hscsja03-afk/-BJT-/board/hardware/bjt/pcb_layout.png

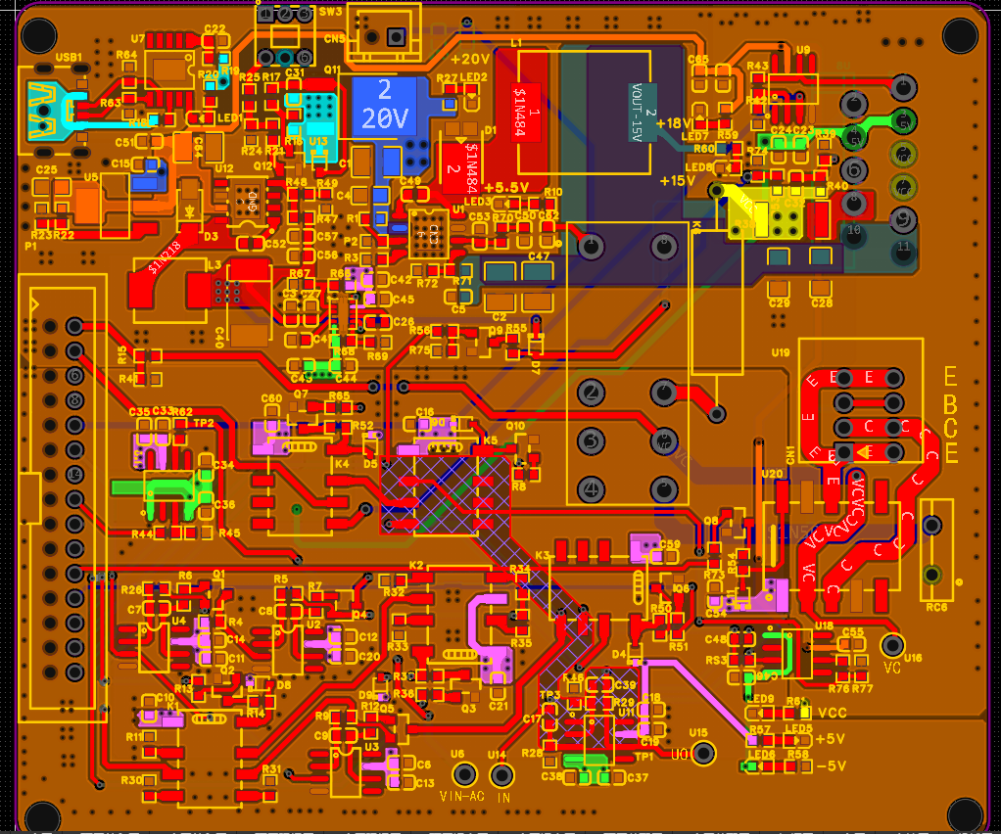
board/hardware/bjt/pcb_layout.png
