hscsja03-afk/-BJT-/board/hardware/bjt/pcb_3d.png

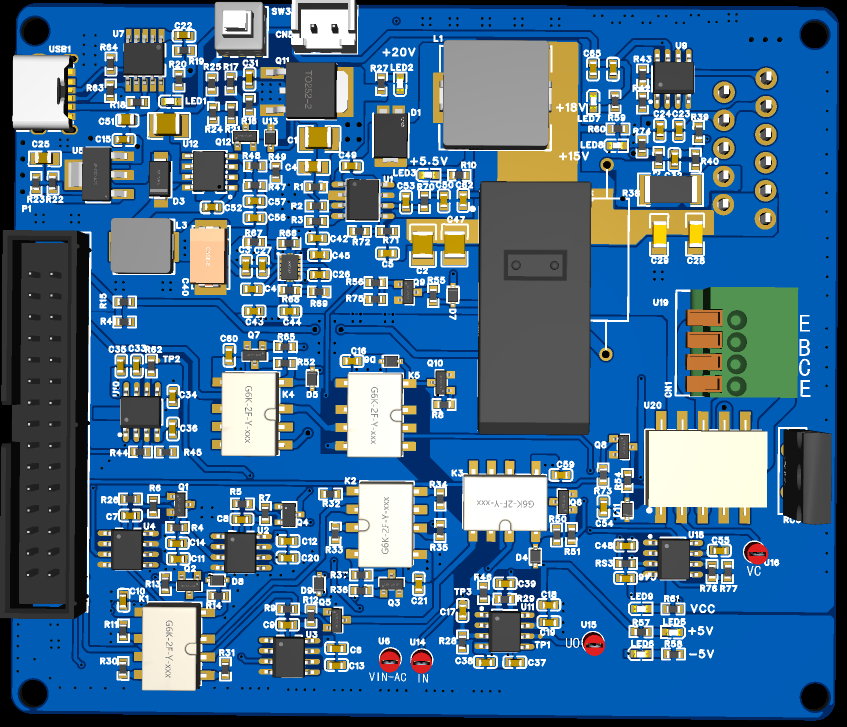
board/hardware/bjt/pcb_3d.png
