hscsja03-afk/-BJT-/readme.md

# 多功能三极管参数测量系统

基于 Zynq-7020、自制双通道高速 ADDA 底板和 BJT 测试板，集成三极管参数测量、信号发生器和双通道示波器。

| 功能 | 内容 |
| --- | --- |
| 三极管参数测量 | NPN/PNP 输入、输出、电流增益和交流特性，大功率器件脉冲测量 |
| 信号发生器 | 直流、正弦、方波、三角波及 CSV 自定义波形，按通道设置输出参数 |
| 双通道示波器 | 波形显示、帧内触发定位、A/B 游标、FFT 频谱及数据导出 |

## 工程目录

| 目录 | 内容与用途 |
| --- | --- |
| src/ | FPGA 逻辑、板端驱动和上位机源码 |
| sim/ | RTL 仿真和软件测试 |
| build/ | 构建脚本、依赖清单、时序与资源报告 |
| board/ | 硬件设计、位流、上板脚本、安装包和实测输出 |
| data/ | 校准表和器件手册 |
| skill/ | 可复用方法、校验脚本和记录模板 |
| report/ | 设计报告、开发记录和验证结果 |

## 运行上位机

下载并解压仓库，在 Windows x64 上双击 `board/launch.cmd`。首次启动会自动还原运行库，测量结果保存到 `measurements/`。

板端使用 PYNQ 2.7，默认地址 `192.168.0.4`、用户名 `xilinx`，密码在连接时输入。安装与位流加载见 [板端运行说明](board/readme.md)。

BJT 和电压测量使用 ADC 50 MHz；原始采样与频谱支持 62.5 MHz；DAC 时钟为 125 MHz。

## 源码运行与构建

电脑端使用 Python 3.13，在仓库根目录执行：

```powershell
.\build\setup.ps1
.\.venv\Scripts\python.exe build/checks/restore_archives.py
.\.venv\Scripts\python.exe -m zynq_bjt.desktop --workspace measurements
```

`restore_archives.py` 还原运行库、手册及实验数据，并检查 SHA256；加 `--group datasheets` 可只还原手册。

FPGA 使用 Vivado 2026.1，器件为 `xc7z020clg400-2`：

```powershell
.\build\rebuild_fpga.ps1 -Vivado "D:\FPGA\Xilix\2026.1\Vivado\bin\vivado.bat"
.\build\build_software.ps1
```

FPGA 工程输出在 `build/work/adc625_dac125/`，bit/HWH 与校验清单输出到 `build/dist/overlay/`；Python 安装包和 Windows 程序分别输出到 `build/dist/python/`、`build/dist/desktop/`。位流版本见 [板端运行说明](board/readme.md)，实现报告见 [工程验证与测试结果](report/verification.md)。

## 检查工程

```powershell
.\.venv\Scripts\python.exe build/checks/verify_package.py
.\.venv\Scripts\python.exe skill/pynq-overlay-audit/scripts/check_bundle.py board/overlay/manifest.json
$env:PYTHONPATH="$PWD/src/python"
.\.venv\Scripts\python.exe -m unittest discover -s sim/python -p "test_*.py" -v
.\.venv\Scripts\python.exe -m unittest discover -s src/python/tests -p "test_*.py" -v
```

`build/test.ps1` 运行软件测试，传入 `-Vivado` 可同时运行 RTL 仿真。`python build/checks/summarize_results.py` 计算实测比对表；加 `--plots` 生成曲线图。

## 材料入口

- [硬件设计](board/hardware/readme.md)：ADDA 底板与 BJT 测试板的可编辑工程、原理图、PCB 和网表。
- [设计报告 PDF](report/design_report.pdf)：设计原理、实现与实验结果。
- [提交材料索引](report/submission_checklist.md)：各项材料的位置。
- [实测索引](report/indexes/measurement_index.json)：24 组器件测量记录。
- [工程验证与测试结果](report/verification.md)：RTL、软件、综合实现与仪器比对。
- [实测指标汇总](report/measurements/summary.json)：24 组器件扫描、ADC 直流和 DAC 波形比对。
- [验证记录](report/validation/package_validation.json)：软件、RTL 和程序一致性检查。
- [技能包](skill/readme.md)：9 项可复用方法。

原始数据按 [归档索引](report/indexes/archive_index.json) 查找。[大模型协作记录](report/ai_collaboration.md) 精选四个案例，说明问题分析、方案取舍、验证结果和工程心得。

本项目编写的代码和文档采用 [MIT 许可](license.txt)。第三方代码、硬件资源、数据手册、字体及运行库保留各自版权与许可，见 [来源说明](report/source_provenance.md)。
