hscsja03-afk/-BJT-/skill/readme.md

# 可复用技能包

提供 PYNQ 位流校验、Zynq 启动诊断、时序分析、模拟校准和测量数据检查等可复用方法。按任务选择技能，替换板卡、接口、文件路径与验收条件即可复用。包含 9 项技能、两组独立校验脚本及实验/参数记录模板。

## 快速使用

1. 从下表选择任务，打开对应 `skill.md`。
2. 按入口准备输入并替换提示词中的方括号字段。
3. 运行操作步骤，填写 [实验记录](templates/experiment_record.md)，保存实际验证结果。
4. 换题目或板卡时重新填写接口与硬件条件。完整复制 `skill/` 可保留所有相对引用。

## 任务索引

| 技能 | 形式与适用场景 | 使用方法 | 已验证效果 | 失败或观察来源 | 失效条件 |
| --- | --- | --- | --- | --- | --- |
| [通用 PYNQ Overlay 校验](pynq-overlay-audit/skill.md) | 校验脚本、排错流程：换题目、换板卡或换 Vivado 构建时核对 bit/HWH、模块实例和地址。 | 填写 bit/HWH、实例、地址与哈希清单，运行 `check_bundle.py` 检查文件和地址 | 文件哈希、模块实例和地址校验；合成异名实例通过，错误地址与文件篡改触发拒绝。 | 早期只迁移 PL 文件，PS/DDR 配置没有随板卡匹配；物理通道名与 ADC A/B 顺序不同。 | 文件检查适用于包含 MODULE/MEMRANGE 的 HWH。更换元数据格式时先检查解析器；板上运行另需匹配 DDR、MIO、电压和时钟。 |
| [Zynq 启动与 DDR 分层定位](zynq-boot-ddr-diagnosis/skill.md) | 排错流程：FSBL 停滞、DDR 初始化失败、JTAG 可运行而自主启动异常。 | 按启动日志定位阶段，用 OCM 探针隔离 DDR，再按字节比较固定模式读写结果 | 项目中旧板最低字节错误与新板有限区域零错误形成对照；QSPI/eMMC 启动有独立冷启动记录。 | 曾将 OCM/禁用 DDR 的配置作为 Linux 启动基础，导致排查阶段混淆；仅依据软件 MMC 宏也容易误判拨码。 | DDR 完整型号、板卡版本和初始化来源必须对应。有限地址窗口的结果适用于该窗口；启动存储写入前保留可恢复副本。 |
| [FPGA 源码重建与时序核对](fpga-source-timing-closure/skill.md) | 工程工作流：迁移旧工程、变更采样时钟、检查外部 IO 时序。 | 收集 RTL/IP、约束和 PS 配置，以脚本重建并比较 WNS、WHS、CDC 和资源占用 | ADC62.5/DAC125 构建记录的建立/保持裕量为 0.394/0.041 ns；两档数字验证分别记录。 | 旧工程缓存和时钟变更容易造成“构建成功”与实际约束不一致；采样率提高也改变模拟校准条件。 | 目标器件、IO 电压、板级延时和 IP 版本改变时重新建立约束。时序裕量对应指定构建，电压精度使用独立校准结果。 |
| [寄存器到模拟输出定位](register-to-analog-debug/skill.md) | 校验脚本、踩坑流程：寄存器回读正常但输出异常；需要在实物照片上定位芯片或测点。 | 固定接线与仪表设置，对照写入顺序、回读和电压；用 `locate_epcb.py` 查 PCB 位号 | TX1 单次提交修正有 14 项示波器检查和独立冷启动复验；EPRO 定位脚本通过 U99 合成用例、缺失位号和多 PCB 选择测试，并查得PCB 中 U7 的坐标。 | 停用期间重复写 DATA 时出现回读正确而输出异常；图片标签曾误指 TX1 SMA，查询原理图和 PCB 后改指 U7。 | 初始化顺序修正须由目标器件的现象支持。定位脚本读取行式 JSON EPRO，可处理一层外部 ZIP；PCB坐标与照片像素需通过方向和锚点转换。 |
| [混合信号校准与单位管理](mixed-signal-calibration/skill.md) | 提示词工作流、实验模板：ADC/DAC 校准、预热漂移、量程或时钟切换。 | 固定量程、负载和温态，分别采集标定点与独立检查点，记录误差和单位换算 | 历史 ADC50 独立检查点最大偏差为 RX1 0.338 mV、RX2 0.394 mV（相对发生器标称值）；TX3 固定码正弦稳定窗口与直流中心分别判定。 | 曾混用峰值、Vpp、RMS和基波幅度；跟随预热漂移反复调码会掩盖稳定性问题。 | 改变板卡、改板、时钟、负载、频率或温态时重新评估校准适用范围。正弦换算关系仅用于相应波形定义。 |
| [测量扫描与性能对照](measurement-sweep-integrity/skill.md) | 提示词工作流、实验模板：输入/输出/电流增益/交流扫描、分段步进、反馈搜索及提速。 | 生成扫描计划，逐点保存设定、测点与耗时，用同点数、同条件比较改动前后 | 历史同条件输出扫描 111 点耗时由 63.397 s 降至 43.360 s；49 个偏置点的增益扫描由 169.181 s 降至 59.514 s。 | 深拷贝和重复传输影响扫描耗时；不同范围或点数的扫描直接比较会夸大优化效果。 | 负载、器件档位、等待窗口或偏置误差改变时重新建立对照。模型拟合只在有效测量范围内解释，外推结果单独标注。 |
| [上位机与板端代理一致发行](desktop-agent-release/skill.md) | 排错流程、发行模板：Windows GUI、板端 Python 代理、位流和校准数据的打包与部署。 | 建立程序、代理与数据哈希清单，在独立目录打包，部署后读回校验并检查启动入口 | 项目已采用包/代理/数据读回校验和明确的启动入口；取消、迟到帧、路径定位和初始化顺序有对应离线回归。 | 曾出现源码修复但代理包仍旧、数据依赖启动目录、停止后的迟到帧刷新界面等问题。 | 版本和路径需从目标工程取得。程序、代理、位流及数据作为一组回滚；界面预览、程序自检、服务重启和冷启动各有自己的验收条件。 |
| [数据手册参数与页码追溯](datasheet-parameters/skill.md) | 审阅工作流、案例模板：晶体管或其他电子器件 PDF 参数表整理。 | 填写 `parameter_record.json`，逐项核对型号、页码、单位、参数角色和测试条件 | 项目参数流程采用页码、原表单元格和条件关联，参数行可回到来源页面；本包提供可直接套用的参数记录模板。 | 合并表头、不同型号列、PNP负号及最大额定值与推荐工作条件容易混淆。 | 扫描PDF需OCR和页面比对；缺少型号或条件的行保持原文记录，取得来源后再换算。手册额定值与实际扫描范围分别管理。 |
| [技术海报与证据图组织](technical-poster-evidence/skill.md) | 提示词工作流、案例模板：将硬件、PYNQ架构、上位机和实测结果组织为单页技术海报。 | 建立素材表，将架构、实物和实测结果组织为可编辑对象，再核对图表与版面 | 项目完成单页英文 A4 海报、可编辑架构和原始数据图表；经过 PowerPoint 打开及 PDF 渲染检查，并加入用户提供的上位机界面。 | 首版信息密度接近报告；改成视觉版后遗漏 PYNQ 架构；芯片指引线曾落在接口。这些反馈形成内容清单和源文件定位步骤。 | 模板、语言、匿名和打印要求以具体任务为准。效果图用于表达，器件定位采用原图与PCB；界面中的模拟标识和空曲线保持原状。 |

## 本队题目之外的应用场景

下表列出各项方法可迁移的任务。具体替换项和输出要求同时写入各项 `skill.md`；已验证效果按本项目的实际记录列在任务索引中。

| 技能 | 其他应用场景 | 迁移时替换的内容 |
| --- | --- | --- |
| [通用 PYNQ Overlay 校验](pynq-overlay-audit/skill.md) | PYNQ 图像处理加速器、数据采集卡、电机控制外设 | bit/HWH、外设实例、地址窗口与哈希 |
| [Zynq 启动与 DDR 分层定位](zynq-boot-ddr-diagnosis/skill.md) | 其他 Zynq-7000 核心板、采集终端和机器人控制板的启动排错 | DDR 型号、PS 配置、启动介质与日志 |
| [FPGA 源码重建与时序核对](fpga-source-timing-closure/skill.md) | 摄像头接口、数字滤波器、高速传感器采集和 FPGA 工程版本迁移 | 器件、时钟、IO 和板级时序约束 |
| [寄存器到模拟输出定位](register-to-analog-debug/skill.md) | DAC 信号源、可编程电源、可编程增益放大器的驱动调试 | 寄存器、总线、启停顺序和测点 |
| [混合信号校准与单位管理](mixed-signal-calibration/skill.md) | 温度/压力传感器采集、信号发生器、可编程电源和 ADC/DAC 测试 | 物理量、仪器、量程、负载与温态 |
| [测量扫描与性能对照](measurement-sweep-integrity/skill.md) | MOSFET 或二极管伏安测试、滤波器扫频、传感器自动标定 | 扫描变量、偏置控制、等待条件与拟合模型 |
| [上位机与板端代理一致发行](desktop-agent-release/skill.md) | 上位机加嵌入式代理的采集终端、自动测试台和机器人调试工具 | 通信协议、启动入口、代理模块和配置清单 |
| [数据手册参数与页码追溯](datasheet-parameters/skill.md) | MOSFET、运算放大器、ADC/DAC、电源芯片的选型与参数整理 | 器件型号、参数符号、单位和测试条件 |
| [技术海报与证据图组织](technical-poster-evidence/skill.md) | 其他嵌入式作品的科研展示、竞赛展板和项目汇报图 | 架构、照片、界面、实验结果与展示尺寸 |

## 通用 PYNQ 校验

`pynq-overlay-audit` 通过清单输入位流、HWH、外设实例和地址，脚本不固定板卡、题目或工程路径。`--example` 输出清单格式；自带测试覆盖合法配置、地址错误和哈希错误。PS/DDR、电压与模拟条件按目标板另行核对。

## 单独复制后的使用

复制整个 `skill/` 目录即可带走说明、提示词、模板、脚本、测试和许可。在复制后的目录内执行：

```sh
python pynq-overlay-audit/scripts/check_bundle.py --example
python -m unittest discover -s pynq-overlay-audit/scripts -p "test_*.py" -v
python -m unittest discover -s register-to-analog-debug/scripts -p "test_*.py" -v
```

两组脚本仅使用 Python 标准库。处理自己的工程时，将位流、HWH、外设实例和地址填入清单，运行 `check_bundle.py path/to/manifest.json`；路径相对于清单所在目录解析。其余流程使用各项 `skill.md` 的输入条件和操作步骤，并填写本目录的实验模板。

通用 PYNQ 校验以文件和清单为输入，可以独立于本项目使用。测试包含 `image_filter_0` 与 `motor_ctrl_1` 两种外设实例、不同地址窗口以及从其他工作目录执行的情况；这些合成用例检查工具的通用性和路径处理。

## 验证记录

参见 [validation.json](validation.json)。脚本测试使用合成配置，硬件案例采用指定日期、版本和条件的记录。协作提示词是从上述过程提炼的复用模板；原始对话按实验模板关联保存。

## 开源协议

本项目编写的技能文档、模板和脚本采用 [MIT 许可](license.txt)，允许使用、修改和再分发，分发时保留版权与许可声明。第三方代码、硬件资源、数据手册、字体及依赖保留各自版权与许可。
