hscsja03-afk/-BJT-/sim/readme.md

# RTL 仿真与软件测试

RTL 仿真与软件测试。

从仓库根目录执行：

```powershell
.\build\test.ps1 -Vivado "C:\AMD\2026.1\Vivado\bin\vivado.bat"
```

| 目录 | 内容 |
| --- | --- |
| [baremetal/](baremetal/) | 裸机 C 驱动与时间基准测试 |
| [fixtures/](fixtures/) | 仿真测试输入 |
| [python/](python/) | 驱动、扫描、分析与界面测试 |
| [results/](results/) | RTL、软件与程序运行结果 |
| [rtl/](rtl/) | AXI、ADC、DAC 与 LCD 仿真 |
