hscsja03-afk/-BJT-/build/reports/readme.md

# FPGA 各版本资源与时序报告

FPGA 各版本资源与时序报告。

| 目录 | 内容 |
| --- | --- |
| [adc625_mmcm_20261102/](adc625_mmcm_20261102/) | ADC 62.5 MHz 与 DAC 125 MHz 实现报告 |
| [baseline50/](baseline50/) | ADC/DAC 50 MHz 基线实现报告 |
| [lcd_ddr_20261104/](lcd_ddr_20261104/) | LCD DDR 2026-11-04 构建与实现报告 |
| [lcd_ddr_final_20261103/](lcd_ddr_final_20261103/) | LCD DDR 2026-11-03 实现报告 |
| [target125_250/](target125_250/) | ADC 125 MHz 与 DAC 250 MHz 时序报告 |
