hscsja03-afk/-BJT-/sim/rtl/readme.md

# AXI、ADC、DAC 与 LCD 仿真

AXI、ADC、DAC 与 LCD 仿真。

## 文件

- [run_adc_depth.tcl](run_adc_depth.tcl)
- [run_axi.tcl](run_axi.tcl)
- [run_lcd.tcl](run_lcd.tcl)
- [run_lcd_ddr.tcl](run_lcd_ddr.tcl)
- [tb_adc_depth.sv](tb_adc_depth.sv)
- [tb_adc_statistics.sv](tb_adc_statistics.sv)
- [tb_adc_stride.sv](tb_adc_stride.sv)
- [tb_adda.sv](tb_adda.sv)
- [tb_dac_5mhz.sv](tb_dac_5mhz.sv)
- [tb_dac_axi.sv](tb_dac_axi.sv)
- [tb_lcd_ddr.sv](tb_lcd_ddr.sv)
- [tb_lcd_graphics.sv](tb_lcd_graphics.sv)
