hscsja03-afk/-BJT-/sim/baremetal/readme.md

# 裸机 C 驱动与时间基准测试

裸机 C 驱动与时间基准测试。

从仓库根目录执行：

```powershell
.\sim\baremetal\run_baremetal_c.ps1 -Gcc "C:\path\to\gcc.exe"
```

## 文件

- [baremetal_faults.c](baremetal_faults.c)
- [baremetal_timebase.c](baremetal_timebase.c)
- [run_baremetal_c.ps1](run_baremetal_c.ps1)
