hscsja03-afk/-BJT-/board/storage/readme.md

# QSPI 与 eMMC 映像工具

QSPI 备份与候选映像、eMMC 映像写入、网络传输及存储状态检查。

## 文件

- [backup_qspi_ram.tcl](backup_qspi_ram.tcl)
- [build_emmc_image_writer.ps1](build_emmc_image_writer.ps1)
- [build_emmc_network_writer.ps1](build_emmc_network_writer.ps1)
- [emmc_image_writer.c](emmc_image_writer.c)
- [flash_tool_help.tcl](flash_tool_help.tcl)
- [inspect_emmc_boot_readonly.tcl](inspect_emmc_boot_readonly.tcl)
- [monitor_emmc_network_writer.tcl](monitor_emmc_network_writer.tcl)
- [poweroff_for_flash.py](poweroff_for_flash.py)
- [prepare_pynq_qspi.bif](prepare_pynq_qspi.bif)
- [run_emmc_image_writer.ps1](run_emmc_image_writer.ps1)
- [run_emmc_image_writer.tcl](run_emmc_image_writer.tcl)
- [run_emmc_network_writer.ps1](run_emmc_network_writer.ps1)
- [run_emmc_network_writer.tcl](run_emmc_network_writer.tcl)
- [send_emmc_image_network.py](send_emmc_image_network.py)
- [stage_qspi_candidate.tcl](stage_qspi_candidate.tcl)
