hscsja03-afk/-BJT-/board/lcd/readme.md

# LCD 显示、帧缓冲与设备控制

管理本地显示、DDR 帧缓冲、显示切换及上位机共享波形。

## 文件

- [lcd_ddr_check.py](lcd_ddr_check.py)
- [lcd_live.py](lcd_live.py)
- [lcd_native_switch.py](lcd_native_switch.py)
- [manage_lcd_ddr.py](manage_lcd_ddr.py)
- [manage_lcd_native.py](manage_lcd_native.py)
- [run_lcd_live.py](run_lcd_live.py)
- [stage_lcd_candidate.py](stage_lcd_candidate.py)
- [verify_shared_lcd.py](verify_shared_lcd.py)
