hscsja03-afk/-BJT-/board/diagnostics/readme.md

# 采样、输出、DDR 与器件诊断

采样、输出、DDR 与器件诊断。

| 目录 | 内容 |
| --- | --- |
| [adc/](adc/) | ADC 采样时钟与频谱检查 |
| [bjt/](bjt/) | 三极管接线、反馈与扫描检查 |
| [ddr/](ddr/) | DDR 初始化、训练与字节通道诊断 |
| [tx1/](tx1/) | TX1 总线、寄存器与输出检查 |
| [tx23/](tx23/) | TX2/TX3 波形、零点与稳定性检查 |
