hscsja03-afk/-BJT-/board/connection/readme.md

# SSH、串口与设备连接

SSH、串口与设备连接。

## 文件

- [capture_uart.ps1](capture_uart.ps1)
- [configure_pynq_test_network.sh](configure_pynq_test_network.sh)
- [deploy_desktop_uart.py](deploy_desktop_uart.py)
- [pynq_ssh.py](pynq_ssh.py)
- [pynq_uart.py](pynq_uart.py)
- [uart_root_task.py](uart_root_task.py)
- [verify_desktop_connection.py](verify_desktop_connection.py)
- [verify_desktop_initialize.py](verify_desktop_initialize.py)
