hscsja03-afk/-BJT-/build/reports/target125_250/readme.md

# ADC 125 MHz 与 DAC 250 MHz 时序报告

ADC 125 MHz 与 DAC 250 MHz 时序报告。

## 文件

- [bus_skew.rpt](bus_skew.rpt)
- [cdc.rpt](cdc.rpt)
- [drc.rpt](drc.rpt)
- [io.rpt](io.rpt)
- [ps_config.txt](ps_config.txt)
- [timing.xdc](timing.xdc)
- [timing_summary.rpt](timing_summary.rpt)
- [utilization.rpt](utilization.rpt)
