hscsja03-afk/-BJT-/build/reports/baseline50/readme.md

# ADC/DAC 50 MHz 基线实现报告

ADC/DAC 50 MHz 基线实现报告。

## 文件

- [build_status.txt](build_status.txt)
- [bus_skew.rpt](bus_skew.rpt)
- [cdc.rpt](cdc.rpt)
- [drc.rpt](drc.rpt)
- [io.rpt](io.rpt)
- [ps_config.txt](ps_config.txt)
- [timing.xdc](timing.xdc)
- [timing_summary.rpt](timing_summary.rpt)
- [utilization.rpt](utilization.rpt)
