hscsja03-afk/-BJT-/build/reports/adc625_mmcm_20261102/readme.md

# ADC 62.5 MHz 与 DAC 125 MHz 实现报告

ADC 62.5 MHz 与 DAC 125 MHz 实现报告。

## 文件

- [build_status.txt](build_status.txt)
- [bus_skew.rpt](bus_skew.rpt)
- [cdc.rpt](cdc.rpt)
- [drc.rpt](drc.rpt)
- [drc_50mhz.rpt](drc_50mhz.rpt)
- [io.rpt](io.rpt)
- [ps_config.txt](ps_config.txt)
- [timing.xdc](timing.xdc)
- [timing_50mhz.rpt](timing_50mhz.rpt)
- [timing_summary.rpt](timing_summary.rpt)
- [utilization.rpt](utilization.rpt)
