hscsja03-afk/-BJT-/board/hardware/bjt/readme.md

# 三极管测试板硬件设计

包含可编辑工程、网表、PCB 布局与三维图，以及电流源、功率放大、电源、极性切换和测量切换等电路图。

- [hardware_project.epro2](hardware_project.epro2)
- [netlist.tel](netlist.tel)
- [pcb_3d.png](pcb_3d.png)
- [pcb_layout.png](pcb_layout.png)
- [schematic_ac.png](schematic_ac.png)
- [schematic_base_current_source.png](schematic_base_current_source.png)
- [schematic_dual_supply.png](schematic_dual_supply.png)
- [schematic_interface.png](schematic_interface.png)
- [schematic_measurement_switch.png](schematic_measurement_switch.png)
- [schematic_polarity_switch.png](schematic_polarity_switch.png)
- [schematic_power_amplifier.png](schematic_power_amplifier.png)
