hscsja03-afk/-BJT-/board/hardware/adda/readme.md

# 双通道高速 ADDA 硬件设计

包含可编辑工程、原理图、网表、PCB 三维图，以及 AD9747 固件说明和 AD9516 配置资料。

- [ad9516_config_01.png](ad9516_config_01.png)
- [ad9516_config_02.png](ad9516_config_02.png)
- [ad9747_firmware_guide.md](ad9747_firmware_guide.md)
- [design_notes.xlsx](design_notes.xlsx)
- [hardware_project.epro](hardware_project.epro)
- [netlist.tel](netlist.tel)
- [pcb_3d.png](pcb_3d.png)
- [schematic.pdf](schematic.pdf)
