hscsja03-afk/-BJT-/src/rtl/touch/readme.md

# 触摸屏控制逻辑

触摸屏控制逻辑。

## 文件

- [i2c_dri.v](i2c_dri.v)
- [touch_cdc.sv](touch_cdc.sv)
- [touch_dri.v](touch_dri.v)
- [touch_top.v](touch_top.v)
