hscsja03-afk/-BJT-/board/diagnostics/adc/readme.md

# ADC 采样时钟与频谱检查

ADC 采样时钟与频谱检查。

## 文件

- [check_adc_dual_rate.py](check_adc_dual_rate.py)
- [check_adc_rate_candidate.py](check_adc_rate_candidate.py)
- [check_rx1_square_fft.py](check_rx1_square_fft.py)
- [stage_adc4096.py](stage_adc4096.py)
- [stage_adc_rate_candidate.py](stage_adc_rate_candidate.py)
- [verify_adc_rate_release.py](verify_adc_rate_release.py)
