hscsja03-afk/-BJT-/report/design_report.md

# 多功能三极管参数测量系统工程说明

## 任务与结构

本系统集成三极管参数测量、信号发生器和双通道示波器。FPGA 完成确定时序的采集、激励和接口控制，PS 软件管理设备，上位机组织扫描、波形显示、分析与结果保存。三极管测量覆盖 NPN/PNP 的小功率与大功率档；信号发生器支持直流、正弦、方波、三角波和 CSV 自定义波形；示波器提供波形显示、帧内触发定位、游标和 FFT 频谱。

两套硬件的可编辑工程、原理图、PCB 预览和网表见 [硬件设计资料](../board/hardware/readme.md)。

```text
Windows 上位机 -- SSH / JSON -- Zynq PS（PYNQ / Python）
                                    |
                                 AXI GP0
                                    |
                 PL：ADDA / 波形发生 / GPIO / LCD
                      |                     |
                 双路 ADC              TX1 / TX2 / TX3
                      |                     |
                      +---- BJT 测试板 -----+
```

PL 地址窗口为 0x43C00000、64 KiB。ADC 支持每路 256～4096 点和 1～256 倍抽取；数据经分帧读取送到主机。抽取用于扩展记录时间窗口，输入频率按抽取后采样率的奈奎斯特条件选择。ADC 50/62.5 MHz、DAC 125 MHz 为物理转换时钟，主机采用分帧传输。

RTL 主体位于 src/rtl/adda_core.v；ADC 捕获、统计与时钟分别在 adc_capture.v、adc_statistics.sv、adc_clocking.v；DAC 波形和时钟分别在 dac_awg.v、dac_generator.v、dac_clocking.v。上位机入口为 src/python/zynq_bjt/desktop.py；寄存器、会话、扫描与分析由 mmio.py、runtime.py、desktop_session.py、characteristics.py 等模块组织。

## 测量与数据

输入测量使用反馈搜索控制工作点；输出特性按基极条件分组扫描，并可拟合 Early 参数。电流增益由工作点电流计算，交流测量拟合频率响应，并保存输入阻抗及特征频率分析。大功率脉冲方式在稳定高电平窗口取样，频率、占空比和尝试次数随记录保存。

物理通道为测试板 ADC2 对应 ADDA RX1，测试板 ADC1 对应 ADDA RX2。输入模式的 VB 衰减比例、输出模式的 VCC 比例及不同档位的电阻独立配置。当前配置以 data/bjt_parameter_basis.json、frontend.json 和每次 run.json 为准，各档位独立读取换算参数。PNP 输入的 VE 使用实测换算表，相关数据见 data/ve_feedback_calibration.json。

每次运行保存配置、校准身份、测点 CSV、原始帧、结束状态及清理结果。PNP 交流增益、输入电阻曲线及导出图片均使用实际采集的测点。包内代表性数据按 [实测索引](indexes/measurement_index.json) 定位；选取规则为每个档位、项目及方法中最近一次 complete 且 simulated=false 的记录。记录同时保存器件身份、标定条件和拟合结果。

## 时序与资源

下表直接摘取包内 Vivado 报告。各版本的功能配置与资源占用一并对照。

| 实现（ADC/DAC） | LUT | 寄存器 | BRAM Tile | DSP | WNS/ns | WHS/ns |
| --- | --- | --- | --- | --- | --- | --- |
| 50/50 MHz 历史基线 | 3158 | 2399 | 40 | 0 | 1.813 | 0.025 |
| 62.5/125 MHz 正式实现 | 3784 | 3181 | 67 | 2 | 0.394 | 0.041 |
| 125/250 MHz 目标尝试 | 3157 | 2399 | 40 | 0 | -8.235 | -2.072 |
| 62.5/125 MHz LCD DDR 构建（2026-11-04） | 3889 | 3184 | 123 | 2 | 0.394 | 0.035 |

正式实现通过既有建立/保持时间检查，保留 DRC、CDC 和总线偏斜报告。125/250 MHz 配置的负裕量见表，正式输出采用 62.5/125 MHz 配置。ADC 的 IOB 寄存器和 MMCM 时钟补偿解决了提高物理采样时钟时的保持时间问题；62.5 MHz 相对 50 MHz 的采样率增加 25%；扫描耗时另由测量记录统计。

2026-11-04 LCD DDR 构建的位流位于 `board/overlay/build_20261104/`，源码摘要、资源和时序报告位于 `build/reports/lcd_ddr_20261104/`。仪器与三极管实测记录对应采集时的位流，具体哈希及比对指标见 [工程验证与测试结果](verification.md)。

## 验证方法与工作条件

本包收录软件行为回归、RTL 仿真脚本及历史板级证据。时钟升频的双 ADC 数字模式、原始采集及频谱验证见 adc_rate_raise_20261102。RX1/RX2 直流校准以发生器标称值为基准；TX2/TX3 的参考为示波器，频率、幅度、负载及带宽条件逐点保留。精度数据按对应通道、参考仪器及测量条件报告。

本包的软件回归、RTL 仿真、运行程序及文件一致性检查见 [工程验证记录](validation/package_validation.json)。板级记录按时间、位流哈希和校准身份索引。源码重建后按新时序报告、数字自检、模拟测量和校准身份完成版本验收。

## 大模型协作与方案取舍

协作集中在启动定位、驱动行为、时序收敛和模拟校准四类问题。模型参与整理候选原因、代码路径和实验数据，方案通过对照实验筛选：

- DDR 定位采用固定探针和按字节统计，版本回退与训练起点调整均由读写结果判断；最低字节持续出错，使排查重点转向相应板级链路。
- TX1 将停用期间的目标码缓存在软件中，启用前单次写入 DATA，替换停用期间重复写入的顺序；示波器检查与冷启动复验共同确认输出行为。
- ADC/DAC 采用具有正建立、保持裕量的 62.5/125 MHz 实现，放弃该次存在负裕量的 125/250 MHz 候选；采样时序和电压校准分别验收。
- TX2/TX3 采用分通道校准和固定条件的开关对照，将单路标定误差与同时工作引入的偏移分开记录。

这些过程形成的经验是：将解释转为可检验的假设，保留相同条件下的对照结果，再决定采用、修改或放弃方案。交互要点、纠错过程、数值和依据见 [大模型协作记录](ai_collaboration.md)。

## 复现与经验

完整运行顺序见根目录 readme.md 和 board/readme.md。先核对位流/HWH、PS 配置和物理通道，再验证数字链路，最后执行模拟校准与器件扫描。更新上位机时同时核对板端代理和数据表，避免只有界面升级而设备行为仍停留在旧版。

skill/ 将位流配对、启动诊断、时序迁移、寄存器到模拟链路定位、校准、扫描完整性、发行一致性和数据手册提取整理为九项方法。各方法提供操作条件、问题定位步骤和验证数据。
