hscsja03-afk/-BJT-/board/desktop/desktop_workbench.md

# 上位机使用

仓库版入口为 board/launch.cmd，首次启动自动还原运行库。电脑程序、板端代理和校准数据按同一源码构建。连接后执行初始化及数字自检，再按界面确认测试板接线与档位。BJT 和电压换算使用 ADC 50 MHz，62.5 MHz 用于原始码采集和频谱分析。

测量数据保存在 measurements/，包含配置、校准身份、原始帧和测点表。取消或结束测量时保存已取得的数据并关闭输出。源码环境、构建和完整复现命令见根目录 readme.md。
