hscsja03-afk/-BJT-/report/readme.md

# 设计报告、实测结果与协作记录

设计报告、实测结果与协作记录。

| 目录 | 内容 |
| --- | --- |
| [hardware/](hardware/) | 启动、接口与板级实测记录 |
| [indexes/](indexes/) | 工程、报告与数据索引 |
| [measurements/](measurements/) | 实测指标统计 |
| [validation/](validation/) | 软件、程序包与工程校验记录 |

## 文件

- [ai_collaboration.md](ai_collaboration.md)
- [design_report.md](design_report.md)
- [design_report.pdf](design_report.pdf)
- [source_provenance.md](source_provenance.md)
- [submission_checklist.md](submission_checklist.md)
- [verification.md](verification.md)
