hscsja03-afk/-BJT-/src/readme.md

# FPGA、板端与上位机源码

FPGA、板端与上位机源码。

| 目录 | 内容 |
| --- | --- |
| [assets/](assets/) | LCD 字体与显示资源 |
| [baremetal/](baremetal/) | 裸机驱动、启动与时间基准 |
| [constraints/](constraints/) | FPGA 引脚、电平与时序约束 |
| [python/](python/) | 测量驱动、板端代理与上位机程序 |
| [rtl/](rtl/) | ADDA、AXI、时钟与显示逻辑 |
