hscsja03-afk/-BJT-/data/readme.md

# 校准参数、器件手册与实测数据

校准参数、器件手册与实测数据。

| 目录 | 内容 |
| --- | --- |
| [datasheets/](datasheets/) | 器件手册与参数资料 |
| [evidence/](evidence/) | 采集、校准与板级实验数据归档 |
| [measurements/](measurements/) | ADC、DAC 与三极管实测比对 |
| [ui/](ui/) | 上位机界面资源 |

## 文件

- [adc_input_limits.json](adc_input_limits.json)
- [bjt_parameter_basis.json](bjt_parameter_basis.json)
- [dac_calibration.json](dac_calibration.json)
- [frontend.json](frontend.json)
- [hardware_revision.json](hardware_revision.json)
- [runtime_manifest.json](runtime_manifest.json)
- [rx1_dc_calibration.json](rx1_dc_calibration.json)
- [rx2_calibration.json](rx2_calibration.json)
- [tx2_waveform_calibration.json](tx2_waveform_calibration.json)
- [tx3_waveform_calibration.json](tx3_waveform_calibration.json)
- [ve_feedback_calibration.json](ve_feedback_calibration.json)
