hscsja03-afk/-BJT-/report/indexes/readme.md

# 工程、报告与数据索引

工程、报告与数据索引。

## 文件

- [archive_index.json](archive_index.json)
- [document_sources.json](document_sources.json)
- [measurement_index.json](measurement_index.json)
- [repository_layout.json](repository_layout.json)
