hscsja03-afk/-BJT-/report/hardware/readme.md

# 启动、接口与板级实测记录

启动、接口与板级实测记录。

## 文件

- [baremetal_hardware_evidence.json](baremetal_hardware_evidence.json)
- [ddr_new_board_20261029.json](ddr_new_board_20261029.json)
- [desktop_initialize_fixed_v2_20261030.json](desktop_initialize_fixed_v2_20261030.json)
- [desktop_tx1_agent_deploy_20261030.json](desktop_tx1_agent_deploy_20261030.json)
- [desktop_tx1_fix_packaged_20261030.json](desktop_tx1_fix_packaged_20261030.json)
- [desktop_tx1_fix_promoted_20261030.json](desktop_tx1_fix_promoted_20261030.json)
- [factory_sd_evidence.json](factory_sd_evidence.json)
- [hardware_evidence.json](hardware_evidence.json)
- [nanya_profile_audit.json](nanya_profile_audit.json)
- [pynq_custom50_hardware_evidence_20261030.json](pynq_custom50_hardware_evidence_20261030.json)
- [pynq_custom50_jtag_20261030_003445.json](pynq_custom50_jtag_20261030_003445.json)
- [pynq_linux_overlay_20261030.json](pynq_linux_overlay_20261030.json)
- [qspi_coldboot_verify_20261030.json](qspi_coldboot_verify_20261030.json)
- [tx1_fix_coldboot_verification_20261030.json](tx1_fix_coldboot_verification_20261030.json)
- [tx1_fix_startup_verification_20261030.json](tx1_fix_startup_verification_20261030.json)
- [tx1_pynq_scope_acceptance_20261030.json](tx1_pynq_scope_acceptance_20261030.json)
- [tx1_pynq_scope_coldboot_20261030.json](tx1_pynq_scope_coldboot_20261030.json)
- [tx1_root_cause_20261030.json](tx1_root_cause_20261030.json)
- [tx1_startup_agent_update_20261030.json](tx1_startup_agent_update_20261030.json)
