hscsja03-afk/-BJT-/src/rtl/readme.md

# ADDA、AXI、时钟与显示逻辑

ADDA、AXI、时钟与显示逻辑。

| 目录 | 内容 |
| --- | --- |
| [touch/](touch/) | 触摸屏控制逻辑 |

## 文件

- [adc_capture.v](adc_capture.v)
- [adc_clocking.v](adc_clocking.v)
- [adc_statistics.sv](adc_statistics.sv)
- [adda_core.v](adda_core.v)
- [adda_dac_gui_top.v](adda_dac_gui_top.v)
- [cdc_sync.v](cdc_sync.v)
- [dac_awg.v](dac_awg.v)
- [dac_clocking.v](dac_clocking.v)
- [dac_generator.v](dac_generator.v)
- [dac_text.sv](dac_text.sv)
- [gpio_control.sv](gpio_control.sv)
- [gpio_ui.sv](gpio_ui.sv)
- [lcd_ddr_reader.sv](lcd_ddr_reader.sv)
- [lcd_gpio_top.sv](lcd_gpio_top.sv)
- [lcd_graphics.sv](lcd_graphics.sv)
- [lcd_output_stage.sv](lcd_output_stage.sv)
- [lcd_timing.sv](lcd_timing.sv)
- [sine256.mem](sine256.mem)
