hscsja03-afk/-BJT-/src/constraints/readme.md

# FPGA 引脚、电平与时序约束

FPGA 引脚、电平与时序约束。

## 文件

- [gpio_pins.xdc](gpio_pins.xdc)
- [lcd_pins.xdc](lcd_pins.xdc)
- [lcd_timing.xdc](lcd_timing.xdc)
- [pins.xdc](pins.xdc)
- [timing.xdc](timing.xdc)
- [tx1.xdc](tx1.xdc)
