hscsja03-afk/-BJT-/src/baremetal/readme.md

# 裸机驱动、启动与时间基准

裸机驱动、启动与时间基准。

## 文件

- [adda.c](adda.c)
- [adda.h](adda.h)
- [main.c](main.c)
- [timebase.h](timebase.h)
