hscsja03-afk/-BJT-/src/assets/readme.md

# LCD 字体与显示资源

LCD 字体与显示资源。

## 文件

- [font.mem](font.mem)
- [gpio_background.mem](gpio_background.mem)
