hscsja03-afk/-BJT-/skill/templates/readme.md

# 实验记录与参数表模板

实验记录与参数表模板。

## 文件

- [experiment_record.md](experiment_record.md)
- [parameter_record.json](parameter_record.json)
