hscsja03-afk/-BJT-/sim/fixtures/readme.md

# 仿真测试输入

仿真测试输入。

## 文件

- [npn_pulse_noisy_plateau.json](npn_pulse_noisy_plateau.json)
- [pnp_pulse_noisy_plateau.json](pnp_pulse_noisy_plateau.json)
- [pulse_zero_noise.json](pulse_zero_noise.json)
