hscsja03-afk/-BJT-/data/ui/readme.md

# 上位机界面资源

上位机界面资源。

## 文件

- [fpga_competition_10th_hd.png](fpga_competition_10th_hd.png)
- [fpga_competition_10th_hd.source.json](fpga_competition_10th_hd.source.json)
