hscsja03-afk/-BJT-/data/evidence/readme.md

# 采集、校准与板级实验数据归档

各 ZIP 对应一个实验主题；归档成员和校验值见 build/archive_manifest.json。

## 文件

- [evidence_adc_rate_raise_20261102.zip](evidence_adc_rate_raise_20261102.zip)
- [evidence_bjt_all_profiles_20261030.zip](evidence_bjt_all_profiles_20261030.zip)
- [evidence_desktop_fast_fixed_axes_20261031.zip](evidence_desktop_fast_fixed_axes_20261031.zip)
- [evidence_desktop_progressive_20261102.zip](evidence_desktop_progressive_20261102.zip)
- [evidence_desktop_responsiveness_20261031.zip](evidence_desktop_responsiveness_20261031.zip)
- [evidence_evidence.zip](evidence_evidence.zip)
- [evidence_input_settling_20261101.zip](evidence_input_settling_20261101.zip)
- [evidence_lcd_ddr_20261103.zip](evidence_lcd_ddr_20261103.zip)
- [evidence_linked_sweep_parameters_20261031.zip](evidence_linked_sweep_parameters_20261031.zip)
- [evidence_npn_pulse_fix_20261103.zip](evidence_npn_pulse_fix_20261103.zip)
- [evidence_pnp_pulse_fix_20261103.zip](evidence_pnp_pulse_fix_20261103.zip)
- [evidence_pnp_pulse_window_20261103.zip.001](evidence_pnp_pulse_window_20261103.zip.001)
- [evidence_pnp_pulse_window_20261103.zip.002](evidence_pnp_pulse_window_20261103.zip.002)
- [evidence_pnp_pulse_window_20261103.zip.003](evidence_pnp_pulse_window_20261103.zip.003)
- [evidence_pnp_pulse_window_20261103.zip.004](evidence_pnp_pulse_window_20261103.zip.004)
- [evidence_pulse_fix_20261102.zip](evidence_pulse_fix_20261102.zip)
- [evidence_rx1_generator_nominal_20261030.zip](evidence_rx1_generator_nominal_20261030.zip)
- [evidence_rx2_ac_generator_20261031.zip](evidence_rx2_ac_generator_20261031.zip)
- [evidence_rx2_generator_nominal_20261031.zip](evidence_rx2_generator_nominal_20261031.zip)
- [evidence_tx23_calibration_20261030.zip](evidence_tx23_calibration_20261030.zip)
- [evidence_tx23_recalibration_20261103.zip.001](evidence_tx23_recalibration_20261103.zip.001)
- [evidence_tx23_recalibration_20261103.zip.002](evidence_tx23_recalibration_20261103.zip.002)
- [evidence_tx3_lcd_compat_20261103.zip](evidence_tx3_lcd_compat_20261103.zip)
- [evidence_tx3_multi_final_20261101.zip](evidence_tx3_multi_final_20261101.zip)
- [evidence_tx3_multi_localzero_20261101.zip](evidence_tx3_multi_localzero_20261101.zip)
- [evidence_tx3_multi_refined_20261101.zip](evidence_tx3_multi_refined_20261101.zip)
- [evidence_tx3_multi_release_20261102.zip](evidence_tx3_multi_release_20261102.zip)
- [evidence_tx3_multi_resume_20261101.zip](evidence_tx3_multi_resume_20261101.zip)
- [evidence_tx3_sine5m_20261102.zip](evidence_tx3_sine5m_20261102.zip)
- [evidence_tx3_warm125_20261101.zip](evidence_tx3_warm125_20261101.zip)
- [evidence_tx3_warm125_trim_20261101.zip](evidence_tx3_warm125_trim_20261101.zip)
- [evidence_tx3_warm_label_20261101.zip](evidence_tx3_warm_label_20261101.zip)
- [evidence_tx_wave_calibration_20261103.zip](evidence_tx_wave_calibration_20261103.zip)
- [evidence_ui_layout_20261101.zip](evidence_ui_layout_20261101.zip)
- [evidence_ve_scope_meter_20261101.zip](evidence_ve_scope_meter_20261101.zip)
- [evidence_workbench_20261101.zip](evidence_workbench_20261101.zip)
- [source_records.zip](source_records.zip)
