hscsja03-afk/-BJT-/data/datasheets/readme.md

# 器件手册与参数资料

器件手册与参数资料。

| 目录 | 内容 |
| --- | --- |
| [parameter_reviews/](parameter_reviews/) | 器件参数与测量条件 |

## 文件

- [datasheets.zip](datasheets.zip)
- [sources.json](sources.json)
