hscsja03-afk/-BJT-/board/tx1_isolation/readme.md

# TX1 总线隔离实验文件

TX1 总线隔离实验文件。

## 文件

- [build.ps1](build.ps1)
- [load.tcl](load.tcl)
- [main.c](main.c)
- [measure.py](measure.py)
- [swap_pl.tcl](swap_pl.tcl)
- [xtime_l.h](xtime_l.h)
