hscsja03-afk/-BJT-/board/startup/readme.md

# 板端代理与开机启动

板端代理与开机启动。

## 文件

- [audit_desktop_startup.py](audit_desktop_startup.py)
- [install_persistent_startup.py](install_persistent_startup.py)
- [persistence_probe.py](persistence_probe.py)
- [update_persistent_agent.py](update_persistent_agent.py)
- [verify_persistent_startup.py](verify_persistent_startup.py)
