hscsja03-afk/-BJT-/board/software/readme.md

# 板端 Python 安装包

板端 Python 安装包。

## 文件

- [zynq_bjt-0.2.0-py3-none-any.whl](zynq_bjt-0.2.0-py3-none-any.whl)
