hscsja03-afk/-BJT-/board/overlay/readme.md

# FPGA 位流、硬件描述与地址配置

每套 bit/HWH 使用同目录的 manifest.json 记录哈希和 AXI 地址。测量记录保存采集时的位流身份。

| 目录 | 内容 |
| --- | --- |
| [build_20261104/](build_20261104/) | LCD DDR 位流与硬件描述 |

## 文件

- [bjt.bit](bjt.bit)
- [bjt.hwh](bjt.hwh)
- [manifest.json](manifest.json)
