hscsja03-afk/-BJT-/board/notebooks/readme.md

# PYNQ 交互测量示例

PYNQ 交互测量示例。

## 文件

- [npn_input.ipynb](npn_input.ipynb)
