hscsja03-afk/-BJT-/board/instruments/readme.md

# 示波器通信与波形测量

示波器通信与波形测量。

## 文件

- [read_scope.py](read_scope.py)
- [tx2_scope_zero.py](tx2_scope_zero.py)
- [waveform_metrics.py](waveform_metrics.py)
