hscsja03-afk/-BJT-/board/desktop/readme.md

# 上位机运行库与操作说明

上位机运行库与操作说明。

## 文件

- [desktop_workbench.md](desktop_workbench.md)
- [early_rin_datasheet.md](early_rin_datasheet.md)
- [windows_runtime.zip.001](windows_runtime.zip.001)
- [windows_runtime.zip.002](windows_runtime.zip.002)
- [windows_runtime.zip.003](windows_runtime.zip.003)
- [windows_runtime.zip.004](windows_runtime.zip.004)
- [windows_runtime.zip.005](windows_runtime.zip.005)
- [windows_runtime.zip.006](windows_runtime.zip.006)
- [windows_runtime.zip.007](windows_runtime.zip.007)
- [windows_runtime.zip.008](windows_runtime.zip.008)
- [windows_runtime.zip.009](windows_runtime.zip.009)
