hscsja03-afk/-BJT-/board/config/readme.md

# PS 配置与 OCM 链接脚本

PS 配置与 OCM 链接脚本。

## 文件

- [ocm.ld](ocm.ld)
- [ps_core_2v5.tcl](ps_core_2v5.tcl)
- [ps_ddr_nanya533.tcl](ps_ddr_nanya533.tcl)
- [ps_pynq_custom.tcl](ps_pynq_custom.tcl)
