hscsja03-afk/-BJT-/board/boot/readme.md

# Zynq 启动、JTAG 与系统检查

启动探针、FSBL 与 Linux 平台、JTAG 加载和启动状态检查。

## 文件

- [boot_probe.c](boot_probe.c)
- [build_boot_probe.ps1](build_boot_probe.ps1)
- [capture_coldboot_uart.py](capture_coldboot_uart.py)
- [collect_boot_evidence.py](collect_boot_evidence.py)
- [create_boot_platform.py](create_boot_platform.py)
- [create_boot_platform_2020.tcl](create_boot_platform_2020.tcl)
- [create_linux_platform.tcl](create_linux_platform.tcl)
- [create_linux_platform_2020.tcl](create_linux_platform_2020.tcl)
- [extract_zynq_uboot.py](extract_zynq_uboot.py)
- [inspect_factory_boot.tcl](inspect_factory_boot.tcl)
- [inspect_jtag.tcl](inspect_jtag.tcl)
- [inspect_ps.tcl](inspect_ps.tcl)
- [locate_factory_boot_stop.tcl](locate_factory_boot_stop.tcl)
- [run_boot_probe.ps1](run_boot_probe.ps1)
- [run_boot_probe.tcl](run_boot_probe.tcl)
- [run_pynq_linux.ps1](run_pynq_linux.ps1)
- [run_pynq_uboot_jtag.tcl](run_pynq_uboot_jtag.tcl)
- [test_jtag_data_load.tcl](test_jtag_data_load.tcl)
- [verify_mio_linux.py](verify_mio_linux.py)
- [verify_pynq_custom50.ps1](verify_pynq_custom50.ps1)
- [verify_pynq_custom50.tcl](verify_pynq_custom50.tcl)
- [verify_pynq_linux.py](verify_pynq_linux.py)
