hscsja03-afk/-BJT-/board/baremetal/readme.md

# 裸机程序与启动映像

裸机程序与启动映像。

## 文件

- [audit.py](audit.py)
- [build.ps1](build.ps1)
- [create_platform.py](create_platform.py)
- [discover_instrument.py](discover_instrument.py)
- [export_platform.tcl](export_platform.tcl)
- [inspect_clocks.tcl](inspect_clocks.tcl)
- [read_generator_lan.py](read_generator_lan.py)
- [run.ps1](run.ps1)
- [run.tcl](run.tcl)
- [validate_hardware.py](validate_hardware.py)
- [verify_run.py](verify_run.py)
- [verify_uart.py](verify_uart.py)
