hscsja03-afk/-BJT-/board/analysis/readme.md

# 测量记录分析与图表导出

测量记录分析与图表导出。

## 文件

- [backfill_curve_images.py](backfill_curve_images.py)
- [backfill_derived_analysis.py](backfill_derived_analysis.py)
- [check_fft_recorded.py](check_fft_recorded.py)
- [migrate_desktop_data.py](migrate_desktop_data.py)
- [organize_saved_results.py](organize_saved_results.py)
- [preview_fft_persistence.py](preview_fft_persistence.py)
- [preview_parameter_grid.py](preview_parameter_grid.py)
- [render_analysis_preview.py](render_analysis_preview.py)
- [review_2n5401_parameters.py](review_2n5401_parameters.py)
