hscsja03-afk/-BJT-/build/reports/lcd_ddr_20261104/readme.md

# LCD DDR 2026-11-04 构建与实现报告

器件 xc7z020clg400-2，Vivado 2026.1；ADC 62.5 MHz、DAC 125 MHz。build_identity.json 中的 source_revision 指向本次构建输入的 Git 版本。

## 文件

- [build_identity.json](build_identity.json)
- [bus_skew.rpt](bus_skew.rpt)
- [cdc.rpt](cdc.rpt)
- [drc.rpt](drc.rpt)
- [io.rpt](io.rpt)
- [ps_config.txt](ps_config.txt)
- [synthesis_utilization.rpt](synthesis_utilization.rpt)
- [timing.xdc](timing.xdc)
- [timing_summary.rpt](timing_summary.rpt)
- [utilization.rpt](utilization.rpt)
