hscsja03-afk/-BJT-/src/python/zynq_bjt/readme.md

# 设备驱动、测量分析与图形界面

设备驱动、测量分析与图形界面。

## 文件

- [__init__.py](__init__.py)
- [ac.py](ac.py)
- [ai_client.py](ai_client.py)
- [analysis.py](analysis.py)
- [baremetal.py](baremetal.py)
- [characteristics.py](characteristics.py)
- [converters.py](converters.py)
- [curve_export.py](curve_export.py)
- [datasheet_extract.py](datasheet_extract.py)
- [datasheet_grid.py](datasheet_grid.py)
- [datasheets.py](datasheets.py)
- [demo.py](demo.py)
- [desktop.py](desktop.py)
- [desktop_agent.py](desktop_agent.py)
- [desktop_lcd.py](desktop_lcd.py)
- [desktop_output.py](desktop_output.py)
- [desktop_results.py](desktop_results.py)
- [desktop_session.py](desktop_session.py)
- [desktop_storage.py](desktop_storage.py)
- [desktop_transport.py](desktop_transport.py)
- [desktop_verify.py](desktop_verify.py)
- [frontend.py](frontend.py)
- [lcd.py](lcd.py)
- [lcd_framebuffer.py](lcd_framebuffer.py)
- [lcd_records.py](lcd_records.py)
- [lcd_stream.py](lcd_stream.py)
- [measurement_views.py](measurement_views.py)
- [meter.py](meter.py)
- [meter_view.py](meter_view.py)
- [metric_strip.py](metric_strip.py)
- [mio.py](mio.py)
- [mmio.py](mmio.py)
- [notebook.py](notebook.py)
- [page_defaults.py](page_defaults.py)
- [parameter_view.py](parameter_view.py)
- [pdf_view.py](pdf_view.py)
- [polarity.py](polarity.py)
- [profiles.py](profiles.py)
- [pulse.py](pulse.py)
- [result_paths.py](result_paths.py)
- [runtime.py](runtime.py)
- [scan.py](scan.py)
- [scope_display.py](scope_display.py)
- [scope_view.py](scope_view.py)
- [sidebar_art.py](sidebar_art.py)
- [simulation.py](simulation.py)
- [sweep.py](sweep.py)
- [tx1.py](tx1.py)
- [waveform_reference.py](waveform_reference.py)
- [workbench_tools.py](workbench_tools.py)
