hscsja03-afk/-BJT-/skill/pynq-overlay-audit/scripts/readme.md

# PYNQ 位流与地址校验脚本

PYNQ 位流与地址校验脚本。

## 文件

- [check_bundle.py](check_bundle.py)
- [test_check_bundle.py](test_check_bundle.py)
