hscsja03-afk/-BJT-/data/datasheets/parameter_reviews/readme.md

# 器件参数与测量条件

器件参数与测量条件。

## 文件

- [39ea698c1449d4c9fcf719a0b7aec4d733e4973f81f900fea50f04c47de60b60.json](39ea698c1449d4c9fcf719a0b7aec4d733e4973f81f900fea50f04c47de60b60.json)
