hscsja03-afk/-BJT-/board/diagnostics/tx23/readme.md

# TX2/TX3 波形、零点与稳定性检查

TX2/TX3 波形、零点与稳定性检查。

## 文件

- [audit_tx3_sine_noise.py](audit_tx3_sine_noise.py)
- [check_tx23_dc_crosstalk.py](check_tx23_dc_crosstalk.py)
- [check_tx23_lan_wiring.py](check_tx23_lan_wiring.py)
- [check_tx23_paired_dc.py](check_tx23_paired_dc.py)
- [check_tx3_scope_consistency.py](check_tx3_scope_consistency.py)
- [diagnose_tx3_multi.py](diagnose_tx3_multi.py)
- [diagnose_tx3_sine5m.py](diagnose_tx3_sine5m.py)
- [prepare_tx3_release_startup.py](prepare_tx3_release_startup.py)
- [probe_tx3_transfer.py](probe_tx3_transfer.py)
- [recheck_tx_wave_stability.py](recheck_tx_wave_stability.py)
- [tx3_warm_stability.py](tx3_warm_stability.py)
- [verify_tx23_packaged.py](verify_tx23_packaged.py)
- [verify_tx2_zero_fine.py](verify_tx2_zero_fine.py)
- [verify_tx3_multi_release.py](verify_tx3_multi_release.py)
- [verify_tx3_sine5m_release.py](verify_tx3_sine5m_release.py)
- [verify_tx_waves_lan.py](verify_tx_waves_lan.py)
