hscsja03-afk/-BJT-/board/diagnostics/tx1/readme.md

# TX1 总线、寄存器与输出检查

检查 TX1 寄存器、外部总线写入和实际模拟输出。

## 文件

- [capture_tx1_bus.py](capture_tx1_bus.py)
- [hold_tx1_reference.py](hold_tx1_reference.py)
- [recover_tx1_before_acceptance.py](recover_tx1_before_acceptance.py)
- [run_tx1_reference.tcl](run_tx1_reference.tcl)
- [tx1_diagnostic_agent_main.py](tx1_diagnostic_agent_main.py)
- [tx1_register_probe.py](tx1_register_probe.py)
- [tx1_soft_reset_probe.py](tx1_soft_reset_probe.py)
- [tx1_write_probe.py](tx1_write_probe.py)
- [verify_tx1_pynq_scope.py](verify_tx1_pynq_scope.py)
- [verify_tx1_reference.py](verify_tx1_reference.py)
- [verify_tx1_scope.py](verify_tx1_scope.py)
- [verify_tx1_trigger_scope.py](verify_tx1_trigger_scope.py)
