hscsja03-afk/-BJT-/board/diagnostics/ddr/readme.md

# DDR 初始化、训练与字节通道诊断

检查 DDR 初始化、训练参数、字节通道和固定区域读写。

## 文件

- [audit_nanya_profile.py](audit_nanya_profile.py)
- [build_ddr_lane_probe.ps1](build_ddr_lane_probe.ps1)
- [build_ddr_lane_probe_2020.ps1](build_ddr_lane_probe_2020.ps1)
- [check_ddr_scratch.tcl](check_ddr_scratch.tcl)
- [ddr_lane_probe.c](ddr_lane_probe.c)
- [inspect_ddr.tcl](inspect_ddr.tcl)
- [run_ddr_debug_port_probe.tcl](run_ddr_debug_port_probe.tcl)
- [run_ddr_lane_probe.ps1](run_ddr_lane_probe.ps1)
- [run_ddr_lane_probe.tcl](run_ddr_lane_probe.tcl)
- [run_ddr_training_probe.ps1](run_ddr_training_probe.ps1)
- [run_ddr_training_probe.tcl](run_ddr_training_probe.tcl)
