hscsja03-afk/-BJT-/board/diagnostics/bjt/readme.md

# 三极管接线、反馈与扫描检查

三极管接线、反馈与扫描检查。

## 文件

- [check_pynq27_hwh.py](check_pynq27_hwh.py)
- [diagnose_npn_input_bias.py](diagnose_npn_input_bias.py)
- [verify_all_bjt_profiles.py](verify_all_bjt_profiles.py)
- [verify_fast_input_view.py](verify_fast_input_view.py)
- [verify_input_pacing.py](verify_input_pacing.py)
- [verify_npn_feedback_mapping.py](verify_npn_feedback_mapping.py)
