hscsja03-afk/-BJT-/report/ai_collaboration.md

# 大模型协作记录

本记录选取四项影响实现方案和验证结论的协作过程，按交互要点、方案取舍、纠错结果和工程心得整理。交互内容采用开发记录中的要点摘录，数值对应各案例注明的实验条件。

| 案例 | 讨论的关键问题 | 最终采用的处理 |
| --- | --- | --- |
| DDR 启动定位 | 工具版本、初始化参数和物理链路，哪个因素能解释错误？ | 固定测试程序，比较版本与参数，按字节统计错误 |
| TX1 输出异常 | 寄存器回读正确，为何输出仍接近零？ | 改变停用期间的写入顺序，启用前单次提交 DATA |
| 采样时钟调整 | 更高的标称频率是否值得采用？ | 依据建立、保持裕量及双通道实测选择工作档位 |
| TX2/TX3 校准 | 单路校准结果如何用于双路同时工作？ | 区分通道、频率和负载条件，增加固定条件的开关对照 |

## 1. DDR：用对照实验收敛故障范围

**交互要点。** 开发初期，JTAG 能访问处理器，DDR 读写却出现错误。提出的问题是：“还有会不会是因为软件版本的问题呢，我电脑上还有2020的版本”。模型协助比对两版工具生成的 PS 初始化函数、整理器件时序参数，并将测试拆成版本对照、参数修正和字节通道统计。

**分析与纠错。** 比较发现，2020.2 与 2026.1 生成的 DDR、PLL、时钟和 MIO 初始化函数主体一致。随后使用同一读写探针进行板上对照，避免把测试程序变化混入版本比较。核对 NT5CC256M16ER-EK 参数时，又发现原配置的 tFAW 为 40 ns，修正为 50 ns 后单独复测。

| 对照条件 | 读比较次数 | 错误次数 | 错误分布 |
| --- | ---: | ---: | --- |
| 2020.2 初始化、原厂底板 | 65,536 | 1,186 | 全部位于最低字节 |
| 2026.1、修正后的 Nanya 533 MHz 参数 | 65,536 | 1,536 | 全部位于最低字节 |
| 调整最低字节训练起点，9 组实验 | 每组 65,536 | 每组 1,280～1,654 | 错误掩码均为 `0x000000FF` |

**采纳与舍弃。** 采纳“保持程序和接线一致，每次只改变一个因素”的办法；修正器件时序参数后继续用读写结果判断效果。放弃把回退工具版本当作修复方案，也放弃只凭训练完成标志判断 DDR 正常。训练起点改变了错误数量，却没有改变错误字节分布，因此继续随机调参的收益很低，排查重点转向最低字节对应的板级链路。

**心得。** 模型给出的可能原因，需要转成能区分原因的实验。这个案例中，稳定的错误位置比错误总数更有定位价值；每轮比较保留相同探针和错误掩码，后续判断才有连续的依据。

依据：[DDR 对照记录](hardware/hardware_evidence.json)。提炼方法：[Zynq 启动与 DDR 分层定位](../skill/zynq-boot-ddr-diagnosis/skill.md)。

## 2. TX1：把寄存器状态和模拟输出分开验证

**交互要点。** TX1 的 DATA 和使能寄存器能够正确回读，示波器上却出现接近零的输出。协作重点从检查写入值，转向梳理“初始化、停用、写 DATA、启用”的实际执行顺序。模型协助整理驱动调用路径和对照序列，再由示波器结果筛选修改方案。

**分析与纠错。** 对照中固定 TX1 到示波器 CH3 的连接。DATA 同样回读为 26208 时，不同操作顺序分别得到约 1.007 V 和约 2 mV 的输出。继续拆分序列后，问题收敛到同一次停用期间的重复 DATA 写入：初始化先写零，启用前又写目标值，回读虽然更新，输出行为却没有按预期改变。

**采纳与舍弃。** 驱动将停用期间的目标码暂存在 `pending_code`，在启用前提交一次 DATA；输出启用后再按正常路径更新电压。原先“初始化立即写零，再写目标值”的顺序被替换。也舍弃了仅凭寄存器回读成功结束验收的做法，将寄存器状态、示波器电压和重新上电后的行为共同作为检查项。这一处理依据本板的对照现象确定。

**验证与心得。** 修正后完成 14 项示波器检查，独立冷启动后再完成 14 项检查，两组均通过。这个问题说明，驱动既要描述寄存器的目标值，也要描述设备到达目标值的过程。把调用顺序写成可重复的状态转换，比在上层增加重复写入或等待更容易定位问题。

依据：[问题定位](hardware/tx1_root_cause_20261030.json)、[示波器检查](hardware/tx1_pynq_scope_acceptance_20261030.json)、[冷启动复验](hardware/tx1_pynq_scope_coldboot_20261030.json)、[驱动实现](../src/python/zynq_bjt/tx1.py)。提炼方法：[寄存器到模拟输出定位](../skill/register-to-analog-debug/skill.md)。

## 3. 采样时钟：按时序和测量用途选择工作档位

**交互要点。** 提高采样率时，讨论的核心是哪些限制来自采样时钟，哪些来自数据捕获和板级接口。模型协助整理不同构建的约束、最差路径和资源报告，并将外部 ADC 数据捕获与主机显示、传输过程分开检查。

**分析与修正。** ADC 输入增加 IOB 寄存器，外部 DCO 经 MMCM 与 BUFG 反馈补偿后用于采样。比较构建结果时，同时检查建立裕量 WNS 和保持裕量 WHS，避免只关注最高频率或单项报告。

| 构建配置（ADC / DAC） | WNS | WHS | 方案判断 |
| --- | ---: | ---: | --- |
| 125 / 250 MHz | −8.235 ns | −2.072 ns | 该次实现存在负裕量，退出发布选择 |
| 62.5 / 125 MHz | 0.394 ns | 0.041 ns | 采用，并继续进行板上数字与信号检查 |

**采纳与舍弃。** 采用具有正建立、保持裕量的实现，并保留 ADC 50 MHz 与 62.5 MHz 两个工作档。BJT 和电压换算使用 50 MHz；原始采样与频谱可以选择 62.5 MHz。舍弃将更高标称频率直接写成性能成果的做法，也没有把 50 MHz 下的电压校准条件直接扩展到新采样档位。

**验证与心得。** 双通道信号检查记录的最大 FFT 频率误差约为 0.01646%；发布程序读出的高采样档分别为 62.5056 MHz、62.5057 MHz。采样率从 50 MHz 提高到 62.5 MHz，增幅为 25%。整次扫描还包含偏置稳定、传输和计算时间，应另用同点数、同条件的扫描耗时评价。时序报告解决“能否可靠采样”，实验条件决定“采样结果如何用于测量”，两部分都需要随版本保存。

依据：[125/250 MHz 时序](../build/reports/target125_250/timing_summary.rpt)、[62.5/125 MHz 时序](../build/reports/adc625_mmcm_20261102/timing_summary.rpt)、[时钟实现](../src/rtl/adc_clocking.v)、[升频实验归档](../data/evidence/evidence_adc_rate_raise_20261102.zip)中的 `release_summary.json` 与 `hardware_dual/result.json`。提炼方法：[FPGA 源码重建与时序核对](../skill/fpga-source-timing-closure/skill.md)。

## 4. TX2/TX3：从单路标定走到同时工作验证

**交互要点。** 提出的任务是：“你顺便检查TX3，专门正弦波的。然后TX3，TX2两个一起校准，有TX3接四通道。”模型协助整理扫点、正弦拟合和误差统计流程，并检查修改频率后补偿表是否真正写入设备。

**分析与修正。** 2026-10-30 的实验采用 custom50 配置、50 MSPS DAC，TX2 接示波器 CH3、TX3 接 CH4，使用高阻同轴连接。TX2 在 0～1.8 V 建立直流校准点并做独立检查；TX3 在 10 kHz～6 MHz、目标 50 mVpp 下按频率建立补偿。软件同时修正了“仅修改正弦频率时没有重新提交对应补偿表”的路径。

| 检查项目 | 实验设置 | 结果 |
| --- | --- | --- |
| TX2 直流校准 | 37 个校准点、73 个独立检查点 | 最大电压偏差约 0.580 mV |
| TX3 正弦幅度 | 78 个频率点、12 个中间点，50 mVpp | 最大基波 Vpp 偏差约 0.504 mV |
| 两路同时工作 | TX2 固定 0.5 V，配对切换 TX3 开关 | TX2 电压变化约 +0.902～+0.961 mV |

**采纳与舍弃。** 采纳分通道建表、用中间点检查插值、固定示波器设置后做开关对照的办法。双通道显示时，自动直流读数与波形均值曾出现数毫伏差异，因此放弃直接拼接不同仪器设置下的读数判断串扰。也舍弃把单路误差直接作为双路同时工作误差的推断：配对实验单独记录 TX3 开关带来的变化，校准表保存采样时钟和测量条件。

**心得。** 校准算法可以由模型辅助编写，但校准结论要由控制变量和独立检查点支撑。把标定点、插值检查点和同时工作测试分开，既能看到拟合效果，也能看出系统状态改变后新增的误差。上述数值对应这次 50 MSPS 实验，用于说明方案取舍；各运行版本的换算参数由配套校准表确定。

依据：[TX2/TX3 校准归档](../data/evidence/evidence_tx23_calibration_20261030.zip)中的 `summary.json`、`tx2/result.json` 和 `tx3_final/result.json`。提炼方法：[混合信号校准与单位管理](../skill/mixed-signal-calibration/skill.md)。

## 协作方法的总结

最有用的交互发生在实验结果与预期不一致的时候：给出固定条件、异常数据和现有代码，让模型帮助缩小候选原因，再通过一次只改变一个因素的实验作出选择。DDR 的错误字节分布、TX1 的操作顺序、ADC 的建立与保持裕量、双路输出的开关差值，分别提供了可以复查的判断依据。

对模型建议的取舍落实为三件事：把解释写成可检验的假设；用原始记录决定是否采纳；把有效步骤整理进技能包。最终保留下来的是能够帮助下一次定位问题的方法，以及说明这些方法为何成立的实验结果。
