hscsja03-afk/-BJT-/skill/technical-poster-evidence/skill.md

---
name: technical-poster-evidence
description: 组织系统架构、硬件照片、软件界面和实测图表，建立素材、数值与原始数据之间的对应关系。
---

# 技术海报与证据图组织

形式：提示词工作流、案例模板

## 适用场景

将硬件、PYNQ架构、上位机和实测结果组织为单页技术海报。

## 本队题目之外的应用场景

可用于其他嵌入式作品的科研展示、竞赛展板和项目汇报图。

迁移方法：替换项目架构、实物照片、界面和实验结果；沿用素材清单、图表原始点关联及可编辑对象组织方法，按目标尺寸和展示要求调整布局。

可复用的输出：架构、实物和实验结果相互对应的技术展示材料。

## 使用方法

先建立素材表，区分原照片、界面截图、实测曲线和效果图。以标题和设备为主视觉，展示实际软件栈与 PS–PL 接口，再加入软件截图和核心结果。保留图表原始点，核对轴范围。将文字、图表和架构保留为可编辑对象，逐页检查 PowerPoint 与打印 PDF。

输出按[实验记录模板](../templates/experiment_record.md)填写输入、步骤、结果与复用条件。

## 协作提示词

> 请依据[提交要求、硬件原图、架构、界面截图、原始测量数据]制作单页海报。突出设备与核心指标，保留真实的PYNQ接口、可编辑曲线和来源注释，检查打印字号与数据范围。

方括号由使用者替换为目标项目资料。

## 已验证效果

项目完成单页英文 A4 海报、可编辑架构和原始数据图表；经过 PowerPoint 打开及 PDF 渲染检查，并加入用户提供的上位机界面。

## 经验来源

首版信息密度接近报告；改成视觉版后遗漏 PYNQ 架构；芯片指引线曾落在接口。这些反馈形成内容清单和源文件定位步骤。

## 失效条件与处理

模板、语言、匿名和打印要求以具体任务为准。效果图用于表达，器件定位采用原图与PCB；界面中的模拟标识和空曲线保持原状。
