hscsja03-afk/-BJT-/skill/fpga-source-timing-closure/skill.md

---
name: fpga-source-timing-closure
description: 从 RTL、约束和 PS 配置重建 FPGA 工程，定位建立时间、保持时间及 IO 时序问题。
---

# FPGA 源码重建与时序核对

形式：工程工作流

## 适用场景

迁移旧工程、变更采样时钟、检查外部 IO 时序。

## 本队题目之外的应用场景

可用于摄像头接口、数字滤波器、高速传感器采集和 FPGA 工程版本迁移。

迁移方法：替换器件型号、时钟、IO 电压、板级延时及接口约束；按目标设计重新执行复位、握手、跨时钟域和建立/保持时间检查。

可复用的输出：可复现构建脚本及同条件下的资源、时序对照。

## 使用方法

收集 RTL/IP、约束和 PS 预设，以脚本重建工程。先验证复位和握手，再执行综合、实现与时序检查；同时记录内部路径、输入输出约束、跨时钟域及资源占用。优化前后使用相同负载和统计方法。

输出按[实验记录模板](../templates/experiment_record.md)填写输入、步骤、结果与复用条件。

## 协作提示词

> 请根据[源码、约束、综合和实现报告]定位限制频率的路径，保留失败约束，比较优化前后时序、资源与相同任务的耗时。

方括号由使用者替换为目标项目资料。

## 已验证效果

ADC62.5/DAC125 构建记录的建立/保持裕量为 0.394/0.041 ns；两档数字验证分别记录。

## 经验来源

旧工程缓存和时钟变更容易造成“构建成功”与实际约束不一致；采样率提高也改变模拟校准条件。

## 失效条件与处理

目标器件、IO 电压、板级延时和 IP 版本改变时重新建立约束。时序裕量对应指定构建，电压精度使用独立校准结果。
