hscsja03-afk/-BJT-/skill/datasheet-parameters/skill.md

---
name: datasheet-parameters
description: 从电子器件手册提取带页码、单位和测试条件的参数表，输出 JSON 与 CSV。
---

# 数据手册参数与页码追溯

形式：审阅工作流、案例模板

## 适用场景

晶体管或其他电子器件 PDF 参数表整理。

## 本队题目之外的应用场景

可用于MOSFET、运算放大器、ADC/DAC、电源芯片的选型与参数整理。

迁移方法：替换厂家、器件型号、参数符号和测试条件；保留页码、原表单元格、min/typ/max、单位和脚注的关联，按器件类型区分额定值与工作条件。

可复用的输出：可回到原始页面核查的参数 JSON/CSV。

## 使用方法

建立参数记录：来源哈希、页码、型号列、符号、数值、min/typ/max角色、单位、温度和测试条件。先保留原始符号和单位，再核对合并表头、脚注与跨页表；CSV用于查看，JSON保留来源关系。

输出按[实验记录模板](../templates/experiment_record.md)填写输入、步骤、结果与复用条件。

## 协作提示词

> 请从[PDF指定页]提取[型号与参数]，保留正负号、角色、条件和页码。逐行说明来源单元格，跨页或合并单元格先对照原页面。

方括号由使用者替换为目标项目资料。

## 已验证效果

项目参数流程采用页码、原表单元格和条件关联，参数行可回到来源页面；本包提供可直接套用的参数记录模板。

## 经验来源

合并表头、不同型号列、PNP负号及最大额定值与推荐工作条件容易混淆。

## 失效条件与处理

扫描PDF需OCR和页面比对；缺少型号或条件的行保持原文记录，取得来源后再换算。手册额定值与实际扫描范围分别管理。
