hscsja03-afk/-BJT-/board/hardware/adda/ad9516_config_01.png

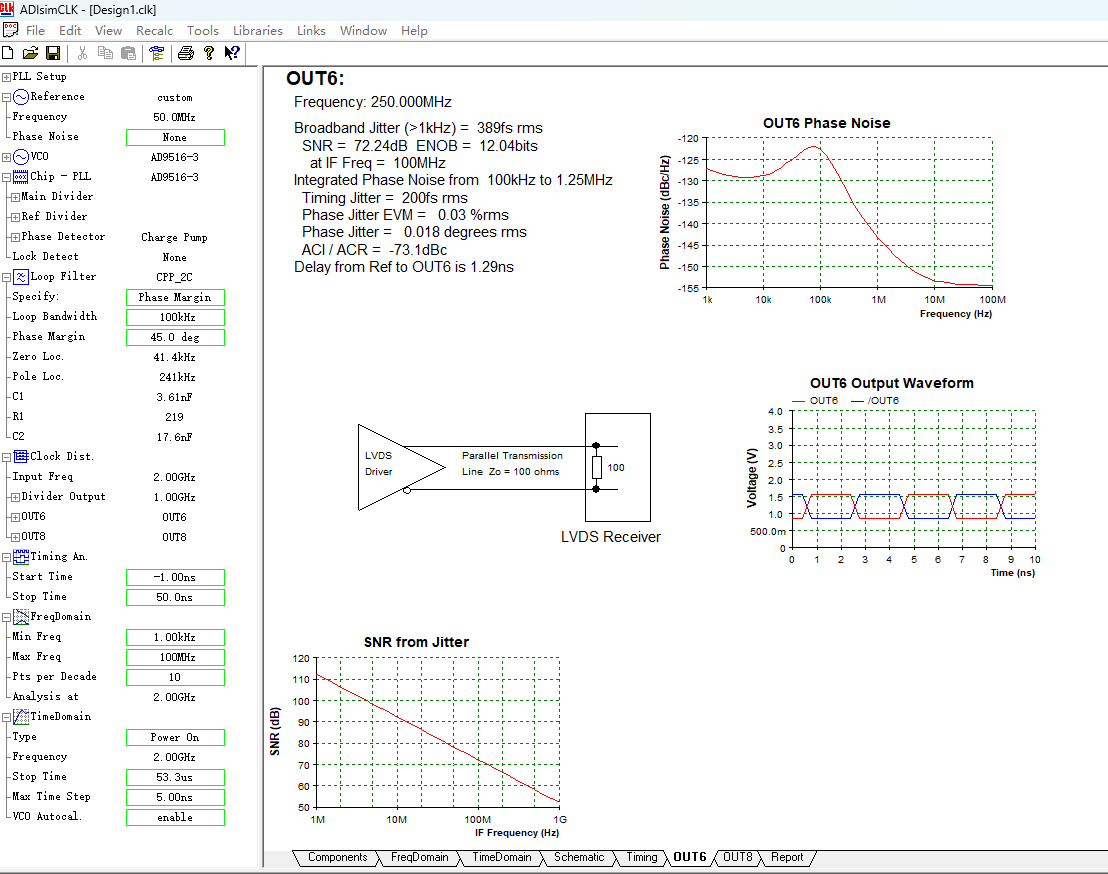
board/hardware/adda/ad9516_config_01.png
