hscsja03-afk/-BJT-/board/hardware/adda/pcb_3d.png

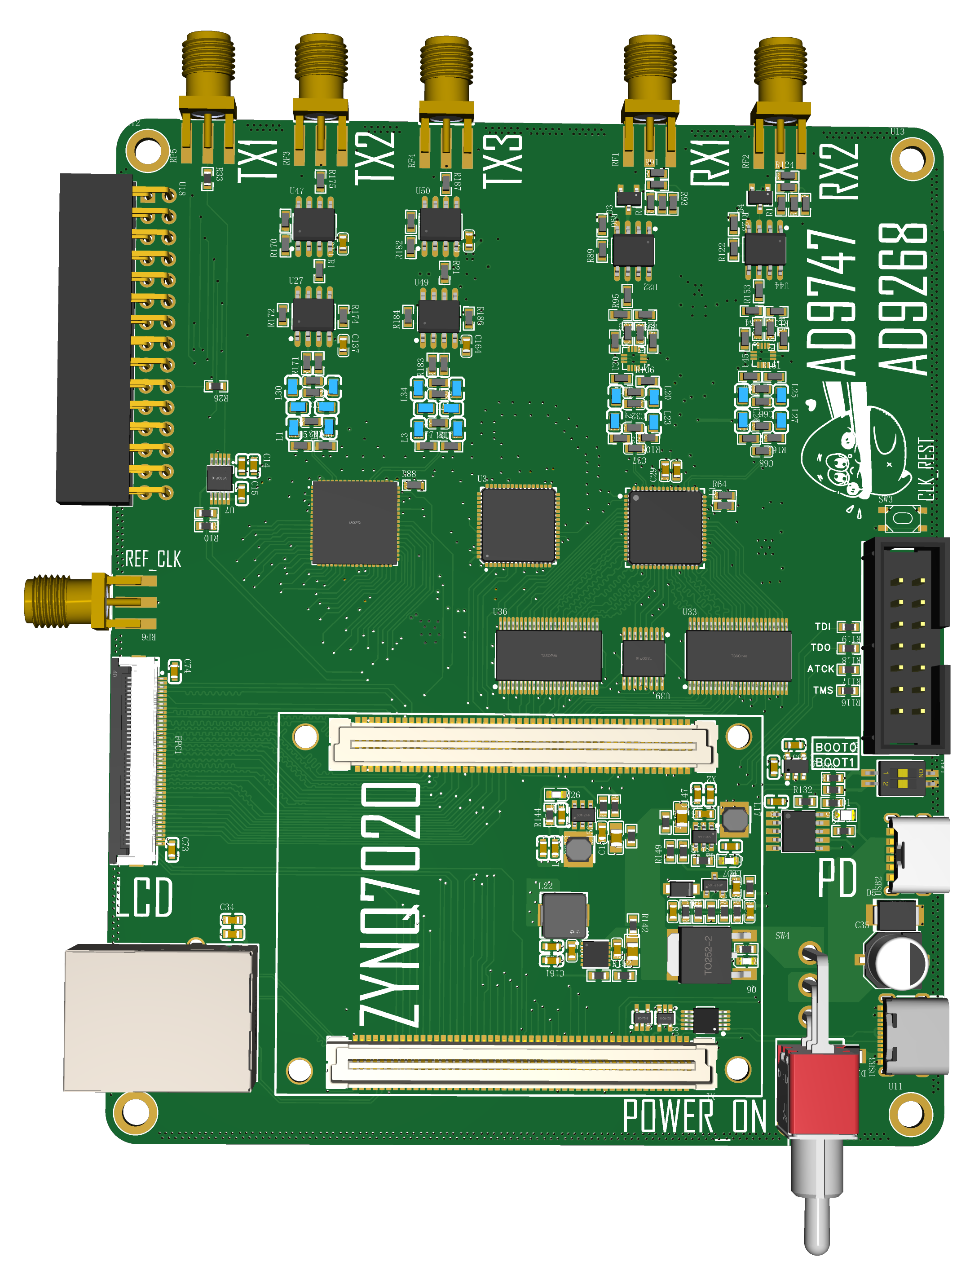
board/hardware/adda/pcb_3d.png
