hscsja03-afk/-BJT-/board/hardware/bjt/schematic_ac.png

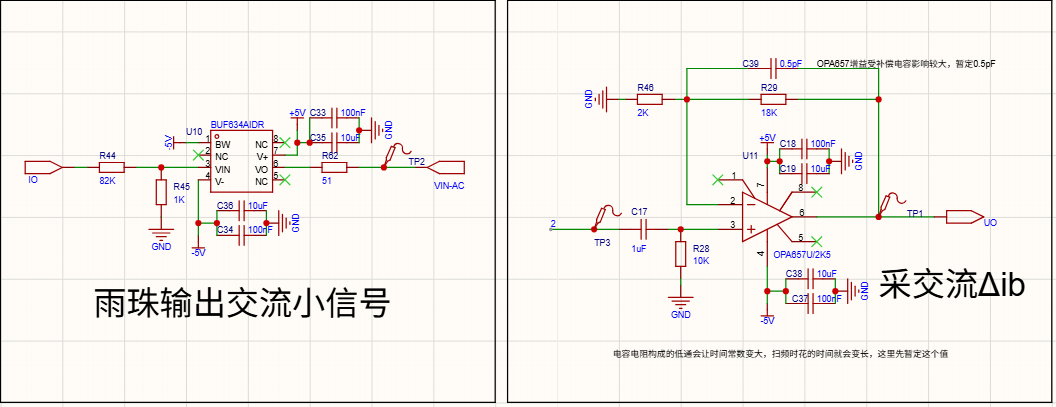
board/hardware/bjt/schematic_ac.png
