hscsja03-afk/-BJT-/board/hardware/bjt/schematic_base_current_source.png

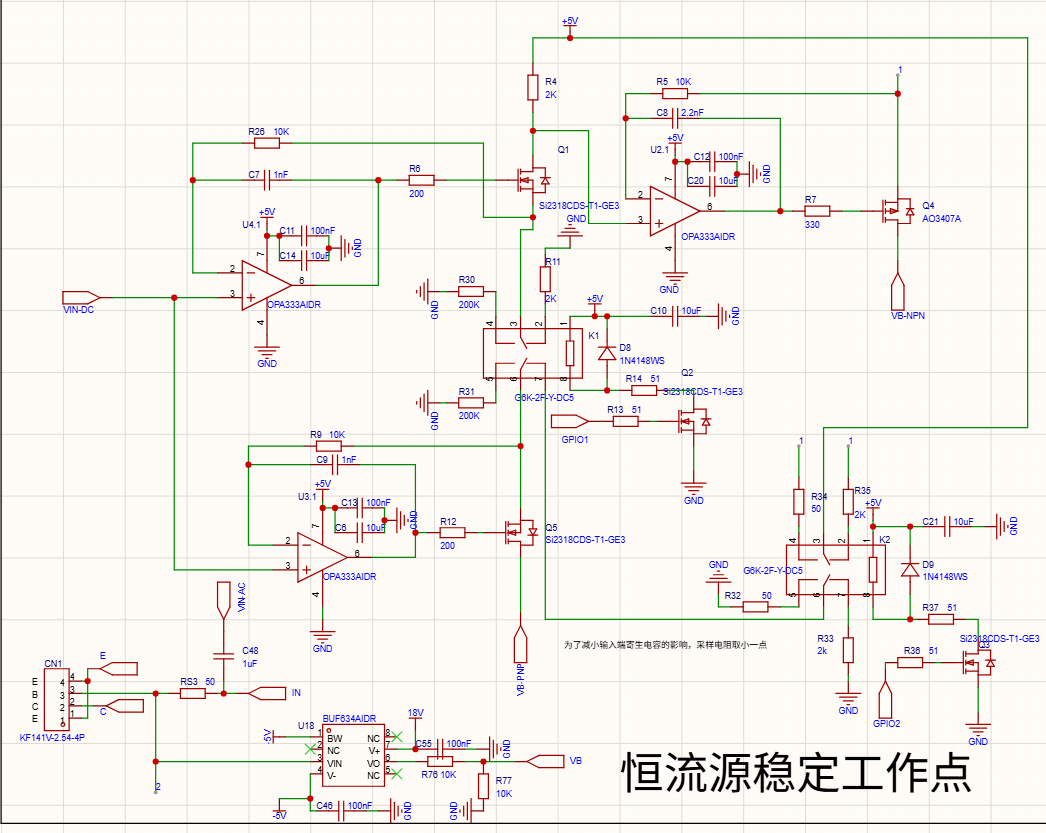
board/hardware/bjt/schematic_base_current_source.png
