hscsja03-afk/-BJT-/board/hardware/bjt/schematic_dual_supply.png

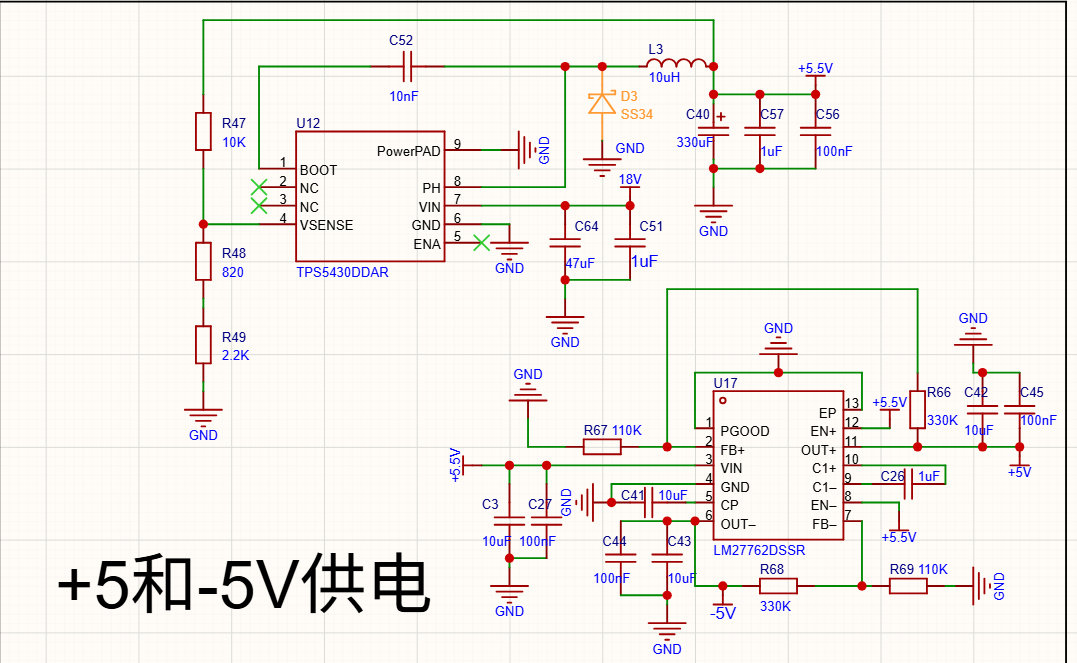
board/hardware/bjt/schematic_dual_supply.png
