hscsja03-afk/-BJT-/board/hardware/bjt/schematic_interface.png

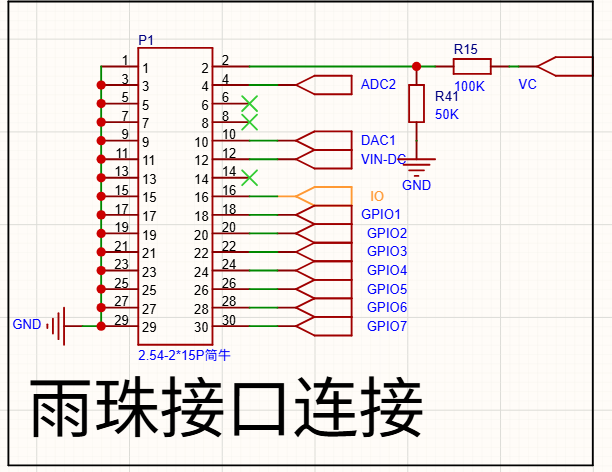
board/hardware/bjt/schematic_interface.png
