hscsja03-afk/-BJT-/board/hardware/bjt/schematic_polarity_switch.png

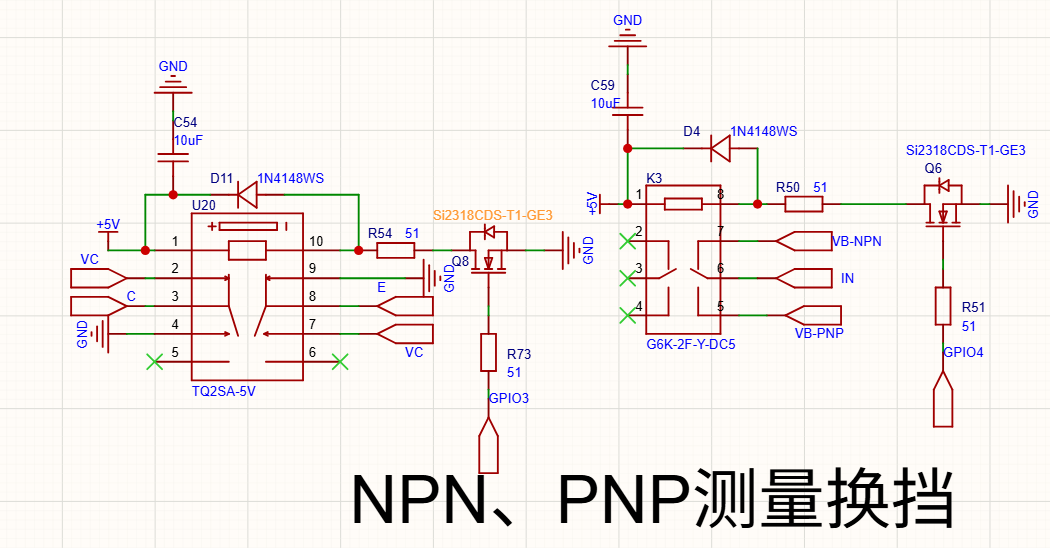
board/hardware/bjt/schematic_polarity_switch.png
