hscsja03-afk/-BJT-/board/hardware/bjt/schematic_power_amplifier.png

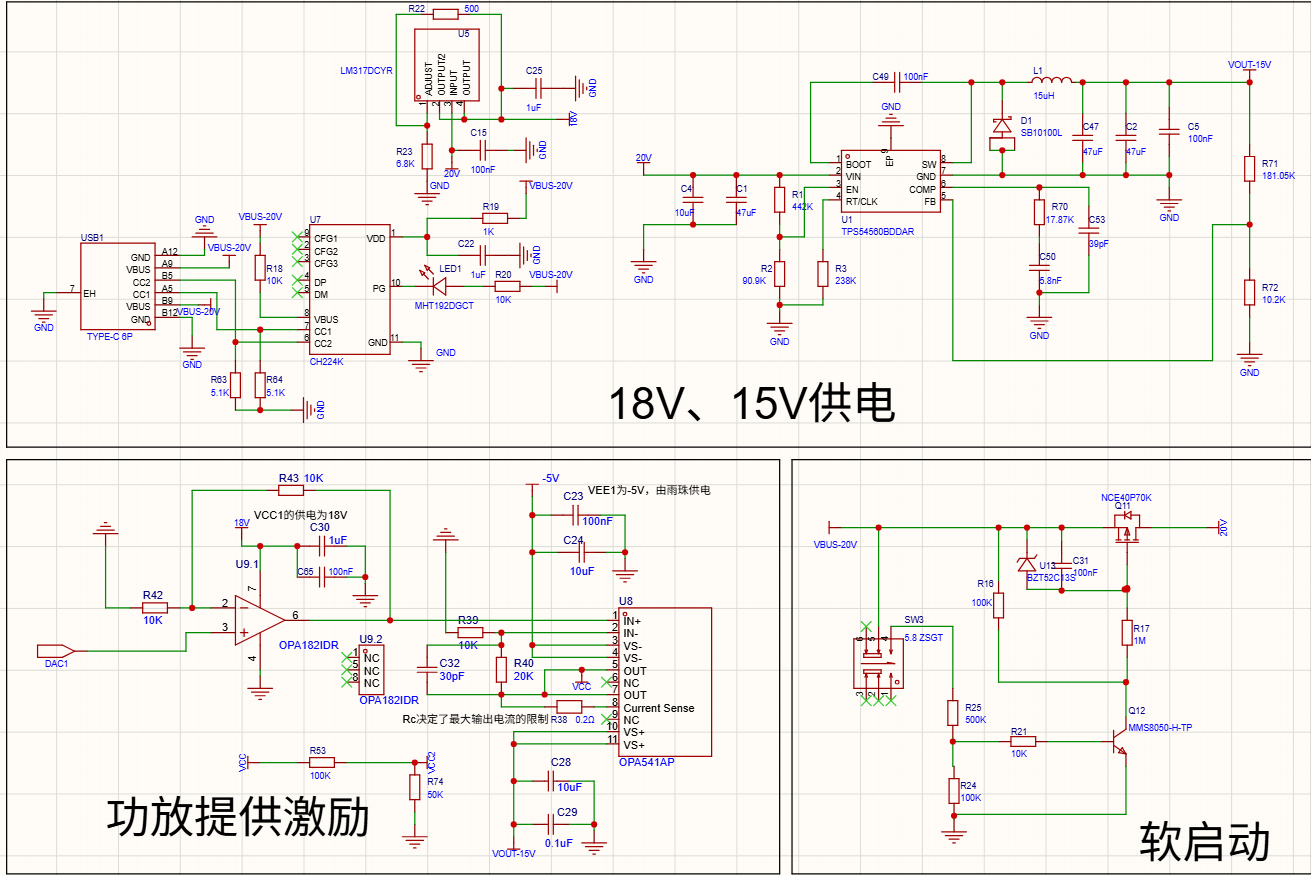
board/hardware/bjt/schematic_power_amplifier.png
