hscsja03-afk/-BJT-/board/hardware/adda/design_notes.xlsx

Sheet: 使用说明
项目 | 内容
工程 | 高速DAC.eprj2；Schematic4
网表 | Netlist_Schematic4_2026-10-14.tel
编号 | 底板X1对应核心板X3；底板X2对应核心板X4；核心板触点=101−底板触点。
内容 | 按功能分组列出当前网络、器件引脚和连接路径，不列ZYNQ球脚。
JTAG | 经串联电阻连接CN3端子。
以太网 | 核心板PHY的四组MDI差分对连接RJ1。
显示 | RGB并行LCD及触摸接口。
PS控制 | 当前SPI控制线使用GPIO软件模拟；CH340X串口使用UART0。
手册依据 | AMD UG585：MIO-at-a-Glance、SPI MIO Pin Limitation、MIO_PIN_14。
手册链接 | https://docs.amd.com/r/en-US/ug585-zynq-7000-SoC-TRM/MIO-at-a-Glance-Table
SPI复用表 | https://docs.amd.com/r/en-US/ug585-zynq-7000-SoC-TRM/MIO-Pin-Limitation

Sheet: 全部BTB触点
功能组 | 底板连接器 | 底板触点 | 核心板连接器 | 核心板触点 | 核心板网络 | 当前原理图网络 | 对应器件 | 器件信号 | 器件引脚 | 中间器件／路径 | 说明 | PS控制方式
JTAG | X1 | 1 | X3 | 100 | FPGA_TMS | FPGATMS | CN3 JTAG端子 | FPGATMS |  | X1.1 -> R116.2 -> CN3.4 | 串联电阻连接
JTAG | X1 | 2 | X3 | 99 | FPGA_TCK | FPGATCK | CN3 JTAG端子 | FPGATCK |  | X1.2 -> R117.2 -> CN3.6 | 串联电阻连接
JTAG | X1 | 3 | X3 | 98 | FPGA_TDI | FPGATDI | CN3 JTAG端子 | FPGATDI |  | X1.3 -> R119.2 -> CN3.10 | 串联电阻连接
JTAG | X1 | 4 | X3 | 97 | FPGA_TDO | FPGATDO | CN3 JTAG端子 | FPGATDO |  | X1.4 -> R118.2 -> CN3.8 | 串联电阻连接
CH340X | X1 | 12 | X3 | 89 | UART_RXD | UART1RXD PS_MIO14 | U8 CH340X | TXD | 8 | U6缓冲 |  | 硬件UART0_RX
CH340X | X1 | 14 | X3 | 87 | UART_TXD | UART1TXD PS_MIO15 | U8 CH340X | RXD | 9 | U29缓冲 |  | 硬件UART0_TX
AD9268 | X1 | 32 | X3 | 69 | OTG_DIR | A_SDIO/DCS | U1 AD9268 | SDIO/DCS | 44 | 直接同网 |  | GPIO软件模拟
AD9268 | X1 | 34 | X3 | 67 | OTG_STP | A_SCLK/DFS | U1 AD9268 | SCLK/DFS | 45 | 直接同网 |  | GPIO软件模拟
AD9268 | X1 | 36 | X3 | 65 | OTG_NXT | A_CSBA | U1 AD9268 | CSB | 46 | 直接同网 |  | GPIO软件模拟
AD9268 | X2 | 13 | X4 | 88 | B13_L19_N | ADC_A_D14 | U1 AD9268 | D14A | 41 | U33:2A7→2B7 | 1.8 V→3.3 V电平转换
AD9268 | X2 | 14 | X4 | 87 | B13_L22_P | ADC_A_D15 | U1 AD9268 | D15A(MSB) | 42 | U33:2A8→2B8 | 1.8 V→3.3 V电平转换
AD9268 | X2 | 16 | X4 | 85 | B13_L22_N | ADC_A_D13 | U1 AD9268 | D13A | 40 | U33:2A6→2B6 | 1.8 V→3.3 V电平转换
AD9268 | X2 | 17 | X4 | 84 | B13_L11_N | ADC_A_D12 | U1 AD9268 | D12A | 39 | U33:2A5→2B5 | 1.8 V→3.3 V电平转换
AD9268 | X2 | 18 | X4 | 83 | B13_L13_N | ADC_A_D11 | U1 AD9268 | D11A | 38 | U33:2A4→2B4 | 1.8 V→3.3 V电平转换
AD9268 | X2 | 20 | X4 | 81 | B13_L13_P | ADC_A_D10 | U1 AD9268 | D10A | 36 | U33:2A3→2B3 | 1.8 V→3.3 V电平转换
AD9268 | X2 | 21 | X4 | 80 | B13_L15_N | ADC_B_D0(LSB) | U1 AD9268 | D0B(LSB) | 4 | U36:1A1→1B1 | 1.8 V→3.3 V电平转换
AD9268 | X2 | 22 | X4 | 79 | B13_L14_N | ADC_A_D9 | U1 AD9268 | D9A | 35 | U33:2A2→2B2 | 1.8 V→3.3 V电平转换
AD9268 | X2 | 24 | X4 | 77 | B13_L14_P | ADC_A_D8 | U1 AD9268 | D8A | 34 | U33:2A1→2B1 | 1.8 V→3.3 V电平转换
AD9268 | X2 | 25 | X4 | 76 | B13_L17_P | ADC_ORB | U1 AD9268 | ORB | 22 | U39:A4→B4 | 1.8 V→3.3 V电平转换
AD9268 | X2 | 26 | X4 | 75 | B13_L16_N | ADC_A_D7 | U1 AD9268 | D7A | 33 | U33:1A8→1B8 | 1.8 V→3.3 V电平转换
AD9268 | X2 | 27 | X4 | 74 | B13_L12_P | ADC_ORA | U1 AD9268 | ORA | 43 | U39:A1→B1 | 1.8 V→3.3 V电平转换
AD9268 | X2 | 28 | X4 | 73 | B13_L16_P | ADC_A_D6 | U1 AD9268 | D6A | 32 | U33:1A7→1B7 | 1.8 V→3.3 V电平转换
AD9268 | X2 | 29 | X4 | 72 | B13_L12_N | ADC_OCOA | U1 AD9268 | DCOA | 24 | U39:A2→B2 | 1.8 V→3.3 V电平转换
AD9268 | X2 | 30 | X4 | 71 | B13_L21_N | ADC_A_D5 | U1 AD9268 | D5A | 31 | U33:1A6→1B6 | 1.8 V→3.3 V电平转换
AD9268 | X2 | 32 | X4 | 69 | B13_L21_P | ADC_A_D4 | U1 AD9268 | D4A | 30 | U33:1A5→1B5 | 1.8 V→3.3 V电平转换
AD9268 | X2 | 33 | X4 | 68 | B34_L1_N | ADC_B_D15 | U1 AD9268 | D15B(MSB) | 21 | U36:2A8→2B8 | 1.8 V→3.3 V电平转换
AD9268 | X2 | 34 | X4 | 67 | B13_L20_P | ADC_A_D3 | U1 AD9268 | D3A | 29 | U33:1A4→1B4 | 1.8 V→3.3 V电平转换
AD9268 | X2 | 35 | X4 | 66 | B34_L1_P | ADC_B_D14 | U1 AD9268 | D14B | 20 | U36:2A7→2B7 | 1.8 V→3.3 V电平转换
AD9268 | X2 | 36 | X4 | 65 | B13_L20_N | ADC_A_D2 | U1 AD9268 | D2A | 27 | U33:1A3→1B3 | 1.8 V→3.3 V电平转换
AD9268 | X2 | 37 | X4 | 64 | B34_L2_P | ADC_B_D13 | U1 AD9268 | D13B | 18 | U36:2A6→2B6 | 1.8 V→3.3 V电平转换
AD9268 | X2 | 38 | X4 | 63 | B13_L18_P | ADC_A_D1 | U1 AD9268 | D1A | 26 | U33:1A2→1B2 | 1.8 V→3.3 V电平转换
AD9268 | X2 | 39 | X4 | 62 | B34_L2_N | ADC_B_D12 | U1 AD9268 | D12B | 17 | U36:2A5→2B5 | 1.8 V→3.3 V电平转换
AD9268 | X2 | 40 | X4 | 61 | B13_L18_N | ADC_A_D0(LSB) | U1 AD9268 | D0A(LSB) | 25 | U33:1A1→1B1 | 1.8 V→3.3 V电平转换
AD9268 | X2 | 41 | X4 | 60 | B34_L6_P | ADC_B_D11 | U1 AD9268 | D11B | 16 | U36:2A4→2B4 | 1.8 V→3.3 V电平转换
AD9268 | X2 | 43 | X4 | 58 | B34_L6_N | ADC_B_D10 | U1 AD9268 | D10B | 15 | U36:2A3→2B3 | 1.8 V→3.3 V电平转换
AD9268 | X2 | 44 | X4 | 57 | B34_L4_P | ADC_B_D9 | U1 AD9268 | D9B | 14 | U36:2A2→2B2 | 1.8 V→3.3 V电平转换
AD9268 | X2 | 45 | X4 | 56 | B34_L3_P | ADC_B_D8 | U1 AD9268 | D8B | 13 | U36:2A1→2B1 | 1.8 V→3.3 V电平转换
AD9268 | X2 | 46 | X4 | 55 | B34_L4_N | ADC_B_D7 | U1 AD9268 | D7B | 12 | U36:1A8→1B8 | 1.8 V→3.3 V电平转换
AD9268 | X2 | 47 | X4 | 54 | B34_L3_N | ADC_B_D6 | U1 AD9268 | D6B | 11 | U36:1A7→1B7 | 1.8 V→3.3 V电平转换
AD9268 | X2 | 48 | X4 | 53 | B34_L8_P | ADC_B_D5 | U1 AD9268 | D5B | 9 | U36:1A6→1B6 | 1.8 V→3.3 V电平转换
AD9268 | X2 | 50 | X4 | 51 | B34_L8_N | ADC_B_D4 | U1 AD9268 | D4B | 8 | U36:1A5→1B5 | 1.8 V→3.3 V电平转换
AD9268 | X2 | 51 | X4 | 50 | B34_L11_P | ADC_OCOB | U1 AD9268 | DCOB | 23 | U39:A3→B3 | 1.8 V→3.3 V电平转换
AD9268 | X2 | 52 | X4 | 49 | B34_L10_P | ADC_B_D3 | U1 AD9268 | D3B | 7 | U36:1A4→1B4 | 1.8 V→3.3 V电平转换
AD9268 | X2 | 53 | X4 | 48 | B34_L11_N | ADC_B_D2 | U1 AD9268 | D2B | 6 | U36:1A3→1B3 | 1.8 V→3.3 V电平转换
AD9268 | X2 | 54 | X4 | 47 | B34_L10_N | ADC_B_D1 | U1 AD9268 | D1B | 5 | U36:1A2→1B2 | 1.8 V→3.3 V电平转换
AD9747 | X1 | 5 | X3 | 96 | PS_MIO9 | PS_MIO9 | U2 AD9747 | SDO | 49 | 直接同网 | SPI控制 | GPIO软件模拟输入
AD9747 | X1 | 6 | X3 | 95 | PS_MIO8 | PS_MIO8 | U2 AD9747 | SDIO | 50 | 直接同网 | SPI控制 | GPIO软件模拟输出
AD9747 | X1 | 7 | X3 | 94 | PS_MIO11 | D_RESET | U2 AD9747 | RESET | 53 | 直接同网 | AD9747 RESET；官方触点对应PS_MIO11，当前网络命名为D_RESET | GPIO软件模拟输出
AD9747 | X1 | 9 | X3 | 92 | PS_MIO7 | PS_MIO7 | U2 AD9747 | SCLK | 51 | 直接同网 | SPI控制 | GPIO软件模拟输出
AD9747 | X1 | 10 | X3 | 91 | PS_MIO10 | CSBD | U2 AD9747 | CSB | 52 | 直接同网 |  | GPIO软件模拟输出
AD9747 | X1 | 11 | X3 | 90 | PS_MIO12 | IQSEL | U2 AD9747 | IQSEL | 29 | 直接同网 |  | GPIO软件模拟输出
AD9747 | X1 | 40 | X3 | 61 | B35_L21_P | B35_L21_P | U2 AD9747 | P2D0 | 46 | 直接同网
AD9747 | X1 | 41 | X3 | 60 | B35_L23_P | B35_L23_P | U2 AD9747 | P1D0 | 24 | 直接同网
AD9747 | X1 | 42 | X3 | 59 | B35_L21_N | B35_L21_N | U2 AD9747 | P2D1 | 45 | 直接同网
AD9747 | X1 | 43 | X3 | 58 | B35_L23_N | B35_L23_N | U2 AD9747 | P1D1 | 23 | 直接同网
AD9747 | X1 | 44 | X3 | 57 | B35_L22_P | B35_L22_P | U2 AD9747 | P2D2 | 44 | 直接同网
AD9747 | X1 | 45 | X3 | 56 | B35_L20_P | B35_L20_P | U2 AD9747 | P1D2 | 22 | 直接同网
AD9747 | X1 | 46 | X3 | 55 | B35_L22_N | B35_L22_N | U2 AD9747 | P2D3 | 43 | 直接同网
AD9747 | X1 | 47 | X3 | 54 | B35_L20_N | B35_L20_N | U2 AD9747 | P1D3 | 21 | 直接同网
AD9747 | X1 | 49 | X3 | 52 | B35_L11_P | B35_L11_P | U2 AD9747 | DCO | 25 | 直接同网
AD9747 | X1 | 50 | X3 | 51 | B35_L6_P | B35_L6_P | U2 AD9747 | P2D4 | 42 | 直接同网
AD9747 | X1 | 52 | X3 | 49 | B35_L6_N | B35_L6_N | U2 AD9747 | P2D5 | 41 | 直接同网
AD9747 | X1 | 53 | X3 | 48 | B35_IO25 | B35_IO25 | U2 AD9747 | P1D4 | 20 | 直接同网
AD9747 | X1 | 54 | X3 | 47 | B35_L5_P | B35_L5_P | U2 AD9747 | P2D6 | 40 | 直接同网
AD9747 | X1 | 55 | X3 | 46 | B35_IO0 | B35_IO0 | U2 AD9747 | P1D5 | 19 | 直接同网
AD9747 | X1 | 56 | X3 | 45 | B35_L5_N | B35_L5_N | U2 AD9747 | P2D7 | 39 | 直接同网
AD9747 | X1 | 57 | X3 | 44 | B35_L19_P | B35_L19_P | U2 AD9747 | P1D6 | 18 | 直接同网
AD9747 | X1 | 58 | X3 | 43 | B35_L16_P | B35_L16_P | U2 AD9747 | P2D8 | 38 | 直接同网
AD9747 | X1 | 59 | X3 | 42 | B35_L19_N | B35_L19_N | U2 AD9747 | P1D7 | 17 | 直接同网
AD9747 | X1 | 60 | X3 | 41 | B35_L16_N | B35_L16_N | U2 AD9747 | P2D9 | 37 | 直接同网
AD9747 | X1 | 61 | X3 | 40 | B35_L13_P | B35_L13_P | U2 AD9747 | P1D8 | 16 | 直接同网
AD9747 | X1 | 63 | X3 | 38 | B35_L13_N | B35_L13_N | U2 AD9747 | P1D9 | 15 | 直接同网
AD9747 | X1 | 65 | X3 | 36 | B35_L2_N | B35_L2_N | U2 AD9747 | P1D10 | 14 | 直接同网
AD9747 | X1 | 67 | X3 | 34 | B35_L2_P | B35_L2_P | U2 AD9747 | P1D11 | 13 | 直接同网
AD9747 | X1 | 69 | X3 | 32 | B35_L3_P | B35_L3_P | U2 AD9747 | P1D12 | 12 | 直接同网
AD9747 | X1 | 71 | X3 | 30 | B35_L3_N | B35_L3_N | U2 AD9747 | P1D13 | 11 | 直接同网
AD9747 | X1 | 73 | X3 | 28 | B35_L12_P | B35_L12_P | U2 AD9747 | P1D14 | 10 | 直接同网
AD9747 | X1 | 75 | X3 | 26 | B35_L12_N | B35_L12_N | U2 AD9747 | P1D15 | 9 | 直接同网
AD9747 | X1 | 78 | X3 | 23 | B35_L18_N | B35_L18_N | U2 AD9747 | P2D10 | 36 | 直接同网
AD9747 | X1 | 80 | X3 | 21 | B35_L18_P | B35_L18_P | U2 AD9747 | P2D11 | 35 | 直接同网
AD9747 | X1 | 82 | X3 | 19 | B35_L10_N | B35_L10_N | U2 AD9747 | P2D12 | 34 | 直接同网
AD9747 | X1 | 84 | X3 | 17 | B35_L10_P | B35_L10_P | U2 AD9747 | P2D13 | 33 | 直接同网
AD9747 | X1 | 86 | X3 | 15 | B35_L17_N | B35_L17_N | U2 AD9747 | P2D14 | 32 | 直接同网
AD9747 | X1 | 88 | X3 | 13 | B35_L17_P | B35_L17_P | U2 AD9747 | P2D15 | 31 | 直接同网
AD9516-3 | X1 | 5 | X3 | 96 | PS_MIO9 | PS_MIO9 | U3 AD9516-3 | SDO | 21 | 直接同网 | SPI控制 | GPIO软件模拟输入
AD9516-3 | X1 | 6 | X3 | 95 | PS_MIO8 | PS_MIO8 | U3 AD9516-3 | SDIO# | 22 | 直接同网 | SPI控制 | GPIO软件模拟输出
AD9516-3 | X1 | 8 | X3 | 93 | PS_MIO13 | CS | U3 AD9516-3 | CS# | 17 | 直接同网 |  | GPIO软件模拟输出
AD9516-3 | X1 | 9 | X3 | 92 | PS_MIO7 | PS_MIO7 | U3 AD9516-3 | SCLK | 16 | 直接同网 | SPI控制 | GPIO软件模拟输出
AD9516-3 | X1 | 62 | X3 | 39 | B35_L8_P | B35_L8_P | U3 AD9516-3 | RESET# | 23 | 直接同网
AD9516-3 | X1 | 64 | X3 | 37 | B35_L8_N | B35_L8_N | U3 AD9516-3 | SYNC | 8 | 直接同网
AD9516-3 | X1 | 66 | X3 | 35 | B35_L9_N | B35_L9_N | U3 AD9516-3 | REFMON | 2 | 直接同网
AD9516-3 | X1 | 68 | X3 | 33 | B35_L9_P | B35_L9_P | U3 AD9516-3 | STATUS | 6 | 直接同网
AD9516-3 | X2 | 23 | X4 | 78 | B13_L17_N | B13_L17_P | U3 AD9516-3 | LD | 3 | 直接同网
ADC输出使能 | X1 | 31 | X3 | 70 | OTG_DATA0 | ADC_DATA_OE_N | U33；U33；U36；U36 | 2OE#；1OE#；2OE#；1OE# | 25；48；25；48 | 直接同网 | 1.8 V控制，低有效
ADC输出使能 | X1 | 33 | X3 | 68 | OTG_DATA1 | ADC_CTRL_OE_N | U39 | OE# | 9 | 直接同网 | 1.8 V控制，低有效
LCD与触摸 | X1 | 51 | X3 | 50 | B35_L11_N | B35_L11_N LCD_RST | FPC1 LCD与触摸 | 40 | 40 | 直接同网
LCD与触摸 | X1 | 70 | X3 | 31 | B35_L7_P | B35_L7_P T_CS | FPC1 LCD与触摸 | 35 | 35 | 直接同网
LCD与触摸 | X1 | 72 | X3 | 29 | B35_L7_N | B35_L7_N LCD_BL | FPC1 LCD与触摸 | 34 | 34 | 直接同网
LCD与触摸 | X2 | 55 | X4 | 46 | B34_L5_P | B34_L5_P LCD_R2 | FPC1 LCD与触摸 | 5 | 5 | 直接同网
LCD与触摸 | X2 | 56 | X4 | 45 | B34_L18_P | B34_L18_P LCD_R0 | FPC1 LCD与触摸 | 4 | 4 | 直接同网
LCD与触摸 | X2 | 57 | X4 | 44 | B34_L5_N | B34_L5_N LCD_R3 | FPC1 LCD与触摸 | 6 | 6 | 直接同网
LCD与触摸 | X2 | 58 | X4 | 43 | B34_L18_N | B34_L18_N LCD_R1 | FPC1 LCD与触摸 | 3 | 3 | 直接同网
LCD与触摸 | X2 | 59 | X4 | 42 | B34_L9_P | B34_L9_P LCD_R6 | FPC1 LCD与触摸 | 9 | 9 | 直接同网
LCD与触摸 | X2 | 61 | X4 | 40 | B34_L9_N | B34_L9_N LCD_R7 | FPC1 LCD与触摸 | 10 | 10 | 直接同网
LCD与触摸 | X2 | 62 | X4 | 39 | B34_L7_N | B34_L7_N LCD_R4 | FPC1 LCD与触摸 | 8 | 8 | 直接同网
LCD与触摸 | X2 | 63 | X4 | 38 | B34_L20_P | B34_L20_P LCD_G2 | FPC1 LCD与触摸 | 14 | 14 | 直接同网
LCD与触摸 | X2 | 64 | X4 | 37 | B34_L7_P | B34_L7_P LCD_R5 | FPC1 LCD与触摸 | 7 | 7 | 直接同网
LCD与触摸 | X2 | 65 | X4 | 36 | B34_L20_N | B34_L20_N LCD_G3 | FPC1 LCD与触摸 | 15 | 15 | 直接同网
LCD与触摸 | X2 | 66 | X4 | 35 | B34_L21_P | B34_L21_P LCD_G0 | FPC1 LCD与触摸 | 13 | 13 | 直接同网
LCD与触摸 | X2 | 68 | X4 | 33 | B34_L21_N | B34_L21_N LCD_G1 | FPC1 LCD与触摸 | 12 | 12 | 直接同网
LCD与触摸 | X2 | 69 | X4 | 32 | B34_L24_P | B34_L24_P LCD_G6 | FPC1 LCD与触摸 | 18 | 18 | 直接同网
LCD与触摸 | X2 | 70 | X4 | 31 | B34_L17_P | B34_L17_P LCD_G4 | FPC1 LCD与触摸 | 17 | 17 | 直接同网
LCD与触摸 | X2 | 71 | X4 | 30 | B34_L24_N | B34_L24_N LCD_G7 | FPC1 LCD与触摸 | 19 | 19 | 直接同网
LCD与触摸 | X2 | 72 | X4 | 29 | B34_L17_N | B34_L17_N LCD_G5 | FPC1 LCD与触摸 | 16 | 16 | 直接同网
LCD与触摸 | X2 | 73 | X4 | 28 | B34_L19_P | B34_L19_P LCD_B2 | FPC1 LCD与触摸 | 23 | 23 | 直接同网
LCD与触摸 | X2 | 74 | X4 | 27 | B34_L22_P | B34_L22_P LCD_B0 | FPC1 LCD与触摸 | 22 | 22 | 直接同网
LCD与触摸 | X2 | 75 | X4 | 26 | B34_L19_N | B34_L19_N LCD_B3 | FPC1 LCD与触摸 | 24 | 24 | 直接同网
LCD与触摸 | X2 | 76 | X4 | 25 | B34_L22_N | B34_L22_N LCD_B1 | FPC1 LCD与触摸 | 21 | 21 | 直接同网
LCD与触摸 | X2 | 77 | X4 | 24 | B34_IO0 | B34_IO0 II2C_SCL | FPC1 LCD与触摸 | 38 | 38 | 直接同网
LCD与触摸 | X2 | 78 | X4 | 23 | B34_L16_N | B34_L16_N LCD_B4 | FPC1 LCD与触摸 | 26 | 26 | 直接同网
LCD与触摸 | X2 | 79 | X4 | 22 | B34_L23_N | B34_L23_N LCD_B6 | FPC1 LCD与触摸 | 27 | 27 | 直接同网
LCD与触摸 | X2 | 80 | X4 | 21 | B34_L16_P | B34_L16_P LCD_B5 | FPC1 LCD与触摸 | 25 | 25 | 直接同网
LCD与触摸 | X2 | 81 | X4 | 20 | B34_L23_P | B34_L23_P LCD_B7 | FPC1 LCD与触摸 | 28 | 28 | 直接同网
LCD与触摸 | X2 | 83 | X4 | 18 | B34_L13_N | B34_L13_N LCD_CLK | FPC1 LCD与触摸 | 30 | 30 | 直接同网
LCD与触摸 | X2 | 84 | X4 | 17 | B34_L12_N | B34_L12_N T_PEN | FPC1 LCD与触摸 | 39 | 39 | 直接同网
LCD与触摸 | X2 | 85 | X4 | 16 | B34_L13_P | B34_L13_P LCD_HSYNC | FPC1 LCD与触摸 | 31 | 31 | 直接同网
LCD与触摸 | X2 | 87 | X4 | 14 | B34_L14_N | B34_L14_N II2C_SDA | FPC1 LCD与触摸 | 36 | 36 | 直接同网
LCD与触摸 | X2 | 88 | X4 | 13 | B34_L15_P | B34_L15_P LCD_VSYNC | FPC1 LCD与触摸 | 32 | 32 | 直接同网
LCD与触摸 | X2 | 89 | X4 | 12 | B34_L14_P | B34_L14_P T_MISO | FPC1 LCD与触摸 | 37 | 37 | 直接同网
LCD与触摸 | X2 | 90 | X4 | 11 | B34_L15_N | B34_L15_N LCD_DE | FPC1 LCD与触摸 | 33 | 33 | 直接同网
千兆以太网 | X1 | 91 | X3 | 10 | PHY_MDI3_N | PHY1MDI3N | RJ1 千兆网口 | PHY1MDI3N |  | RJ1.P9 <-> PHY_MDI3_N | 核心板PHY至RJ1
千兆以太网 | X1 | 92 | X3 | 9 | PHY_MDI1_N | PHY1MDI1N | RJ1 千兆网口 | PHY1MDI1N |  | RJ1.P7 <-> PHY_MDI1_N | 核心板PHY至RJ1
千兆以太网 | X1 | 93 | X3 | 8 | PHY_MDI3_P | PHY1MDI3P | RJ1 千兆网口 | PHY1MDI3P |  | RJ1.P8 <-> PHY_MDI3_P | 核心板PHY至RJ1
千兆以太网 | X1 | 94 | X3 | 7 | PHY_MDI1_P | PHY1MDI1P | RJ1 千兆网口 | PHY1MDI1P |  | RJ1.P4 <-> PHY_MDI1_P | 核心板PHY至RJ1
千兆以太网 | X1 | 95 | X3 | 6 | PHY_MDI2_N | PHY1MDI2N | RJ1 千兆网口 | PHY1MDI2N |  | RJ1.P6 <-> PHY_MDI2_N | 核心板PHY至RJ1
千兆以太网 | X1 | 96 | X3 | 5 | PHY_MDI0_N | PHY1MDI0N | RJ1 千兆网口 | PHY1MDI0N |  | RJ1.P3 <-> PHY_MDI0_N | 核心板PHY至RJ1
千兆以太网 | X1 | 97 | X3 | 4 | PHY_MDI2_P | PHY1MDI2P | RJ1 千兆网口 | PHY1MDI2P |  | RJ1.P5 <-> PHY_MDI2_P | 核心板PHY至RJ1
千兆以太网 | X1 | 98 | X3 | 3 | PHY_MDI0_P | PHY1MDI0P | RJ1 千兆网口 | PHY1MDI0P |  | RJ1.P2 <-> PHY_MDI0_P | 核心板PHY至RJ1
电源与地 | X1 | 24 | X3 | 77 | GND | GND |  |  |  | 直接同网
电源与地 | X1 | 25 | X3 | 76 | GND | GND |  |  |  | 直接同网
电源与地 | X1 | 38 | X3 | 63 | GND | GND |  |  |  | 直接同网
电源与地 | X1 | 39 | X3 | 62 | GND | GND |  |  |  | 直接同网
电源与地 | X1 | 89 | X3 | 12 | GND | GND |  |  |  | 直接同网
电源与地 | X1 | 90 | X3 | 11 | GND | GND |  |  |  | 直接同网
电源与地 | X2 | 1 | X4 | 100 | GND | GND |  |  |  | 直接同网
电源与地 | X2 | 2 | X4 | 99 | GND | GND |  |  |  | 直接同网
电源与地 | X2 | 3 | X4 | 98 | GND | GND |  |  |  | 直接同网
电源与地 | X2 | 4 | X4 | 97 | GND | GND |  |  |  | 直接同网
电源与地 | X2 | 5 | X4 | 96 | GND | GND |  |  |  | 直接同网
电源与地 | X2 | 6 | X4 | 95 | GND | GND |  |  |  | 直接同网
电源与地 | X2 | 7 | X4 | 94 | GND | GND |  |  |  | 直接同网
电源与地 | X2 | 8 | X4 | 93 | GND | GND |  |  |  | 直接同网
电源与地 | X2 | 31 | X4 | 70 | GND | GND |  |  |  | 直接同网
电源与地 | X2 | 42 | X4 | 59 | GND | GND |  |  |  | 直接同网
电源与地 | X2 | 49 | X4 | 52 | GND | GND |  |  |  | 直接同网
电源与地 | X2 | 60 | X4 | 41 | GND | GND |  |  |  | 直接同网
电源与地 | X2 | 67 | X4 | 34 | GND | GND |  |  |  | 直接同网
电源与地 | X2 | 82 | X4 | 19 | GND | GND |  |  |  | 直接同网
电源与地 | X2 | 93 | X4 | 8 | +5v | 5.0V |  |  |  | 直接同网
电源与地 | X2 | 94 | X4 | 7 | +5v | 5.0V |  |  |  | 直接同网
电源与地 | X2 | 95 | X4 | 6 | +5v | 5.0V |  |  |  | 直接同网
电源与地 | X2 | 96 | X4 | 5 | +5v | 5.0V |  |  |  | 直接同网
电源与地 | X2 | 97 | X4 | 4 | +5v | 5.0V |  |  |  | 直接同网
电源与地 | X2 | 98 | X4 | 3 | +5v | 5.0V |  |  |  | 直接同网
电源与地 | X2 | 99 | X4 | 2 | +5v | 5.0V |  |  |  | 直接同网
电源与地 | X2 | 100 | X4 | 1 | +5v | 5.0V |  |  |  | 直接同网
扩展接口 | X1 | 48 | X3 | 53 | B35_L24_P | B35_L24_P | U18 扩展接口 | 14 | 14 | R41(100)
扩展接口 | X1 | 77 | X3 | 24 | B35_L1_N | B35_L1_N | U18 扩展接口 | 12 | 12 | R35(100)
扩展接口 | X1 | 79 | X3 | 22 | B35_L1_P | B35_L1_P | U18 扩展接口 | 10 | 10 | R36(100)
扩展接口 | X1 | 81 | X3 | 20 | B35_L4_P | B35_L4_P | U18 扩展接口 | 8 | 8 | R37(100)
扩展接口 | X1 | 83 | X3 | 18 | B35_L4_N | B35_L4_N | U18 扩展接口 | 6 | 6 | R38(100)
扩展接口 | X1 | 85 | X3 | 16 | B35_L15_P | B35_L15_P | U18 扩展接口 | 4 | 4 | R39(100)
扩展接口 | X1 | 87 | X3 | 14 | B35_L15_N | B35_L15_N | U18 扩展接口 | 2 | 2 | R40(100)
空余或其他预留 | X1 | 13 | X3 | 88 | SD_D3 | SD_D3 |  |  |  | 直接同网 | 预留
空余或其他预留 | X1 | 15 | X3 | 86 | SD_D2 | SD_D2 |  |  |  | 直接同网 | 预留
空余或其他预留 | X1 | 16 | X3 | 85 | XADC_VP | XADC_VP |  |  |  | 直接同网 | 预留
空余或其他预留 | X1 | 17 | X3 | 84 | SD_D1 | SD_D1 |  |  |  | 直接同网 | 预留
空余或其他预留 | X1 | 18 | X3 | 83 | XADC_VN | XADC_VN |  |  |  | 直接同网 | 预留
空余或其他预留 | X1 | 19 | X3 | 82 | SD_D0 | SD_D0 |  |  |  | 直接同网 | 预留
空余或其他预留 | X1 | 20 | X3 | 81 | QSPI_D2 | QSPI_D2 BOOT MODE0 |  |  |  | 直接同网 | 预留
空余或其他预留 | X1 | 21 | X3 | 80 | SD_CLK | SD_CLK |  |  |  | 直接同网 | 预留
空余或其他预留 | X1 | 22 | X3 | 79 | QSPI_D3 | QSPI_D3 BOOT MODE1 |  |  |  | 直接同网 | 预留
空余或其他预留 | X1 | 23 | X3 | 78 | SD_CMD | SD_CMD |  |  |  | 直接同网 | 预留
空余或其他预留 | X1 | 26 | X3 | 75 | OTG_DATA3 | OTG_DATA3 |  |  |  | 直接同网 | 预留
空余或其他预留 | X1 | 27 | X3 | 74 | OTG_DATA5 | OTG_DATA5 |  |  |  | 直接同网 | 预留
空余或其他预留 | X1 | 28 | X3 | 73 | OTG_DATA6 | OTG_DATA6 |  |  |  | 直接同网 | 预留
空余或其他预留 | X1 | 29 | X3 | 72 | OTG_DATA2 | OTG_DATA2 |  |  |  | 直接同网 | 预留
空余或其他预留 | X1 | 30 | X3 | 71 | OTG_CLK | OTG_CLK |  |  |  | 直接同网 | 预留
空余或其他预留 | X1 | 35 | X3 | 66 | OTG_DATA4 | OTG_DATA4 |  |  |  | 直接同网 | 预留
空余或其他预留 | X1 | 37 | X3 | 64 | OTG_DATA7 | OTG_DATA7 |  |  |  | 直接同网 | 预留
空余或其他预留 | X1 | 74 | X3 | 27 | B35_L14_N | B35_L14_N |  |  |  | 直接同网 | 预留
空余或其他预留 | X1 | 76 | X3 | 25 | B35_L14_P | B35_L14_P |  |  |  | 直接同网 | 预留
空余或其他预留 | X2 | 9 | X4 | 92 | / | 未命名／未连接 |  |  |  | 直接同网 | 预留
空余或其他预留 | X2 | 10 | X4 | 91 | / | 未命名／未连接 |  |  |  | 直接同网 | 预留
空余或其他预留 | X2 | 11 | X4 | 90 | B13_L19_P | B13_L19_P |  |  |  | 直接同网 | 预留
空余或其他预留 | X2 | 12 | X4 | 89 | B13_L6N | B13_L6N |  |  |  | 直接同网 | 预留
空余或其他预留 | X2 | 15 | X4 | 86 | B13_L11_P | B13_L11_P |  |  |  | 直接同网 | 预留
空余或其他预留 | X2 | 19 | X4 | 82 | B13_L15_P | B13_L15_P |  |  |  | 直接同网 | 预留
空余或其他预留 | X2 | 86 | X4 | 15 | B34_IO25 | B34_IO25 |  |  |  | 直接同网 | 预留
空余或其他预留 | X2 | 91 | X4 | 10 | / | 未命名／未连接 |  |  |  | 直接同网 | 预留
空余或其他预留 | X2 | 92 | X4 | 9 | / | 未命名／未连接 |  |  |  | 直接同网 | 预留
网口LED/PHY配置 | X1 | 99 | X3 | 2 | PHY_AD1/LED1 | PHY1AD1/LED1 | RJ1 | PHY1AD1/LED1 |  | X1.99 -> R111(510Ω) -> RJ1.P12 | 网口LED/PHY配置
网口LED/PHY配置 | X1 | 100 | X3 | 1 | PHY_AD0/LED0 | PHY1AD0/LED0 | RJ1 | PHY1AD0/LED0 |  | X1.100 -> R112(510Ω) -> RJ1.P13 | 网口LED/PHY配置

Sheet: ADDA与时钟
功能组 | 底板连接器 | 底板触点 | 核心板连接器 | 核心板触点 | 核心板网络 | 当前原理图网络 | 对应器件 | 器件信号 | 器件引脚 | 中间器件／路径 | 说明 | PS控制方式
AD9268 | X1 | 32 | X3 | 69 | OTG_DIR | A_SDIO/DCS | U1 AD9268 | SDIO/DCS | 44 | 直接同网 |  | GPIO软件模拟
AD9268 | X1 | 34 | X3 | 67 | OTG_STP | A_SCLK/DFS | U1 AD9268 | SCLK/DFS | 45 | 直接同网 |  | GPIO软件模拟
AD9268 | X1 | 36 | X3 | 65 | OTG_NXT | A_CSBA | U1 AD9268 | CSB | 46 | 直接同网 |  | GPIO软件模拟
AD9268 | X2 | 13 | X4 | 88 | B13_L19_N | ADC_A_D14 | U1 AD9268 | D14A | 41 | U33:2A7→2B7 | 1.8 V→3.3 V电平转换
AD9268 | X2 | 14 | X4 | 87 | B13_L22_P | ADC_A_D15 | U1 AD9268 | D15A(MSB) | 42 | U33:2A8→2B8 | 1.8 V→3.3 V电平转换
AD9268 | X2 | 16 | X4 | 85 | B13_L22_N | ADC_A_D13 | U1 AD9268 | D13A | 40 | U33:2A6→2B6 | 1.8 V→3.3 V电平转换
AD9268 | X2 | 17 | X4 | 84 | B13_L11_N | ADC_A_D12 | U1 AD9268 | D12A | 39 | U33:2A5→2B5 | 1.8 V→3.3 V电平转换
AD9268 | X2 | 18 | X4 | 83 | B13_L13_N | ADC_A_D11 | U1 AD9268 | D11A | 38 | U33:2A4→2B4 | 1.8 V→3.3 V电平转换
AD9268 | X2 | 20 | X4 | 81 | B13_L13_P | ADC_A_D10 | U1 AD9268 | D10A | 36 | U33:2A3→2B3 | 1.8 V→3.3 V电平转换
AD9268 | X2 | 21 | X4 | 80 | B13_L15_N | ADC_B_D0(LSB) | U1 AD9268 | D0B(LSB) | 4 | U36:1A1→1B1 | 1.8 V→3.3 V电平转换
AD9268 | X2 | 22 | X4 | 79 | B13_L14_N | ADC_A_D9 | U1 AD9268 | D9A | 35 | U33:2A2→2B2 | 1.8 V→3.3 V电平转换
AD9268 | X2 | 24 | X4 | 77 | B13_L14_P | ADC_A_D8 | U1 AD9268 | D8A | 34 | U33:2A1→2B1 | 1.8 V→3.3 V电平转换
AD9268 | X2 | 25 | X4 | 76 | B13_L17_P | ADC_ORB | U1 AD9268 | ORB | 22 | U39:A4→B4 | 1.8 V→3.3 V电平转换
AD9268 | X2 | 26 | X4 | 75 | B13_L16_N | ADC_A_D7 | U1 AD9268 | D7A | 33 | U33:1A8→1B8 | 1.8 V→3.3 V电平转换
AD9268 | X2 | 27 | X4 | 74 | B13_L12_P | ADC_ORA | U1 AD9268 | ORA | 43 | U39:A1→B1 | 1.8 V→3.3 V电平转换
AD9268 | X2 | 28 | X4 | 73 | B13_L16_P | ADC_A_D6 | U1 AD9268 | D6A | 32 | U33:1A7→1B7 | 1.8 V→3.3 V电平转换
AD9268 | X2 | 29 | X4 | 72 | B13_L12_N | ADC_OCOA | U1 AD9268 | DCOA | 24 | U39:A2→B2 | 1.8 V→3.3 V电平转换
AD9268 | X2 | 30 | X4 | 71 | B13_L21_N | ADC_A_D5 | U1 AD9268 | D5A | 31 | U33:1A6→1B6 | 1.8 V→3.3 V电平转换
AD9268 | X2 | 32 | X4 | 69 | B13_L21_P | ADC_A_D4 | U1 AD9268 | D4A | 30 | U33:1A5→1B5 | 1.8 V→3.3 V电平转换
AD9268 | X2 | 33 | X4 | 68 | B34_L1_N | ADC_B_D15 | U1 AD9268 | D15B(MSB) | 21 | U36:2A8→2B8 | 1.8 V→3.3 V电平转换
AD9268 | X2 | 34 | X4 | 67 | B13_L20_P | ADC_A_D3 | U1 AD9268 | D3A | 29 | U33:1A4→1B4 | 1.8 V→3.3 V电平转换
AD9268 | X2 | 35 | X4 | 66 | B34_L1_P | ADC_B_D14 | U1 AD9268 | D14B | 20 | U36:2A7→2B7 | 1.8 V→3.3 V电平转换
AD9268 | X2 | 36 | X4 | 65 | B13_L20_N | ADC_A_D2 | U1 AD9268 | D2A | 27 | U33:1A3→1B3 | 1.8 V→3.3 V电平转换
AD9268 | X2 | 37 | X4 | 64 | B34_L2_P | ADC_B_D13 | U1 AD9268 | D13B | 18 | U36:2A6→2B6 | 1.8 V→3.3 V电平转换
AD9268 | X2 | 38 | X4 | 63 | B13_L18_P | ADC_A_D1 | U1 AD9268 | D1A | 26 | U33:1A2→1B2 | 1.8 V→3.3 V电平转换
AD9268 | X2 | 39 | X4 | 62 | B34_L2_N | ADC_B_D12 | U1 AD9268 | D12B | 17 | U36:2A5→2B5 | 1.8 V→3.3 V电平转换
AD9268 | X2 | 40 | X4 | 61 | B13_L18_N | ADC_A_D0(LSB) | U1 AD9268 | D0A(LSB) | 25 | U33:1A1→1B1 | 1.8 V→3.3 V电平转换
AD9268 | X2 | 41 | X4 | 60 | B34_L6_P | ADC_B_D11 | U1 AD9268 | D11B | 16 | U36:2A4→2B4 | 1.8 V→3.3 V电平转换
AD9268 | X2 | 43 | X4 | 58 | B34_L6_N | ADC_B_D10 | U1 AD9268 | D10B | 15 | U36:2A3→2B3 | 1.8 V→3.3 V电平转换
AD9268 | X2 | 44 | X4 | 57 | B34_L4_P | ADC_B_D9 | U1 AD9268 | D9B | 14 | U36:2A2→2B2 | 1.8 V→3.3 V电平转换
AD9268 | X2 | 45 | X4 | 56 | B34_L3_P | ADC_B_D8 | U1 AD9268 | D8B | 13 | U36:2A1→2B1 | 1.8 V→3.3 V电平转换
AD9268 | X2 | 46 | X4 | 55 | B34_L4_N | ADC_B_D7 | U1 AD9268 | D7B | 12 | U36:1A8→1B8 | 1.8 V→3.3 V电平转换
AD9268 | X2 | 47 | X4 | 54 | B34_L3_N | ADC_B_D6 | U1 AD9268 | D6B | 11 | U36:1A7→1B7 | 1.8 V→3.3 V电平转换
AD9268 | X2 | 48 | X4 | 53 | B34_L8_P | ADC_B_D5 | U1 AD9268 | D5B | 9 | U36:1A6→1B6 | 1.8 V→3.3 V电平转换
AD9268 | X2 | 50 | X4 | 51 | B34_L8_N | ADC_B_D4 | U1 AD9268 | D4B | 8 | U36:1A5→1B5 | 1.8 V→3.3 V电平转换
AD9268 | X2 | 51 | X4 | 50 | B34_L11_P | ADC_OCOB | U1 AD9268 | DCOB | 23 | U39:A3→B3 | 1.8 V→3.3 V电平转换
AD9268 | X2 | 52 | X4 | 49 | B34_L10_P | ADC_B_D3 | U1 AD9268 | D3B | 7 | U36:1A4→1B4 | 1.8 V→3.3 V电平转换
AD9268 | X2 | 53 | X4 | 48 | B34_L11_N | ADC_B_D2 | U1 AD9268 | D2B | 6 | U36:1A3→1B3 | 1.8 V→3.3 V电平转换
AD9268 | X2 | 54 | X4 | 47 | B34_L10_N | ADC_B_D1 | U1 AD9268 | D1B | 5 | U36:1A2→1B2 | 1.8 V→3.3 V电平转换
AD9747 | X1 | 5 | X3 | 96 | PS_MIO9 | PS_MIO9 | U2 AD9747 | SDO | 49 | 直接同网 | SPI控制 | GPIO软件模拟输入
AD9747 | X1 | 6 | X3 | 95 | PS_MIO8 | PS_MIO8 | U2 AD9747 | SDIO | 50 | 直接同网 | SPI控制 | GPIO软件模拟输出
AD9747 | X1 | 7 | X3 | 94 | PS_MIO11 | D_RESET | U2 AD9747 | RESET | 53 | 直接同网 | AD9747 RESET；官方触点对应PS_MIO11，当前网络命名为D_RESET | GPIO软件模拟输出
AD9747 | X1 | 9 | X3 | 92 | PS_MIO7 | PS_MIO7 | U2 AD9747 | SCLK | 51 | 直接同网 | SPI控制 | GPIO软件模拟输出
AD9747 | X1 | 10 | X3 | 91 | PS_MIO10 | CSBD | U2 AD9747 | CSB | 52 | 直接同网 |  | GPIO软件模拟输出
AD9747 | X1 | 11 | X3 | 90 | PS_MIO12 | IQSEL | U2 AD9747 | IQSEL | 29 | 直接同网 |  | GPIO软件模拟输出
AD9747 | X1 | 40 | X3 | 61 | B35_L21_P | B35_L21_P | U2 AD9747 | P2D0 | 46 | 直接同网
AD9747 | X1 | 41 | X3 | 60 | B35_L23_P | B35_L23_P | U2 AD9747 | P1D0 | 24 | 直接同网
AD9747 | X1 | 42 | X3 | 59 | B35_L21_N | B35_L21_N | U2 AD9747 | P2D1 | 45 | 直接同网
AD9747 | X1 | 43 | X3 | 58 | B35_L23_N | B35_L23_N | U2 AD9747 | P1D1 | 23 | 直接同网
AD9747 | X1 | 44 | X3 | 57 | B35_L22_P | B35_L22_P | U2 AD9747 | P2D2 | 44 | 直接同网
AD9747 | X1 | 45 | X3 | 56 | B35_L20_P | B35_L20_P | U2 AD9747 | P1D2 | 22 | 直接同网
AD9747 | X1 | 46 | X3 | 55 | B35_L22_N | B35_L22_N | U2 AD9747 | P2D3 | 43 | 直接同网
AD9747 | X1 | 47 | X3 | 54 | B35_L20_N | B35_L20_N | U2 AD9747 | P1D3 | 21 | 直接同网
AD9747 | X1 | 49 | X3 | 52 | B35_L11_P | B35_L11_P | U2 AD9747 | DCO | 25 | 直接同网
AD9747 | X1 | 50 | X3 | 51 | B35_L6_P | B35_L6_P | U2 AD9747 | P2D4 | 42 | 直接同网
AD9747 | X1 | 52 | X3 | 49 | B35_L6_N | B35_L6_N | U2 AD9747 | P2D5 | 41 | 直接同网
AD9747 | X1 | 53 | X3 | 48 | B35_IO25 | B35_IO25 | U2 AD9747 | P1D4 | 20 | 直接同网
AD9747 | X1 | 54 | X3 | 47 | B35_L5_P | B35_L5_P | U2 AD9747 | P2D6 | 40 | 直接同网
AD9747 | X1 | 55 | X3 | 46 | B35_IO0 | B35_IO0 | U2 AD9747 | P1D5 | 19 | 直接同网
AD9747 | X1 | 56 | X3 | 45 | B35_L5_N | B35_L5_N | U2 AD9747 | P2D7 | 39 | 直接同网
AD9747 | X1 | 57 | X3 | 44 | B35_L19_P | B35_L19_P | U2 AD9747 | P1D6 | 18 | 直接同网
AD9747 | X1 | 58 | X3 | 43 | B35_L16_P | B35_L16_P | U2 AD9747 | P2D8 | 38 | 直接同网
AD9747 | X1 | 59 | X3 | 42 | B35_L19_N | B35_L19_N | U2 AD9747 | P1D7 | 17 | 直接同网
AD9747 | X1 | 60 | X3 | 41 | B35_L16_N | B35_L16_N | U2 AD9747 | P2D9 | 37 | 直接同网
AD9747 | X1 | 61 | X3 | 40 | B35_L13_P | B35_L13_P | U2 AD9747 | P1D8 | 16 | 直接同网
AD9747 | X1 | 63 | X3 | 38 | B35_L13_N | B35_L13_N | U2 AD9747 | P1D9 | 15 | 直接同网
AD9747 | X1 | 65 | X3 | 36 | B35_L2_N | B35_L2_N | U2 AD9747 | P1D10 | 14 | 直接同网
AD9747 | X1 | 67 | X3 | 34 | B35_L2_P | B35_L2_P | U2 AD9747 | P1D11 | 13 | 直接同网
AD9747 | X1 | 69 | X3 | 32 | B35_L3_P | B35_L3_P | U2 AD9747 | P1D12 | 12 | 直接同网
AD9747 | X1 | 71 | X3 | 30 | B35_L3_N | B35_L3_N | U2 AD9747 | P1D13 | 11 | 直接同网
AD9747 | X1 | 73 | X3 | 28 | B35_L12_P | B35_L12_P | U2 AD9747 | P1D14 | 10 | 直接同网
AD9747 | X1 | 75 | X3 | 26 | B35_L12_N | B35_L12_N | U2 AD9747 | P1D15 | 9 | 直接同网
AD9747 | X1 | 78 | X3 | 23 | B35_L18_N | B35_L18_N | U2 AD9747 | P2D10 | 36 | 直接同网
AD9747 | X1 | 80 | X3 | 21 | B35_L18_P | B35_L18_P | U2 AD9747 | P2D11 | 35 | 直接同网
AD9747 | X1 | 82 | X3 | 19 | B35_L10_N | B35_L10_N | U2 AD9747 | P2D12 | 34 | 直接同网
AD9747 | X1 | 84 | X3 | 17 | B35_L10_P | B35_L10_P | U2 AD9747 | P2D13 | 33 | 直接同网
AD9747 | X1 | 86 | X3 | 15 | B35_L17_N | B35_L17_N | U2 AD9747 | P2D14 | 32 | 直接同网
AD9747 | X1 | 88 | X3 | 13 | B35_L17_P | B35_L17_P | U2 AD9747 | P2D15 | 31 | 直接同网
AD9516-3 | X1 | 5 | X3 | 96 | PS_MIO9 | PS_MIO9 | U3 AD9516-3 | SDO | 21 | 直接同网 | SPI控制 | GPIO软件模拟输入
AD9516-3 | X1 | 6 | X3 | 95 | PS_MIO8 | PS_MIO8 | U3 AD9516-3 | SDIO# | 22 | 直接同网 | SPI控制 | GPIO软件模拟输出
AD9516-3 | X1 | 8 | X3 | 93 | PS_MIO13 | CS | U3 AD9516-3 | CS# | 17 | 直接同网 |  | GPIO软件模拟输出
AD9516-3 | X1 | 9 | X3 | 92 | PS_MIO7 | PS_MIO7 | U3 AD9516-3 | SCLK | 16 | 直接同网 | SPI控制 | GPIO软件模拟输出
AD9516-3 | X1 | 62 | X3 | 39 | B35_L8_P | B35_L8_P | U3 AD9516-3 | RESET# | 23 | 直接同网
AD9516-3 | X1 | 64 | X3 | 37 | B35_L8_N | B35_L8_N | U3 AD9516-3 | SYNC | 8 | 直接同网
AD9516-3 | X1 | 66 | X3 | 35 | B35_L9_N | B35_L9_N | U3 AD9516-3 | REFMON | 2 | 直接同网
AD9516-3 | X1 | 68 | X3 | 33 | B35_L9_P | B35_L9_P | U3 AD9516-3 | STATUS | 6 | 直接同网
AD9516-3 | X2 | 23 | X4 | 78 | B13_L17_N | B13_L17_P | U3 AD9516-3 | LD | 3 | 直接同网
ADC输出使能 | X1 | 31 | X3 | 70 | OTG_DATA0 | ADC_DATA_OE_N | U33；U33；U36；U36 | 2OE#；1OE#；2OE#；1OE# | 25；48；25；48 | 直接同网 | 1.8 V控制，低有效
ADC输出使能 | X1 | 33 | X3 | 68 | OTG_DATA1 | ADC_CTRL_OE_N | U39 | OE# | 9 | 直接同网 | 1.8 V控制，低有效

Sheet: 显示串口网口JTAG
功能组 | 底板连接器 | 底板触点 | 核心板连接器 | 核心板触点 | 核心板网络 | 当前原理图网络 | 对应器件 | 器件信号 | 器件引脚 | 中间器件／路径 | 说明 | PS控制方式
JTAG | X1 | 1 | X3 | 100 | FPGA_TMS | FPGATMS | CN3 JTAG端子 | FPGATMS |  | X1.1 -> R116.2 -> CN3.4 | 串联电阻连接
JTAG | X1 | 2 | X3 | 99 | FPGA_TCK | FPGATCK | CN3 JTAG端子 | FPGATCK |  | X1.2 -> R117.2 -> CN3.6 | 串联电阻连接
JTAG | X1 | 3 | X3 | 98 | FPGA_TDI | FPGATDI | CN3 JTAG端子 | FPGATDI |  | X1.3 -> R119.2 -> CN3.10 | 串联电阻连接
JTAG | X1 | 4 | X3 | 97 | FPGA_TDO | FPGATDO | CN3 JTAG端子 | FPGATDO |  | X1.4 -> R118.2 -> CN3.8 | 串联电阻连接
CH340X | X1 | 12 | X3 | 89 | UART_RXD | UART1RXD PS_MIO14 | U8 CH340X | TXD | 8 | U6缓冲 |  | 硬件UART0_RX
CH340X | X1 | 14 | X3 | 87 | UART_TXD | UART1TXD PS_MIO15 | U8 CH340X | RXD | 9 | U29缓冲 |  | 硬件UART0_TX
LCD与触摸 | X1 | 51 | X3 | 50 | B35_L11_N | B35_L11_N LCD_RST | FPC1 LCD与触摸 | 40 | 40 | 直接同网
LCD与触摸 | X1 | 70 | X3 | 31 | B35_L7_P | B35_L7_P T_CS | FPC1 LCD与触摸 | 35 | 35 | 直接同网
LCD与触摸 | X1 | 72 | X3 | 29 | B35_L7_N | B35_L7_N LCD_BL | FPC1 LCD与触摸 | 34 | 34 | 直接同网
LCD与触摸 | X2 | 55 | X4 | 46 | B34_L5_P | B34_L5_P LCD_R2 | FPC1 LCD与触摸 | 5 | 5 | 直接同网
LCD与触摸 | X2 | 56 | X4 | 45 | B34_L18_P | B34_L18_P LCD_R0 | FPC1 LCD与触摸 | 4 | 4 | 直接同网
LCD与触摸 | X2 | 57 | X4 | 44 | B34_L5_N | B34_L5_N LCD_R3 | FPC1 LCD与触摸 | 6 | 6 | 直接同网
LCD与触摸 | X2 | 58 | X4 | 43 | B34_L18_N | B34_L18_N LCD_R1 | FPC1 LCD与触摸 | 3 | 3 | 直接同网
LCD与触摸 | X2 | 59 | X4 | 42 | B34_L9_P | B34_L9_P LCD_R6 | FPC1 LCD与触摸 | 9 | 9 | 直接同网
LCD与触摸 | X2 | 61 | X4 | 40 | B34_L9_N | B34_L9_N LCD_R7 | FPC1 LCD与触摸 | 10 | 10 | 直接同网
LCD与触摸 | X2 | 62 | X4 | 39 | B34_L7_N | B34_L7_N LCD_R4 | FPC1 LCD与触摸 | 8 | 8 | 直接同网
LCD与触摸 | X2 | 63 | X4 | 38 | B34_L20_P | B34_L20_P LCD_G2 | FPC1 LCD与触摸 | 14 | 14 | 直接同网
LCD与触摸 | X2 | 64 | X4 | 37 | B34_L7_P | B34_L7_P LCD_R5 | FPC1 LCD与触摸 | 7 | 7 | 直接同网
LCD与触摸 | X2 | 65 | X4 | 36 | B34_L20_N | B34_L20_N LCD_G3 | FPC1 LCD与触摸 | 15 | 15 | 直接同网
LCD与触摸 | X2 | 66 | X4 | 35 | B34_L21_P | B34_L21_P LCD_G0 | FPC1 LCD与触摸 | 13 | 13 | 直接同网
LCD与触摸 | X2 | 68 | X4 | 33 | B34_L21_N | B34_L21_N LCD_G1 | FPC1 LCD与触摸 | 12 | 12 | 直接同网
LCD与触摸 | X2 | 69 | X4 | 32 | B34_L24_P | B34_L24_P LCD_G6 | FPC1 LCD与触摸 | 18 | 18 | 直接同网
LCD与触摸 | X2 | 70 | X4 | 31 | B34_L17_P | B34_L17_P LCD_G4 | FPC1 LCD与触摸 | 17 | 17 | 直接同网
LCD与触摸 | X2 | 71 | X4 | 30 | B34_L24_N | B34_L24_N LCD_G7 | FPC1 LCD与触摸 | 19 | 19 | 直接同网
LCD与触摸 | X2 | 72 | X4 | 29 | B34_L17_N | B34_L17_N LCD_G5 | FPC1 LCD与触摸 | 16 | 16 | 直接同网
LCD与触摸 | X2 | 73 | X4 | 28 | B34_L19_P | B34_L19_P LCD_B2 | FPC1 LCD与触摸 | 23 | 23 | 直接同网
LCD与触摸 | X2 | 74 | X4 | 27 | B34_L22_P | B34_L22_P LCD_B0 | FPC1 LCD与触摸 | 22 | 22 | 直接同网
LCD与触摸 | X2 | 75 | X4 | 26 | B34_L19_N | B34_L19_N LCD_B3 | FPC1 LCD与触摸 | 24 | 24 | 直接同网
LCD与触摸 | X2 | 76 | X4 | 25 | B34_L22_N | B34_L22_N LCD_B1 | FPC1 LCD与触摸 | 21 | 21 | 直接同网
LCD与触摸 | X2 | 77 | X4 | 24 | B34_IO0 | B34_IO0 II2C_SCL | FPC1 LCD与触摸 | 38 | 38 | 直接同网
LCD与触摸 | X2 | 78 | X4 | 23 | B34_L16_N | B34_L16_N LCD_B4 | FPC1 LCD与触摸 | 26 | 26 | 直接同网
LCD与触摸 | X2 | 79 | X4 | 22 | B34_L23_N | B34_L23_N LCD_B6 | FPC1 LCD与触摸 | 27 | 27 | 直接同网
LCD与触摸 | X2 | 80 | X4 | 21 | B34_L16_P | B34_L16_P LCD_B5 | FPC1 LCD与触摸 | 25 | 25 | 直接同网
LCD与触摸 | X2 | 81 | X4 | 20 | B34_L23_P | B34_L23_P LCD_B7 | FPC1 LCD与触摸 | 28 | 28 | 直接同网
LCD与触摸 | X2 | 83 | X4 | 18 | B34_L13_N | B34_L13_N LCD_CLK | FPC1 LCD与触摸 | 30 | 30 | 直接同网
LCD与触摸 | X2 | 84 | X4 | 17 | B34_L12_N | B34_L12_N T_PEN | FPC1 LCD与触摸 | 39 | 39 | 直接同网
LCD与触摸 | X2 | 85 | X4 | 16 | B34_L13_P | B34_L13_P LCD_HSYNC | FPC1 LCD与触摸 | 31 | 31 | 直接同网
LCD与触摸 | X2 | 87 | X4 | 14 | B34_L14_N | B34_L14_N II2C_SDA | FPC1 LCD与触摸 | 36 | 36 | 直接同网
LCD与触摸 | X2 | 88 | X4 | 13 | B34_L15_P | B34_L15_P LCD_VSYNC | FPC1 LCD与触摸 | 32 | 32 | 直接同网
LCD与触摸 | X2 | 89 | X4 | 12 | B34_L14_P | B34_L14_P T_MISO | FPC1 LCD与触摸 | 37 | 37 | 直接同网
LCD与触摸 | X2 | 90 | X4 | 11 | B34_L15_N | B34_L15_N LCD_DE | FPC1 LCD与触摸 | 33 | 33 | 直接同网
千兆以太网 | X1 | 91 | X3 | 10 | PHY_MDI3_N | PHY1MDI3N | RJ1 千兆网口 | PHY1MDI3N |  | RJ1.P9 <-> PHY_MDI3_N | 核心板PHY至RJ1
千兆以太网 | X1 | 92 | X3 | 9 | PHY_MDI1_N | PHY1MDI1N | RJ1 千兆网口 | PHY1MDI1N |  | RJ1.P7 <-> PHY_MDI1_N | 核心板PHY至RJ1
千兆以太网 | X1 | 93 | X3 | 8 | PHY_MDI3_P | PHY1MDI3P | RJ1 千兆网口 | PHY1MDI3P |  | RJ1.P8 <-> PHY_MDI3_P | 核心板PHY至RJ1
千兆以太网 | X1 | 94 | X3 | 7 | PHY_MDI1_P | PHY1MDI1P | RJ1 千兆网口 | PHY1MDI1P |  | RJ1.P4 <-> PHY_MDI1_P | 核心板PHY至RJ1
千兆以太网 | X1 | 95 | X3 | 6 | PHY_MDI2_N | PHY1MDI2N | RJ1 千兆网口 | PHY1MDI2N |  | RJ1.P6 <-> PHY_MDI2_N | 核心板PHY至RJ1
千兆以太网 | X1 | 96 | X3 | 5 | PHY_MDI0_N | PHY1MDI0N | RJ1 千兆网口 | PHY1MDI0N |  | RJ1.P3 <-> PHY_MDI0_N | 核心板PHY至RJ1
千兆以太网 | X1 | 97 | X3 | 4 | PHY_MDI2_P | PHY1MDI2P | RJ1 千兆网口 | PHY1MDI2P |  | RJ1.P5 <-> PHY_MDI2_P | 核心板PHY至RJ1
千兆以太网 | X1 | 98 | X3 | 3 | PHY_MDI0_P | PHY1MDI0P | RJ1 千兆网口 | PHY1MDI0P |  | RJ1.P2 <-> PHY_MDI0_P | 核心板PHY至RJ1
扩展接口 | X1 | 48 | X3 | 53 | B35_L24_P | B35_L24_P | U18 扩展接口 | 14 | 14 | R41(100)
扩展接口 | X1 | 77 | X3 | 24 | B35_L1_N | B35_L1_N | U18 扩展接口 | 12 | 12 | R35(100)
扩展接口 | X1 | 79 | X3 | 22 | B35_L1_P | B35_L1_P | U18 扩展接口 | 10 | 10 | R36(100)
扩展接口 | X1 | 81 | X3 | 20 | B35_L4_P | B35_L4_P | U18 扩展接口 | 8 | 8 | R37(100)
扩展接口 | X1 | 83 | X3 | 18 | B35_L4_N | B35_L4_N | U18 扩展接口 | 6 | 6 | R38(100)
扩展接口 | X1 | 85 | X3 | 16 | B35_L15_P | B35_L15_P | U18 扩展接口 | 4 | 4 | R39(100)
扩展接口 | X1 | 87 | X3 | 14 | B35_L15_N | B35_L15_N | U18 扩展接口 | 2 | 2 | R40(100)
网口LED/PHY配置 | X1 | 99 | X3 | 2 | PHY_AD1/LED1 | PHY1AD1/LED1 | RJ1 | PHY1AD1/LED1 |  | X1.99 -> R111(510Ω) -> RJ1.P12 | 网口LED/PHY配置
网口LED/PHY配置 | X1 | 100 | X3 | 1 | PHY_AD0/LED0 | PHY1AD0/LED0 | RJ1 | PHY1AD0/LED0 |  | X1.100 -> R112(510Ω) -> RJ1.P13 | 网口LED/PHY配置

Sheet: PS复用判断
功能/接口 | MIO | 核心板/底板触点 | 当前网络/器件信号 | UG585硬件复用可能 | 本工程采用方式 | 判断说明
AD9747/AD9516 SPI时钟 | MIO7 | X3-92 / X1-9 | PS_MIO7；U2/U3 SCLK | 不属于SPI硬件复用组；MIO7仅输出 | GPIO软件模拟输出 | MIO7仅输出。
SPI MOSI（PS输出） | MIO8 | X3-95 / X1-6 | PS_MIO8；U2 SDIO、U3 SDIO | 不属于SPI硬件复用组；MIO8仅输出 | GPIO软件模拟输出 | MIO8仅输出；读回使用MIO9。
SPI MISO（PS输入） | MIO9 | X3-96 / X1-5 | PS_MIO9；U2/U3 SDO | 不属于SPI硬件复用组 | GPIO软件模拟输入 | 共用SDO读回。
AD9747 CSB | MIO10 | X3-91 / X1-10 | CSBD；U2 CSB | SPI1 MOSI可用MIO10，但该网当前接CSB | GPIO软件模拟输出 | 按当前连接作为GPIO输出。
AD9747 RESET | MIO11 | X3-94 / X1-7 | D_RESET；U2 RESET | SPI1 MISO可用MIO11，但该网当前接RESET | GPIO软件模拟输出 | 按当前连接作为GPIO输出。
AD9747 IQSEL | MIO12 | X3-90 / X1-11 | IQSEL；U2 IQSEL | SPI1 SCLK可用MIO12，但该网当前接IQSEL | GPIO软件模拟输出 | 按当前连接作为GPIO输出。
AD9516-3 CS# | MIO13 | X3-93 / X1-8 | CS；U3 CS# | SPI1 SS0可用MIO13，但SPI1其余信号不在对应组 | GPIO软件模拟输出 | 按当前连接作为GPIO输出。
CH340X串口 RX | MIO14 | X3-89 / X1-12 | UART1RXD；经U6连CH340X TXD | 可直接复用PS UART0_RX | 硬件外设复用：UART0_RX | 当前网名保留；软件配置为UART0。
CH340X串口 TX | MIO15 | X3-87 / X1-14 | UART1TXD；经U29连CH340X RXD | 可直接复用PS UART0_TX | 硬件外设复用：UART0_TX | 当前网名保留；软件配置为UART0。

Sheet: 器件端完整网络
位号 | 型号 | 器件引脚 | 器件信号 | 实际网络 | 对应底板触点 | 图页
U1 | AD9268BCPZ-125 | 1 | CLK+ | CLKPP |  | ADDA
U1 | AD9268BCPZ-125 | 2 | CLK– | CLKNN |  | ADDA
U1 | AD9268BCPZ-125 | 3 | SYNC | GND | X1.24；X1.25；X1.38；X1.39；X1.89；X1.90；X2.1；X2.2；X2.3；X2.4；X2.5；X2.6；X2.7；X2.8；X2.31；X2.42；X2.49；X2.60；X2.67；X2.82 | ADDA
U1 | AD9268BCPZ-125 | 4 | D0B(LSB) | D0B(LSB) | X2-21 | ADDA
U1 | AD9268BCPZ-125 | 5 | D1B | D1B | X2-54 | ADDA
U1 | AD9268BCPZ-125 | 6 | D2B | D2B | X2-53 | ADDA
U1 | AD9268BCPZ-125 | 7 | D3B | D3B | X2-52 | ADDA
U1 | AD9268BCPZ-125 | 8 | D4B | D4B | X2-50 | ADDA
U1 | AD9268BCPZ-125 | 9 | D5B | D5B | X2-48 | ADDA
U1 | AD9268BCPZ-125 | 10 | DRVDD | A-DVDD1.8V |  | ADDA
U1 | AD9268BCPZ-125 | 11 | D6B | D6B | X2-47 | ADDA
U1 | AD9268BCPZ-125 | 12 | D7B | D7B | X2-46 | ADDA
U1 | AD9268BCPZ-125 | 13 | D8B | D8B | X2-45 | ADDA
U1 | AD9268BCPZ-125 | 14 | D9B | D9B | X2-44 | ADDA
U1 | AD9268BCPZ-125 | 15 | D10B | D10B | X2-43 | ADDA
U1 | AD9268BCPZ-125 | 16 | D11B | D11B | X2-41 | ADDA
U1 | AD9268BCPZ-125 | 17 | D12B | D12B | X2-39 | ADDA
U1 | AD9268BCPZ-125 | 18 | D13B | D13B | X2-37 | ADDA
U1 | AD9268BCPZ-125 | 19 | DRVDD | A-DVDD1.8V |  | ADDA
U1 | AD9268BCPZ-125 | 20 | D14B | D14B | X2-35 | ADDA
U1 | AD9268BCPZ-125 | 21 | D15B(MSB) | D15B | X2-33 | ADDA
U1 | AD9268BCPZ-125 | 22 | ORB | ORB | X2-25 | ADDA
U1 | AD9268BCPZ-125 | 23 | DCOB | DCOB | X2-51 | ADDA
U1 | AD9268BCPZ-125 | 24 | DCOA | DCOA | X2-29 | ADDA
U1 | AD9268BCPZ-125 | 25 | D0A(LSB) | D0A(LSB) | X2-40 | ADDA
U1 | AD9268BCPZ-125 | 26 | D1A | D1A | X2-38 | ADDA
U1 | AD9268BCPZ-125 | 27 | D2A | D2A | X2-36 | ADDA
U1 | AD9268BCPZ-125 | 28 | DRVDD | A-DVDD1.8V |  | ADDA
U1 | AD9268BCPZ-125 | 29 | D3A | D3A | X2-34 | ADDA
U1 | AD9268BCPZ-125 | 30 | D4A | D4A | X2-32 | ADDA
U1 | AD9268BCPZ-125 | 31 | D5A | D5A | X2-30 | ADDA
U1 | AD9268BCPZ-125 | 32 | D6A | D6A | X2-28 | ADDA
U1 | AD9268BCPZ-125 | 33 | D7A | D7A | X2-26 | ADDA
U1 | AD9268BCPZ-125 | 34 | D8A | D8A | X2-24 | ADDA
U1 | AD9268BCPZ-125 | 35 | D9A | D9A | X2-22 | ADDA
U1 | AD9268BCPZ-125 | 36 | D10A | D10A | X2-20 | ADDA
U1 | AD9268BCPZ-125 | 37 | DRVDD | A-DVDD1.8V |  | ADDA
U1 | AD9268BCPZ-125 | 38 | D11A | D11A | X2-18 | ADDA
U1 | AD9268BCPZ-125 | 39 | D12A | D12A | X2-17 | ADDA
U1 | AD9268BCPZ-125 | 40 | D13A | D13A | X2-16 | ADDA
U1 | AD9268BCPZ-125 | 41 | D14A | D14A | X2-13 | ADDA
U1 | AD9268BCPZ-125 | 42 | D15A(MSB) | D15A | X2-14 | ADDA
U1 | AD9268BCPZ-125 | 43 | ORA | ORA | X2-27 | ADDA
U1 | AD9268BCPZ-125 | 44 | SDIO/DCS | A_SDIO/DCS | X1.32 | ADDA
U1 | AD9268BCPZ-125 | 45 | SCLK/DFS | A_SCLK/DFS | X1.34 | ADDA
U1 | AD9268BCPZ-125 | 46 | CSB | A_CSBA | X1.36 | ADDA
U1 | AD9268BCPZ-125 | 47 | OEB | GND | X1.24；X1.25；X1.38；X1.39；X1.89；X1.90；X2.1；X2.2；X2.3；X2.4；X2.5；X2.6；X2.7；X2.8；X2.31；X2.42；X2.49；X2.60；X2.67；X2.82 | ADDA
U1 | AD9268BCPZ-125 | 48 | PDWN | PDWN |  | ADDA
U1 | AD9268BCPZ-125 | 49 | AVDD | A-AVDD1.8V |  | ADDA
U1 | AD9268BCPZ-125 | 50 | AVDD | A-AVDD1.8V |  | ADDA
U1 | AD9268BCPZ-125 | 51 | VIN+A | A2VIN1+ |  | ADDA
U1 | AD9268BCPZ-125 | 52 | VIN–A | A2VIN2+ |  | ADDA
U1 | AD9268BCPZ-125 | 53 | AVDD | A-AVDD1.8V |  | ADDA
U1 | AD9268BCPZ-125 | 54 | AVDD | A-AVDD1.8V |  | ADDA
U1 | AD9268BCPZ-125 | 55 | VREF | VREF |  | ADDA
U1 | AD9268BCPZ-125 | 56 | SENSE | GND | X1.24；X1.25；X1.38；X1.39；X1.89；X1.90；X2.1；X2.2；X2.3；X2.4；X2.5；X2.6；X2.7；X2.8；X2.31；X2.42；X2.49；X2.60；X2.67；X2.82 | ADDA
U1 | AD9268BCPZ-125 | 57 | VCM | VCM |  | ADDA
U1 | AD9268BCPZ-125 | 58 | RBIAS | RBIAS |  | ADDA
U1 | AD9268BCPZ-125 | 59 | AVDD | A-AVDD1.8V |  | ADDA
U1 | AD9268BCPZ-125 | 60 | AVDD | A-AVDD1.8V |  | ADDA
U1 | AD9268BCPZ-125 | 61 | VIN–B | A1VIN2+ |  | ADDA
U1 | AD9268BCPZ-125 | 62 | VIN+B | A1VIN1+ |  | ADDA
U1 | AD9268BCPZ-125 | 63 | AVDD | A-AVDD1.8V |  | ADDA
U1 | AD9268BCPZ-125 | 64 | AVDD | A-AVDD1.8V |  | ADDA
U1 | AD9268BCPZ-125 | 65 | EP | GND | X1.24；X1.25；X1.38；X1.39；X1.89；X1.90；X2.1；X2.2；X2.3；X2.4；X2.5；X2.6；X2.7；X2.8；X2.31；X2.42；X2.49；X2.60；X2.67；X2.82 | ADDA
U2 | AD9747BCPZRL | 1 | CVDD18 | D-CVDD1.8V |  | ADDA
U2 | AD9747BCPZRL | 2 | CVSS | GND | X1.24；X1.25；X1.38；X1.39；X1.89；X1.90；X2.1；X2.2；X2.3；X2.4；X2.5；X2.6；X2.7；X2.8；X2.31；X2.42；X2.49；X2.60；X2.67；X2.82 | ADDA
U2 | AD9747BCPZRL | 3 | CLKP | CLKP |  | ADDA
U2 | AD9747BCPZRL | 4 | CLKN | CLKN |  | ADDA
U2 | AD9747BCPZRL | 5 | CVSS | GND | X1.24；X1.25；X1.38；X1.39；X1.89；X1.90；X2.1；X2.2；X2.3；X2.4；X2.5；X2.6；X2.7；X2.8；X2.31；X2.42；X2.49；X2.60；X2.67；X2.82 | ADDA
U2 | AD9747BCPZRL | 6 | CVDD18 | D-CVDD1.8V |  | ADDA
U2 | AD9747BCPZRL | 7 | DVSS | GND | X1.24；X1.25；X1.38；X1.39；X1.89；X1.90；X2.1；X2.2；X2.3；X2.4；X2.5；X2.6；X2.7；X2.8；X2.31；X2.42；X2.49；X2.60；X2.67；X2.82 | ADDA
U2 | AD9747BCPZRL | 8 | DVDD18 | D-DVDD1.8V |  | ADDA
U2 | AD9747BCPZRL | 9 | P1D15 | B35_L12_N | X1.75 | ADDA
U2 | AD9747BCPZRL | 10 | P1D14 | B35_L12_P | X1.73 | ADDA
U2 | AD9747BCPZRL | 11 | P1D13 | B35_L3_N | X1.71 | ADDA
U2 | AD9747BCPZRL | 12 | P1D12 | B35_L3_P | X1.69 | ADDA
U2 | AD9747BCPZRL | 13 | P1D11 | B35_L2_P | X1.67 | ADDA
U2 | AD9747BCPZRL | 14 | P1D10 | B35_L2_N | X1.65 | ADDA
U2 | AD9747BCPZRL | 15 | P1D9 | B35_L13_N | X1.63 | ADDA
U2 | AD9747BCPZRL | 16 | P1D8 | B35_L13_P | X1.61 | ADDA
U2 | AD9747BCPZRL | 17 | P1D7 | B35_L19_N | X1.59 | ADDA
U2 | AD9747BCPZRL | 18 | P1D6 | B35_L19_P | X1.57 | ADDA
U2 | AD9747BCPZRL | 19 | P1D5 | B35_IO0 | X1.55 | ADDA
U2 | AD9747BCPZRL | 20 | P1D4 | B35_IO25 | X1.53 | ADDA
U2 | AD9747BCPZRL | 21 | P1D3 | B35_L20_N | X1.47 | ADDA
U2 | AD9747BCPZRL | 22 | P1D2 | B35_L20_P | X1.45 | ADDA
U2 | AD9747BCPZRL | 23 | P1D1 | B35_L23_N | X1.43 | ADDA
U2 | AD9747BCPZRL | 24 | P1D0 | B35_L23_P | X1.41 | ADDA
U2 | AD9747BCPZRL | 25 | DCO | B35_L11_P | X1.49 | ADDA
U2 | AD9747BCPZRL | 26 | DNC | 未命名／未连接 |  | ADDA
U2 | AD9747BCPZRL | 27 | DVDD33 | D-DVDD3.3V |  | ADDA
U2 | AD9747BCPZRL | 28 | DVSS | GND | X1.24；X1.25；X1.38；X1.39；X1.89；X1.90；X2.1；X2.2；X2.3；X2.4；X2.5；X2.6；X2.7；X2.8；X2.31；X2.42；X2.49；X2.60；X2.67；X2.82 | ADDA
U2 | AD9747BCPZRL | 29 | IQSEL | IQSEL | X1.11 | ADDA
U2 | AD9747BCPZRL | 30 | DNC | 未命名／未连接 |  | ADDA
U2 | AD9747BCPZRL | 31 | P2D15 | B35_L17_P | X1.88 | ADDA
U2 | AD9747BCPZRL | 32 | P2D14 | B35_L17_N | X1.86 | ADDA
U2 | AD9747BCPZRL | 33 | P2D13 | B35_L10_P | X1.84 | ADDA
U2 | AD9747BCPZRL | 34 | P2D12 | B35_L10_N | X1.82 | ADDA
U2 | AD9747BCPZRL | 35 | P2D11 | B35_L18_P | X1.80 | ADDA
U2 | AD9747BCPZRL | 36 | P2D10 | B35_L18_N | X1.78 | ADDA
U2 | AD9747BCPZRL | 37 | P2D9 | B35_L16_N | X1.60 | ADDA
U2 | AD9747BCPZRL | 38 | P2D8 | B35_L16_P | X1.58 | ADDA
U2 | AD9747BCPZRL | 39 | P2D7 | B35_L5_N | X1.56 | ADDA
U2 | AD9747BCPZRL | 40 | P2D6 | B35_L5_P | X1.54 | ADDA
U2 | AD9747BCPZRL | 41 | P2D5 | B35_L6_N | X1.52 | ADDA
U2 | AD9747BCPZRL | 42 | P2D4 | B35_L6_P | X1.50 | ADDA
U2 | AD9747BCPZRL | 43 | P2D3 | B35_L22_N | X1.46 | ADDA
U2 | AD9747BCPZRL | 44 | P2D2 | B35_L22_P | X1.44 | ADDA
U2 | AD9747BCPZRL | 45 | P2D1 | B35_L21_N | X1.42 | ADDA
U2 | AD9747BCPZRL | 46 | P2D0 | B35_L21_P | X1.40 | ADDA
U2 | AD9747BCPZRL | 47 | DVDD18 | D-DVDD1.8V |  | ADDA
U2 | AD9747BCPZRL | 48 | DVSS | GND | X1.24；X1.25；X1.38；X1.39；X1.89；X1.90；X2.1；X2.2；X2.3；X2.4；X2.5；X2.6；X2.7；X2.8；X2.31；X2.42；X2.49；X2.60；X2.67；X2.82 | ADDA
U2 | AD9747BCPZRL | 49 | SDO | PS_MIO9 | X1.5 | ADDA
U2 | AD9747BCPZRL | 50 | SDIO | PS_MIO8 | X1.6 | ADDA
U2 | AD9747BCPZRL | 51 | SCLK | PS_MIO7 | X1.9 | ADDA
U2 | AD9747BCPZRL | 52 | CSB | CSBD | X1.10 | ADDA
U2 | AD9747BCPZRL | 53 | RESET | D_RESET | X1.7 | ADDA
U2 | AD9747BCPZRL | 54 | FSADJ | FSADJ |  | ADDA
U2 | AD9747BCPZRL | 55 | REFIO | REFIO |  | ADDA
U2 | AD9747BCPZRL | 56 | AVDD33 | D-AVDD3.3V |  | ADDA
U2 | AD9747BCPZRL | 57 | AVDD33 | D-AVDD3.3V |  | ADDA
U2 | AD9747BCPZRL | 58 | AVSS | GND | X1.24；X1.25；X1.38；X1.39；X1.89；X1.90；X2.1；X2.2；X2.3；X2.4；X2.5；X2.6；X2.7；X2.8；X2.31；X2.42；X2.49；X2.60；X2.67；X2.82 | ADDA
U2 | AD9747BCPZRL | 59 | 1OUT2P | IOUT2P |  | ADDA
U2 | AD9747BCPZRL | 60 | 1OUT2N | IOUT2N |  | ADDA
U2 | AD9747BCPZRL | 61 | AVSS | GND | X1.24；X1.25；X1.38；X1.39；X1.89；X1.90；X2.1；X2.2；X2.3；X2.4；X2.5；X2.6；X2.7；X2.8；X2.31；X2.42；X2.49；X2.60；X2.67；X2.82 | ADDA
U2 | AD9747BCPZRL | 62 | AUX2P | 未命名／未连接 |  | ADDA
U2 | AD9747BCPZRL | 63 | AUX2N | 未命名／未连接 |  | ADDA
U2 | AD9747BCPZRL | 64 | AVSS | GND | X1.24；X1.25；X1.38；X1.39；X1.89；X1.90；X2.1；X2.2；X2.3；X2.4；X2.5；X2.6；X2.7；X2.8；X2.31；X2.42；X2.49；X2.60；X2.67；X2.82 | ADDA
U2 | AD9747BCPZRL | 65 | AUX1N | 未命名／未连接 |  | ADDA
U2 | AD9747BCPZRL | 66 | AUX1P | 未命名／未连接 |  | ADDA
U2 | AD9747BCPZRL | 67 | AVSS | GND | X1.24；X1.25；X1.38；X1.39；X1.89；X1.90；X2.1；X2.2；X2.3；X2.4；X2.5；X2.6；X2.7；X2.8；X2.31；X2.42；X2.49；X2.60；X2.67；X2.82 | ADDA
U2 | AD9747BCPZRL | 68 | IOUT1N | IOUT1N |  | ADDA
U2 | AD9747BCPZRL | 69 | 1OUT1P | IOUT1P |  | ADDA
U2 | AD9747BCPZRL | 70 | AVSS | GND | X1.24；X1.25；X1.38；X1.39；X1.89；X1.90；X2.1；X2.2；X2.3；X2.4；X2.5；X2.6；X2.7；X2.8；X2.31；X2.42；X2.49；X2.60；X2.67；X2.82 | ADDA
U2 | AD9747BCPZRL | 71 | AVDD33 | D-AVDD3.3V |  | ADDA
U2 | AD9747BCPZRL | 72 | AVDD33 | D-AVDD3.3V |  | ADDA
U2 | AD9747BCPZRL | 73 | PAD | GND | X1.24；X1.25；X1.38；X1.39；X1.89；X1.90；X2.1；X2.2；X2.3；X2.4；X2.5；X2.6；X2.7；X2.8；X2.31；X2.42；X2.49；X2.60；X2.67；X2.82 | ADDA
U3 | AD9516-3BCPZ-REEL7 | 1 | VS | DCLK3.3V |  | CLIK
U3 | AD9516-3BCPZ-REEL7 | 2 | REFMON | B35_L9_N | X1.66 | CLIK
U3 | AD9516-3BCPZ-REEL7 | 3 | LD | B13_L17_P | X2.23 | CLIK
U3 | AD9516-3BCPZ-REEL7 | 4 | VCP | DCLK3.3V |  | CLIK
U3 | AD9516-3BCPZ-REEL7 | 5 | CP | $C106_2 |  | CLIK
U3 | AD9516-3BCPZ-REEL7 | 6 | STATUS | B35_L9_P | X1.68 | CLIK
U3 | AD9516-3BCPZ-REEL7 | 7 | REF_SEL | 未命名／未连接 |  | CLIK
U3 | AD9516-3BCPZ-REEL7 | 8 | SYNC | B35_L8_N | X1.64 | CLIK
U3 | AD9516-3BCPZ-REEL7 | 9 | LF | $C106_2 |  | CLIK
U3 | AD9516-3BCPZ-REEL7 | 10 | BYPASS | $C109_2 |  | CLIK
U3 | AD9516-3BCPZ-REEL7 | 11 | VS | DCLK3.3V |  | CLIK
U3 | AD9516-3BCPZ-REEL7 | 12 | VS | DCLK3.3V |  | CLIK
U3 | AD9516-3BCPZ-REEL7 | 13 | CLK | $R4_2 |  | CLIK
U3 | AD9516-3BCPZ-REEL7 | 14 | CLK# | $C110_2 |  | CLIK
U3 | AD9516-3BCPZ-REEL7 | 15 | NC | 未命名／未连接 |  | CLIK
U3 | AD9516-3BCPZ-REEL7 | 16 | SCLK | PS_MIO7 | X1.9 | CLIK
U3 | AD9516-3BCPZ-REEL7 | 17 | CS# | CS | X1.8 | CLIK
U3 | AD9516-3BCPZ-REEL7 | 18 | NC | 未命名／未连接 |  | CLIK
U3 | AD9516-3BCPZ-REEL7 | 19 | NC | 未命名／未连接 |  | CLIK
U3 | AD9516-3BCPZ-REEL7 | 20 | NC | 未命名／未连接 |  | CLIK
U3 | AD9516-3BCPZ-REEL7 | 21 | SDO | PS_MIO9 | X1.5 | CLIK
U3 | AD9516-3BCPZ-REEL7 | 22 | SDIO# | PS_MIO8 | X1.6 | CLIK
U3 | AD9516-3BCPZ-REEL7 | 23 | RESET# | B35_L8_P | X1.62 | CLIK
U3 | AD9516-3BCPZ-REEL7 | 24 | PD# | 未命名／未连接 |  | CLIK
U3 | AD9516-3BCPZ-REEL7 | 25 | OUT4 | 未命名／未连接 |  | CLIK
U3 | AD9516-3BCPZ-REEL7 | 26 | OUT4# | 未命名／未连接 |  | CLIK
U3 | AD9516-3BCPZ-REEL7 | 27 | VS_LVPECL | DCLK3.3V |  | CLIK
U3 | AD9516-3BCPZ-REEL7 | 28 | OUT5 | 未命名／未连接 |  | CLIK
U3 | AD9516-3BCPZ-REEL7 | 29 | OUT5# | 未命名／未连接 |  | CLIK
U3 | AD9516-3BCPZ-REEL7 | 30 | VS | DCLK3.3V |  | CLIK
U3 | AD9516-3BCPZ-REEL7 | 31 | VS | DCLK3.3V |  | CLIK
U3 | AD9516-3BCPZ-REEL7 | 32 | VS | DCLK3.3V |  | CLIK
U3 | AD9516-3BCPZ-REEL7 | 33 | OUT8(OUT8A) | $C7_1 |  | CLIK
U3 | AD9516-3BCPZ-REEL7 | 34 | OUT8#(OUT8B) | $C6_1 |  | CLIK
U3 | AD9516-3BCPZ-REEL7 | 35 | OUT9(OUT9A) | 未命名／未连接 |  | CLIK
U3 | AD9516-3BCPZ-REEL7 | 36 | OUT9#(OUT9B) | 未命名／未连接 |  | CLIK
U3 | AD9516-3BCPZ-REEL7 | 37 | GND | GND | X1.24；X1.25；X1.38；X1.39；X1.89；X1.90；X2.1；X2.2；X2.3；X2.4；X2.5；X2.6；X2.7；X2.8；X2.31；X2.42；X2.49；X2.60；X2.67；X2.82 | CLIK
U3 | AD9516-3BCPZ-REEL7 | 38 | VS | DCLK3.3V |  | CLIK
U3 | AD9516-3BCPZ-REEL7 | 39 | OUT3# | 未命名／未连接 |  | CLIK
U3 | AD9516-3BCPZ-REEL7 | 40 | OUT3 | 未命名／未连接 |  | CLIK
U3 | AD9516-3BCPZ-REEL7 | 41 | VS_LVPECL | DCLK3.3V |  | CLIK
U3 | AD9516-3BCPZ-REEL7 | 42 | OUT2# | 未命名／未连接 |  | CLIK
U3 | AD9516-3BCPZ-REEL7 | 43 | OUT2 | 未命名／未连接 |  | CLIK
U3 | AD9516-3BCPZ-REEL7 | 44 | GND | GND | X1.24；X1.25；X1.38；X1.39；X1.89；X1.90；X2.1；X2.2；X2.3；X2.4；X2.5；X2.6；X2.7；X2.8；X2.31；X2.42；X2.49；X2.60；X2.67；X2.82 | CLIK
U3 | AD9516-3BCPZ-REEL7 | 45 | OUT7#(OUT7B) | 未命名／未连接 |  | CLIK
U3 | AD9516-3BCPZ-REEL7 | 46 | OUT7(OUT7A) | 未命名／未连接 |  | CLIK
U3 | AD9516-3BCPZ-REEL7 | 47 | OUT6#(OUT6B) | $C5_1 |  | CLIK
U3 | AD9516-3BCPZ-REEL7 | 48 | OUT6(OUT6A) | $C4_1 |  | CLIK
U3 | AD9516-3BCPZ-REEL7 | 49 | VS | DCLK3.3V |  | CLIK
U3 | AD9516-3BCPZ-REEL7 | 50 | VS | DCLK3.3V |  | CLIK
U3 | AD9516-3BCPZ-REEL7 | 51 | VS | DCLK3.3V |  | CLIK
U3 | AD9516-3BCPZ-REEL7 | 52 | OUT1# | 未命名／未连接 |  | CLIK
U3 | AD9516-3BCPZ-REEL7 | 53 | OUT1 | 未命名／未连接 |  | CLIK
U3 | AD9516-3BCPZ-REEL7 | 54 | VS_LVPECL | DCLK3.3V |  | CLIK
U3 | AD9516-3BCPZ-REEL7 | 55 | OUT0# | 未命名／未连接 |  | CLIK
U3 | AD9516-3BCPZ-REEL7 | 56 | OUT0 | 未命名／未连接 |  | CLIK
U3 | AD9516-3BCPZ-REEL7 | 57 | VS | DCLK3.3V |  | CLIK
U3 | AD9516-3BCPZ-REEL7 | 58 | RSET | $R6_1 |  | CLIK
U3 | AD9516-3BCPZ-REEL7 | 59 | GND | GND | X1.24；X1.25；X1.38；X1.39；X1.89；X1.90；X2.1；X2.2；X2.3；X2.4；X2.5；X2.6；X2.7；X2.8；X2.31；X2.42；X2.49；X2.60；X2.67；X2.82 | CLIK
U3 | AD9516-3BCPZ-REEL7 | 60 | VS | DCLK3.3V |  | CLIK
U3 | AD9516-3BCPZ-REEL7 | 61 | VS | DCLK3.3V |  | CLIK
U3 | AD9516-3BCPZ-REEL7 | 62 | CPRSET | $R8_1 |  | CLIK
U3 | AD9516-3BCPZ-REEL7 | 63 | REFIN#(REF2) | REF2 |  | CLIK
U3 | AD9516-3BCPZ-REEL7 | 64 | REFIN(REF1) | REF1 |  | CLIK
U3 | AD9516-3BCPZ-REEL7 | 65 | PAD | GND | X1.24；X1.25；X1.38；X1.39；X1.89；X1.90；X2.1；X2.2；X2.3；X2.4；X2.5；X2.6；X2.7；X2.8；X2.31；X2.42；X2.49；X2.60；X2.67；X2.82 | CLIK
U33 | SN74AVC16T245DGGR | 1 | 1DIR | DIR |  | 电平转换
U33 | SN74AVC16T245DGGR | 2 | 1B1 | ADC_A_D0(LSB) | X2.40 | 电平转换
U33 | SN74AVC16T245DGGR | 3 | 1B2 | ADC_A_D1 | X2.38 | 电平转换
U33 | SN74AVC16T245DGGR | 4 | GND | GND | X1.24；X1.25；X1.38；X1.39；X1.89；X1.90；X2.1；X2.2；X2.3；X2.4；X2.5；X2.6；X2.7；X2.8；X2.31；X2.42；X2.49；X2.60；X2.67；X2.82 | 电平转换
U33 | SN74AVC16T245DGGR | 5 | 1B3 | ADC_A_D2 | X2.36 | 电平转换
U33 | SN74AVC16T245DGGR | 6 | 1B4 | ADC_A_D3 | X2.34 | 电平转换
U33 | SN74AVC16T245DGGR | 7 | VCCB | CH-3.3V |  | 电平转换
U33 | SN74AVC16T245DGGR | 8 | 1B5 | ADC_A_D4 | X2.32 | 电平转换
U33 | SN74AVC16T245DGGR | 9 | 1B6 | ADC_A_D5 | X2.30 | 电平转换
U33 | SN74AVC16T245DGGR | 10 | GND | GND | X1.24；X1.25；X1.38；X1.39；X1.89；X1.90；X2.1；X2.2；X2.3；X2.4；X2.5；X2.6；X2.7；X2.8；X2.31；X2.42；X2.49；X2.60；X2.67；X2.82 | 电平转换
U33 | SN74AVC16T245DGGR | 11 | 1B7 | ADC_A_D6 | X2.28 | 电平转换
U33 | SN74AVC16T245DGGR | 12 | 1B8 | ADC_A_D7 | X2.26 | 电平转换
U33 | SN74AVC16T245DGGR | 13 | 2B1 | ADC_A_D8 | X2.24 | 电平转换
U33 | SN74AVC16T245DGGR | 14 | 2B2 | ADC_A_D9 | X2.22 | 电平转换
U33 | SN74AVC16T245DGGR | 15 | GND | GND | X1.24；X1.25；X1.38；X1.39；X1.89；X1.90；X2.1；X2.2；X2.3；X2.4；X2.5；X2.6；X2.7；X2.8；X2.31；X2.42；X2.49；X2.60；X2.67；X2.82 | 电平转换
U33 | SN74AVC16T245DGGR | 16 | 2B3 | ADC_A_D10 | X2.20 | 电平转换
U33 | SN74AVC16T245DGGR | 17 | 2B4 | ADC_A_D11 | X2.18 | 电平转换
U33 | SN74AVC16T245DGGR | 18 | VCCB | CH-3.3V |  | 电平转换
U33 | SN74AVC16T245DGGR | 19 | 2B5 | ADC_A_D12 | X2.17 | 电平转换
U33 | SN74AVC16T245DGGR | 20 | 2B6 | ADC_A_D13 | X2.16 | 电平转换
U33 | SN74AVC16T245DGGR | 21 | GND | GND | X1.24；X1.25；X1.38；X1.39；X1.89；X1.90；X2.1；X2.2；X2.3；X2.4；X2.5；X2.6；X2.7；X2.8；X2.31；X2.42；X2.49；X2.60；X2.67；X2.82 | 电平转换
U33 | SN74AVC16T245DGGR | 22 | 2B7 | ADC_A_D14 | X2.13 | 电平转换
U33 | SN74AVC16T245DGGR | 23 | 2B8 | ADC_A_D15 | X2.14 | 电平转换
U33 | SN74AVC16T245DGGR | 24 | 2DIR | DIR |  | 电平转换
U33 | SN74AVC16T245DGGR | 25 | 2OE# | ADC_DATA_OE_N | X1.31 | 电平转换
U33 | SN74AVC16T245DGGR | 26 | 2A8 | D15A |  | 电平转换
U33 | SN74AVC16T245DGGR | 27 | 2A7 | D14A |  | 电平转换
U33 | SN74AVC16T245DGGR | 28 | GND | GND | X1.24；X1.25；X1.38；X1.39；X1.89；X1.90；X2.1；X2.2；X2.3；X2.4；X2.5；X2.6；X2.7；X2.8；X2.31；X2.42；X2.49；X2.60；X2.67；X2.82 | 电平转换
U33 | SN74AVC16T245DGGR | 29 | 2A6 | D13A |  | 电平转换
U33 | SN74AVC16T245DGGR | 30 | 2A5 | D12A |  | 电平转换
U33 | SN74AVC16T245DGGR | 31 | VCCA | A-DVDD1.8V |  | 电平转换
U33 | SN74AVC16T245DGGR | 32 | 2A4 | D11A |  | 电平转换
U33 | SN74AVC16T245DGGR | 33 | 2A3 | D10A |  | 电平转换
U33 | SN74AVC16T245DGGR | 34 | GND | GND | X1.24；X1.25；X1.38；X1.39；X1.89；X1.90；X2.1；X2.2；X2.3；X2.4；X2.5；X2.6；X2.7；X2.8；X2.31；X2.42；X2.49；X2.60；X2.67；X2.82 | 电平转换
U33 | SN74AVC16T245DGGR | 35 | 2A2 | D9A |  | 电平转换
U33 | SN74AVC16T245DGGR | 36 | 2A1 | D8A |  | 电平转换
U33 | SN74AVC16T245DGGR | 37 | 1A8 | D7A |  | 电平转换
U33 | SN74AVC16T245DGGR | 38 | 1A7 | D6A |  | 电平转换
U33 | SN74AVC16T245DGGR | 39 | GND | GND | X1.24；X1.25；X1.38；X1.39；X1.89；X1.90；X2.1；X2.2；X2.3；X2.4；X2.5；X2.6；X2.7；X2.8；X2.31；X2.42；X2.49；X2.60；X2.67；X2.82 | 电平转换
U33 | SN74AVC16T245DGGR | 40 | 1A6 | D5A |  | 电平转换
U33 | SN74AVC16T245DGGR | 41 | 1A5 | D4A |  | 电平转换
U33 | SN74AVC16T245DGGR | 42 | VCCA | A-DVDD1.8V |  | 电平转换
U33 | SN74AVC16T245DGGR | 43 | 1A4 | D3A |  | 电平转换
U33 | SN74AVC16T245DGGR | 44 | 1A3 | D2A |  | 电平转换
U33 | SN74AVC16T245DGGR | 45 | GND | GND | X1.24；X1.25；X1.38；X1.39；X1.89；X1.90；X2.1；X2.2；X2.3；X2.4；X2.5；X2.6；X2.7；X2.8；X2.31；X2.42；X2.49；X2.60；X2.67；X2.82 | 电平转换
U33 | SN74AVC16T245DGGR | 46 | 1A2 | D1A |  | 电平转换
U33 | SN74AVC16T245DGGR | 47 | 1A1 | D0A(LSB) |  | 电平转换
U33 | SN74AVC16T245DGGR | 48 | 1OE# | ADC_DATA_OE_N | X1.31 | 电平转换
U36 | SN74AVC16T245DGGR | 1 | 1DIR | DIR |  | 电平转换
U36 | SN74AVC16T245DGGR | 2 | 1B1 | ADC_B_D0(LSB) | X2.21 | 电平转换
U36 | SN74AVC16T245DGGR | 3 | 1B2 | ADC_B_D1 | X2.54 | 电平转换
U36 | SN74AVC16T245DGGR | 4 | GND | GND | X1.24；X1.25；X1.38；X1.39；X1.89；X1.90；X2.1；X2.2；X2.3；X2.4；X2.5；X2.6；X2.7；X2.8；X2.31；X2.42；X2.49；X2.60；X2.67；X2.82 | 电平转换
U36 | SN74AVC16T245DGGR | 5 | 1B3 | ADC_B_D2 | X2.53 | 电平转换
U36 | SN74AVC16T245DGGR | 6 | 1B4 | ADC_B_D3 | X2.52 | 电平转换
U36 | SN74AVC16T245DGGR | 7 | VCCB | CH-3.3V |  | 电平转换
U36 | SN74AVC16T245DGGR | 8 | 1B5 | ADC_B_D4 | X2.50 | 电平转换
U36 | SN74AVC16T245DGGR | 9 | 1B6 | ADC_B_D5 | X2.48 | 电平转换
U36 | SN74AVC16T245DGGR | 10 | GND | GND | X1.24；X1.25；X1.38；X1.39；X1.89；X1.90；X2.1；X2.2；X2.3；X2.4；X2.5；X2.6；X2.7；X2.8；X2.31；X2.42；X2.49；X2.60；X2.67；X2.82 | 电平转换
U36 | SN74AVC16T245DGGR | 11 | 1B7 | ADC_B_D6 | X2.47 | 电平转换
U36 | SN74AVC16T245DGGR | 12 | 1B8 | ADC_B_D7 | X2.46 | 电平转换
U36 | SN74AVC16T245DGGR | 13 | 2B1 | ADC_B_D8 | X2.45 | 电平转换
U36 | SN74AVC16T245DGGR | 14 | 2B2 | ADC_B_D9 | X2.44 | 电平转换
U36 | SN74AVC16T245DGGR | 15 | GND | GND | X1.24；X1.25；X1.38；X1.39；X1.89；X1.90；X2.1；X2.2；X2.3；X2.4；X2.5；X2.6；X2.7；X2.8；X2.31；X2.42；X2.49；X2.60；X2.67；X2.82 | 电平转换
U36 | SN74AVC16T245DGGR | 16 | 2B3 | ADC_B_D10 | X2.43 | 电平转换
U36 | SN74AVC16T245DGGR | 17 | 2B4 | ADC_B_D11 | X2.41 | 电平转换
U36 | SN74AVC16T245DGGR | 18 | VCCB | CH-3.3V |  | 电平转换
U36 | SN74AVC16T245DGGR | 19 | 2B5 | ADC_B_D12 | X2.39 | 电平转换
U36 | SN74AVC16T245DGGR | 20 | 2B6 | ADC_B_D13 | X2.37 | 电平转换
U36 | SN74AVC16T245DGGR | 21 | GND | GND | X1.24；X1.25；X1.38；X1.39；X1.89；X1.90；X2.1；X2.2；X2.3；X2.4；X2.5；X2.6；X2.7；X2.8；X2.31；X2.42；X2.49；X2.60；X2.67；X2.82 | 电平转换
U36 | SN74AVC16T245DGGR | 22 | 2B7 | ADC_B_D14 | X2.35 | 电平转换
U36 | SN74AVC16T245DGGR | 23 | 2B8 | ADC_B_D15 | X2.33 | 电平转换
U36 | SN74AVC16T245DGGR | 24 | 2DIR | DIR |  | 电平转换
U36 | SN74AVC16T245DGGR | 25 | 2OE# | ADC_DATA_OE_N | X1.31 | 电平转换
U36 | SN74AVC16T245DGGR | 26 | 2A8 | D15B |  | 电平转换
U36 | SN74AVC16T245DGGR | 27 | 2A7 | D14B |  | 电平转换
U36 | SN74AVC16T245DGGR | 28 | GND | GND | X1.24；X1.25；X1.38；X1.39；X1.89；X1.90；X2.1；X2.2；X2.3；X2.4；X2.5；X2.6；X2.7；X2.8；X2.31；X2.42；X2.49；X2.60；X2.67；X2.82 | 电平转换
U36 | SN74AVC16T245DGGR | 29 | 2A6 | D13B |  | 电平转换
U36 | SN74AVC16T245DGGR | 30 | 2A5 | D12B |  | 电平转换
U36 | SN74AVC16T245DGGR | 31 | VCCA | A-DVDD1.8V |  | 电平转换
U36 | SN74AVC16T245DGGR | 32 | 2A4 | D11B |  | 电平转换
U36 | SN74AVC16T245DGGR | 33 | 2A3 | D10B |  | 电平转换
U36 | SN74AVC16T245DGGR | 34 | GND | GND | X1.24；X1.25；X1.38；X1.39；X1.89；X1.90；X2.1；X2.2；X2.3；X2.4；X2.5；X2.6；X2.7；X2.8；X2.31；X2.42；X2.49；X2.60；X2.67；X2.82 | 电平转换
U36 | SN74AVC16T245DGGR | 35 | 2A2 | D9B |  | 电平转换
U36 | SN74AVC16T245DGGR | 36 | 2A1 | D8B |  | 电平转换
U36 | SN74AVC16T245DGGR | 37 | 1A8 | D7B |  | 电平转换
U36 | SN74AVC16T245DGGR | 38 | 1A7 | D6B |  | 电平转换
U36 | SN74AVC16T245DGGR | 39 | GND | GND | X1.24；X1.25；X1.38；X1.39；X1.89；X1.90；X2.1；X2.2；X2.3；X2.4；X2.5；X2.6；X2.7；X2.8；X2.31；X2.42；X2.49；X2.60；X2.67；X2.82 | 电平转换
U36 | SN74AVC16T245DGGR | 40 | 1A6 | D5B |  | 电平转换
U36 | SN74AVC16T245DGGR | 41 | 1A5 | D4B |  | 电平转换
U36 | SN74AVC16T245DGGR | 42 | VCCA | A-DVDD1.8V |  | 电平转换
U36 | SN74AVC16T245DGGR | 43 | 1A4 | D3B |  | 电平转换
U36 | SN74AVC16T245DGGR | 44 | 1A3 | D2B |  | 电平转换
U36 | SN74AVC16T245DGGR | 45 | GND | GND | X1.24；X1.25；X1.38；X1.39；X1.89；X1.90；X2.1；X2.2；X2.3；X2.4；X2.5；X2.6；X2.7；X2.8；X2.31；X2.42；X2.49；X2.60；X2.67；X2.82 | 电平转换
U36 | SN74AVC16T245DGGR | 46 | 1A2 | D1B |  | 电平转换
U36 | SN74AVC16T245DGGR | 47 | 1A1 | D0B(LSB) |  | 电平转换
U36 | SN74AVC16T245DGGR | 48 | 1OE# | ADC_DATA_OE_N | X1.31 | 电平转换
U39 | SN74AVC4T774PWR | 1 | DIR1 | DIR |  | 电平转换
U39 | SN74AVC4T774PWR | 2 | DIR2 | DIR |  | 电平转换
U39 | SN74AVC4T774PWR | 3 | A1 | ORA |  | 电平转换
U39 | SN74AVC4T774PWR | 4 | A2 | DCOA |  | 电平转换
U39 | SN74AVC4T774PWR | 5 | A3 | DCOB |  | 电平转换
U39 | SN74AVC4T774PWR | 6 | A4 | ORB |  | 电平转换
U39 | SN74AVC4T774PWR | 7 | DIR3 | DIR |  | 电平转换
U39 | SN74AVC4T774PWR | 8 | DIR4 | DIR |  | 电平转换
U39 | SN74AVC4T774PWR | 9 | OE# | ADC_CTRL_OE_N | X1.33 | 电平转换
U39 | SN74AVC4T774PWR | 10 | GND | GND | X1.24；X1.25；X1.38；X1.39；X1.89；X1.90；X2.1；X2.2；X2.3；X2.4；X2.5；X2.6；X2.7；X2.8；X2.31；X2.42；X2.49；X2.60；X2.67；X2.82 | 电平转换
U39 | SN74AVC4T774PWR | 11 | B4 | ADC_ORB | X2.25 | 电平转换
U39 | SN74AVC4T774PWR | 12 | B3 | ADC_OCOB | X2.51 | 电平转换
U39 | SN74AVC4T774PWR | 13 | B2 | ADC_OCOA | X2.29 | 电平转换
U39 | SN74AVC4T774PWR | 14 | B1 | ADC_ORA | X2.27 | 电平转换
U39 | SN74AVC4T774PWR | 15 | VCCB | CH-3.3V |  | 电平转换
U39 | SN74AVC4T774PWR | 16 | VCCA | A-DVDD1.8V |  | 电平转换
U8 | CH340X | 1 | UD+ | D+ |  | 核心板
U8 | CH340X | 2 | UD- | D- |  | 核心板
U8 | CH340X | 3 | GND | GND | X1.24；X1.25；X1.38；X1.39；X1.89；X1.90；X2.1；X2.2；X2.3；X2.4；X2.5；X2.6；X2.7；X2.8；X2.31；X2.42；X2.49；X2.60；X2.67；X2.82 | 核心板
U8 | CH340X | 4 | RTS# | 未命名／未连接 |  | 核心板
U8 | CH340X | 5 | CTS# | 未命名／未连接 |  | 核心板
U8 | CH340X | 6 | TNOW/DTR# | 未命名／未连接 |  | 核心板
U8 | CH340X | 7 | VCC | CH-3.3V |  | 核心板
U8 | CH340X | 8 | TXD | TXD | X1-12 | 核心板
U8 | CH340X | 9 | RXD | RXD | X1-14 | 核心板
U8 | CH340X | 10 | V3 | CH-3.3V |  | 核心板
FPC1 | AFC01-S40FCA-00 | 1 | 1 | 5.0V | X2.93；X2.94；X2.95；X2.96；X2.97；X2.98；X2.99；X2.100 | 核心板
FPC1 | AFC01-S40FCA-00 | 2 | 2 | 5.0V | X2.93；X2.94；X2.95；X2.96；X2.97；X2.98；X2.99；X2.100 | 核心板
FPC1 | AFC01-S40FCA-00 | 3 | 3 | B34_L18_N LCD_R1 | X2.58 | 核心板
FPC1 | AFC01-S40FCA-00 | 4 | 4 | B34_L18_P LCD_R0 | X2.56 | 核心板
FPC1 | AFC01-S40FCA-00 | 5 | 5 | B34_L5_P LCD_R2 | X2.55 | 核心板
FPC1 | AFC01-S40FCA-00 | 6 | 6 | B34_L5_N LCD_R3 | X2.57 | 核心板
FPC1 | AFC01-S40FCA-00 | 7 | 7 | B34_L7_P LCD_R5 | X2.64 | 核心板
FPC1 | AFC01-S40FCA-00 | 8 | 8 | B34_L7_N LCD_R4 | X2.62 | 核心板
FPC1 | AFC01-S40FCA-00 | 9 | 9 | B34_L9_P LCD_R6 | X2.59 | 核心板
FPC1 | AFC01-S40FCA-00 | 10 | 10 | B34_L9_N LCD_R7 | X2.61 | 核心板
FPC1 | AFC01-S40FCA-00 | 11 | 11 | GND | X1.24；X1.25；X1.38；X1.39；X1.89；X1.90；X2.1；X2.2；X2.3；X2.4；X2.5；X2.6；X2.7；X2.8；X2.31；X2.42；X2.49；X2.60；X2.67；X2.82 | 核心板
FPC1 | AFC01-S40FCA-00 | 12 | 12 | B34_L21_N LCD_G1 | X2.68 | 核心板
FPC1 | AFC01-S40FCA-00 | 13 | 13 | B34_L21_P LCD_G0 | X2.66 | 核心板
FPC1 | AFC01-S40FCA-00 | 14 | 14 | B34_L20_P LCD_G2 | X2.63 | 核心板
FPC1 | AFC01-S40FCA-00 | 15 | 15 | B34_L20_N LCD_G3 | X2.65 | 核心板
FPC1 | AFC01-S40FCA-00 | 16 | 16 | B34_L17_N LCD_G5 | X2.72 | 核心板
FPC1 | AFC01-S40FCA-00 | 17 | 17 | B34_L17_P LCD_G4 | X2.70 | 核心板
FPC1 | AFC01-S40FCA-00 | 18 | 18 | B34_L24_P LCD_G6 | X2.69 | 核心板
FPC1 | AFC01-S40FCA-00 | 19 | 19 | B34_L24_N LCD_G7 | X2.71 | 核心板
FPC1 | AFC01-S40FCA-00 | 20 | 20 | GND | X1.24；X1.25；X1.38；X1.39；X1.89；X1.90；X2.1；X2.2；X2.3；X2.4；X2.5；X2.6；X2.7；X2.8；X2.31；X2.42；X2.49；X2.60；X2.67；X2.82 | 核心板
FPC1 | AFC01-S40FCA-00 | 21 | 21 | B34_L22_N LCD_B1 | X2.76 | 核心板
FPC1 | AFC01-S40FCA-00 | 22 | 22 | B34_L22_P LCD_B0 | X2.74 | 核心板
FPC1 | AFC01-S40FCA-00 | 23 | 23 | B34_L19_P LCD_B2 | X2.73 | 核心板
FPC1 | AFC01-S40FCA-00 | 24 | 24 | B34_L19_N LCD_B3 | X2.75 | 核心板
FPC1 | AFC01-S40FCA-00 | 25 | 25 | B34_L16_P LCD_B5 | X2.80 | 核心板
FPC1 | AFC01-S40FCA-00 | 26 | 26 | B34_L16_N LCD_B4 | X2.78 | 核心板
FPC1 | AFC01-S40FCA-00 | 27 | 27 | B34_L23_N LCD_B6 | X2.79 | 核心板
FPC1 | AFC01-S40FCA-00 | 28 | 28 | B34_L23_P LCD_B7 | X2.81 | 核心板
FPC1 | AFC01-S40FCA-00 | 29 | 29 | GND | X1.24；X1.25；X1.38；X1.39；X1.89；X1.90；X2.1；X2.2；X2.3；X2.4；X2.5；X2.6；X2.7；X2.8；X2.31；X2.42；X2.49；X2.60；X2.67；X2.82 | 核心板
FPC1 | AFC01-S40FCA-00 | 30 | 30 | B34_L13_N LCD_CLK | X2.83 | 核心板
FPC1 | AFC01-S40FCA-00 | 31 | 31 | B34_L13_P LCD_HSYNC | X2.85 | 核心板
FPC1 | AFC01-S40FCA-00 | 32 | 32 | B34_L15_P LCD_VSYNC | X2.88 | 核心板
FPC1 | AFC01-S40FCA-00 | 33 | 33 | B34_L15_N LCD_DE | X2.90 | 核心板
FPC1 | AFC01-S40FCA-00 | 34 | 34 | B35_L7_N LCD_BL | X1.72 | 核心板
FPC1 | AFC01-S40FCA-00 | 35 | 35 | B35_L7_P T_CS | X1.70 | 核心板
FPC1 | AFC01-S40FCA-00 | 36 | 36 | B34_L14_N II2C_SDA | X2.87 | 核心板
FPC1 | AFC01-S40FCA-00 | 37 | 37 | B34_L14_P T_MISO | X2.89 | 核心板
FPC1 | AFC01-S40FCA-00 | 38 | 38 | B34_IO0 II2C_SCL | X2.77 | 核心板
FPC1 | AFC01-S40FCA-00 | 39 | 39 | B34_L12_N T_PEN | X2.84 | 核心板
FPC1 | AFC01-S40FCA-00 | 40 | 40 | B35_L11_N LCD_RST | X1.51 | 核心板
FPC1 | AFC01-S40FCA-00 | 41 | 41 | GND | X1.24；X1.25；X1.38；X1.39；X1.89；X1.90；X2.1；X2.2；X2.3；X2.4；X2.5；X2.6；X2.7；X2.8；X2.31；X2.42；X2.49；X2.60；X2.67；X2.82 | 核心板
FPC1 | AFC01-S40FCA-00 | 42 | 42 | GND | X1.24；X1.25；X1.38；X1.39；X1.89；X1.90；X2.1；X2.2；X2.3；X2.4；X2.5；X2.6；X2.7；X2.8；X2.31；X2.42；X2.49；X2.60；X2.67；X2.82 | 核心板
U18 | HC-PM254-8.5H-2x15PW | 1 | 1 | 未命名／未连接 |  | 核心板
U18 | HC-PM254-8.5H-2x15PW | 2 | 2 | $R40_1 | X1-87 | 核心板
U18 | HC-PM254-8.5H-2x15PW | 3 | 3 | 未命名／未连接 |  | 核心板
U18 | HC-PM254-8.5H-2x15PW | 4 | 4 | $R39_1 | X1-85 | 核心板
U18 | HC-PM254-8.5H-2x15PW | 5 | 5 | 未命名／未连接 |  | 核心板
U18 | HC-PM254-8.5H-2x15PW | 6 | 6 | $R38_1 | X1-83 | 核心板
U18 | HC-PM254-8.5H-2x15PW | 7 | 7 | 未命名／未连接 |  | 核心板
U18 | HC-PM254-8.5H-2x15PW | 8 | 8 | $R37_1 | X1-81 | 核心板
U18 | HC-PM254-8.5H-2x15PW | 9 | 9 | 未命名／未连接 |  | 核心板
U18 | HC-PM254-8.5H-2x15PW | 10 | 10 | $R36_1 | X1-79 | 核心板
U18 | HC-PM254-8.5H-2x15PW | 11 | 11 | 未命名／未连接 |  | 核心板
U18 | HC-PM254-8.5H-2x15PW | 12 | 12 | $R35_1 | X1-77 | 核心板
U18 | HC-PM254-8.5H-2x15PW | 13 | 13 | 未命名／未连接 |  | 核心板
U18 | HC-PM254-8.5H-2x15PW | 14 | 14 | $R41_1 | X1-48 | 核心板
U18 | HC-PM254-8.5H-2x15PW | 15 | 15 | 未命名／未连接 |  | 核心板
U18 | HC-PM254-8.5H-2x15PW | 16 | 16 | DAC2 |  | 核心板
U18 | HC-PM254-8.5H-2x15PW | 17 | 17 | 未命名／未连接 |  | 核心板
U18 | HC-PM254-8.5H-2x15PW | 18 | 18 | 未命名／未连接 |  | 核心板
U18 | HC-PM254-8.5H-2x15PW | 19 | 19 | 未命名／未连接 |  | 核心板
U18 | HC-PM254-8.5H-2x15PW | 20 | 20 | DAC3 |  | 核心板
U18 | HC-PM254-8.5H-2x15PW | 21 | 21 | 未命名／未连接 |  | 核心板
U18 | HC-PM254-8.5H-2x15PW | 22 | 22 | DAC1 |  | 核心板
U18 | HC-PM254-8.5H-2x15PW | 23 | 23 | 未命名／未连接 |  | 核心板
U18 | HC-PM254-8.5H-2x15PW | 24 | 24 | 未命名／未连接 |  | 核心板
U18 | HC-PM254-8.5H-2x15PW | 25 | 25 | 未命名／未连接 |  | 核心板
U18 | HC-PM254-8.5H-2x15PW | 26 | 26 | 未命名／未连接 |  | 核心板
U18 | HC-PM254-8.5H-2x15PW | 27 | 27 | 未命名／未连接 |  | 核心板
U18 | HC-PM254-8.5H-2x15PW | 28 | 28 | ADC1 |  | 核心板
U18 | HC-PM254-8.5H-2x15PW | 29 | 29 | 未命名／未连接 |  | 核心板
U18 | HC-PM254-8.5H-2x15PW | 30 | 30 | ADC2 |  | 核心板
