hscsja03-afk/-BJT-/board/hardware/adda/ad9747_firmware_guide.md

# AD9747 电流设置与波形输出编程说明

适用对象：本项目的 AD9747（U2）及 FPGA/处理器固件开发。

本说明基于 ADI AD9743/AD9745/AD9746/AD9747 数据手册 Rev. C，第 21～27 页。配套 `ad9747-example.c` 是平台无关 C 示例，需要实现底层 SPI、片选、RESET 和延时接口；不是已经适配本板的完整驱动。

## 1. 先区分两种“设置电流”

- SPI 写入 10 位 FSC：设置一个通道的满量程电流 I_FS，通常开机设一次。
- FPGA 并行口送入 16 位 DATA：决定每个采样时刻，满量程电流如何分配到 IOUTP 和 IOUTN。
- 一个通道的 P、N 是互补输出，不是两个可以独立写入数据的 DAC。
- DAC1、DAC2 各有自己的 FSC 和采样数据。双端口模式下，P1D[15:0] 对应 DAC1，P2D[15:0] 对应 DAC2。
- SPI 不能代替并行采样口写入波形数据。静态电平也应保持 DAC 采样时钟运行，并在相应并行口持续保持固定码值。

## 2. 本板及模拟电路前提

网表中，U2.54（FSADJ）经 R88=10 kΩ 接地，U2.55 为 REFIO，接 C64=100 nF 去耦。下文满量程公式按内部 1.2 V 标称基准计算。

电压公式要求模拟部分已经实际改为下列阻值，不能直接用于网表原有的四只 499 Ω：

| 第一通道 | 第二通道 | 目标值 |
|---|---|---:|
| R165、R166 | R177、R178 | 各 50 Ω |
| R171，反相输入 | R183 | 250 Ω |
| R172，反馈 | R184 | 300 Ω |
| R173，同相输入 | R185 | 50 Ω |
| R174，同相接地 | R186 | 100 Ω |

只能并联时：50 Ω = 100 Ω ∥ 100 Ω；250 Ω = 300 Ω ∥ 1.5 kΩ。本文不修改用户网表。

其他前提：中间 LC 旁路/移除；两只 DAC 接地电阻对称；LMH6609 正常负反馈，供电约 ±4.5 V。这里讨论低频/直流理想增益，不保证高频平坦度或实物零偏精度。

## 3. 设置满量程电流：固定为约 20 mA

FSC 是 10 位无符号数，取值 0～1023。对于 10 kΩ FSADJ 电阻、1.2 V 基准：

```text
I_FS(A)  = (1.2 / 10000) × (72 + 3 × FSC / 16)
I_FS(mA) = 8.64 + 0.0225 × FSC
FSC      = round((I_FS(mA) - 8.64) / 0.0225)
```

| FSC | 十进制 | 按公式的标称 I_FS |
|---|---:|---:|
| 0x0000 | 0 | 8.6400 mA |
| 0x01F9 | 505 | 20.0025 mA（手册称 20 mA） |
| 0x03FF | 1023 | 31.6575 mA |

本模拟网络推荐使用 `FSC=0x01F9`。不要因为器件支持 31.7 mA，就直接把本板设置到最大：当前网络在约 20 mA 时，DAC 引脚最高电压约 0.833 V；31.6575 mA 时约 1.319 V，超出主输出约 -1～+1 V 的合规范围。高频过冲也应留余量。

注意：FSC=0 不代表输出电流为 0，而是满量程约 8.64 mA。要使最终单端输出接近 0 V，应送中码；不要用关闭 DAC 来代替精确零电压输出。

## 4. 建议寄存器配置

本示例明确选择：4 线 SPI、MSB first、无符号二进制、双端口、正常输出模式、约 20 mA、禁用 AUX DAC。

| 地址 | 数据 | 意义 |
|---|---:|---|
| 0x00 | 0x00 | 4 线 SPI、MSB first、非软件复位状态 |
| 0x03 | 0x33（配置期间） | 暂时关闭 DAC1/2 输出，关闭 AUX1/2；保留主参考和时钟电路 |
| 0x02 | 0x80 | DATTYPE=1：无符号；ONEPORT=0：双端口；不反转 DCO |
| 0x0A | 0x00 | DAC1/2 均为 normal mode；不要选 mix/RZ 来套用本文直流公式 |
| 0x0B | 0xF9 | DAC1 FSC 低 8 位 |
| 0x0C | 0x01 | DAC1 FSC 高 2 位 |
| 0x0F | 0xF9 | DAC2 FSC 低 8 位 |
| 0x10 | 0x01 | DAC2 FSC 高 2 位 |
| 0x03 | 0x30（配置完成） | 开启 DAC1/2 输出，AUX1/2 继续关闭 |

FSC 的高字节只写低 2 位，其余保留位写 0。代码使用独立单字节访问，避免 MSB-first 多字节地址递减造成写错寄存器。

### SPI 事务

使用 SPI Mode 0（CPOL=0、CPHA=0），起步可选 1 MHz；器件 SCLK 上限为 40 MHz。CSB 在完整指令和数据两个字节期间保持低。

```text
写单字节：CSB=0 → 发送 (addr & 0x1F) → 发送 data → CSB=1
读单字节：CSB=0 → 发送 (0x80 | (addr & 0x1F)) → 再发 0x00，接收数据 → CSB=1
```

硬件 RESET 高有效。电源稳定后产生高脉冲，再拉低；正常 SPI 工作时保持低。RESET 一直为高会进入 pin mode，不是正常 SPI 控制模式。手册最低高脉宽 10 ns，示例使用 1 μs。

初始化前应让 FPGA 并行口进入确定状态，建议送 0x8000，并确保 DAC 采样时钟正常。初始化结束后示例额外等待 1 ms（大于手册列出的 DAC 输出唤醒 200 μs）。这些措施不保证上电完全无毛刺；如果负载不允许启动脉冲，需要另外设计模拟静音。

## 5. 16 位采样码怎样分配电流

以下 DATA 为已经配置好的无符号码 0～65535，正常输出模式：

```text
I_P = I_FS × DATA / 65536
I_N = I_FS × (65535 - DATA) / 65536
```

严格按手册公式，两路之和为 `I_FS × 65535/65536`，而不是数学上完全等于 I_FS。以前讨论中的 I_P+I_N=I_FS 是忽略一个 LSB 的近似。

注意默认 DATTYPE=0 是二进制补码；若不写 0x02=0x80，不能直接套用上述无符号码表。若后续选择补码模式，16 位码型与无符号码的对应为 `unsigned_code = raw_twos_complement ^ 0x8000`。

## 6. 采样码到最终电压

本网络 P 接反相支路、N 接同相支路，因此码值增大时，输出电压减小：

```text
V_stage1 = 50 × (I_N - I_P)
         = 50 × I_FS × (65535 - 2 × DATA) / 65536
```

把后级增益和输出负载一起计入，定义：

```text
K = A2 × R_load / (R_series + R_load)
```

本板后级 A2=2，R_series=50 Ω：

- 测一级输出：K=1。
- 测最终接口，外接 50 Ω：K=1。
- 测最终接口，外接高阻：K 约为 2。
- 其他负载：按实际 R_load 代入。直流耦合输入、示波器的 50 Ω/高阻选项必须与软件设定一致。

所需无符号码：

```text
DATA = round(32767.5 - 32768 × V_target / (50 × I_FS × K))
```

结果必须在 0～65535 内，否则请求超量程；代码返回错误，不静默截断波形。

以 I_FS 近似 20.000 mA、K=1 为例：

| 目标电压 | 建议 DATA | 理想实际电压 |
|---|---:|---:|
| +1 V 端点附近 | 0x0000 | +0.9999847 V |
| +0.5 V | 0x4000 | +0.4999847 V |
| 0 V | 0x8000（或 0x7FFF） | -15.26 μV（或 +15.26 μV） |
| -0.5 V | 0xC000 | -0.5000153 V |
| -1 V 端点附近 | 0xFFFF | -0.9999847 V |

FSC=505 按公式是 20.0025 mA，此时端点约 ±1.0001097 V。它只是标称预测；基准、电阻、DAC 增益误差和运放失调会使实物偏离，软件需要实测校准。示例函数使用由 FSC 计算得到的电流，也允许你替换为实测电流。

### 重要：没有严格的单码零电压

16 位有偶数个码，理想零点在 DATA=32767.5，单个整数码不能严格命中。0x7FFF 与 0x8000 分别在零点两边。交替输出可让理想平均值趋近零，但会引入交流分量，不是无纹波直流；实际零点精度还受模拟误差限制。必要时校准为最接近零的码，或增加硬件精调能力。

## 7. 静态输出与交流输出

静态：计算 DATA，写入 FPGA 的 DAC1/2 样本保持寄存器，让对应的并行口在连续采样时钟下保持该值。不通过 SPI 逐样本写入。

正弦或任意波形：

```text
v[n] = V_dc + V_peak × sin(2π × f_out × n / f_sample + phase)
DATA[n] = voltage_to_code(v[n], I_FS, K)
```

建议约束：`abs(V_dc) + V_peak` 不超过实际可用峰值，并预留校准及高频余量。处理器适合生成波形缓冲区、配置 DMA；FPGA 按 DAC 时钟送样本。不要依赖处理器软件定时逐点驱动高速总线。

双端口模式下，每个通道每采样周期送一个 16 位样本。手册对 DAC 上升采样沿列出的最小建立/保持时间分别为 400 ps、1200 ps；双端口数字至模拟输出延迟为 7 个时钟周期。FPGA 需要依据布线、时钟相位和器件时序做实际约束，不能认为接上 DCO 就自动满足时序。

本板并行信号被分散接到 X1 的不同引脚，HDL/XDC 必须逐位按网表映射；本文不猜测开发板引脚约束。

## 8. 调试顺序

1. 核对电源、采样时钟、FSADJ=10 kΩ、REFIO 去耦和模拟电阻确已修改。
2. FPGA 先送中码，RESET 脉冲后保持低，SPI 保持默认 4 线 MSB-first。
3. 按第 4 节配置并回读；FSC 回读组合值应为 0x01F9，0x02 应为 0x80，0x0A 应为 0x00，最终 0x03 应为 0x30。
4. 初期用高阻、直流耦合测一级输出，不先测试高速正弦。依次送 0x8000、0x4000、0xC000，再逐步测试端点。
5. 检查一级输出方向及近似值，直接测 DAC 两脚电压是否在合规范围内；不要只看运放输出。
6. 测量至少两个电压点得到实际斜率和零点，必要时多点校准。分辨率不等于绝对精度，不能把 16 位自动视为 16 位电压准确度。
7. 再调试低频波形、DMA、FPGA 时序及高频响应。高速波形的 sinc 衰减、运放带宽、寄生和输出负载不会被直流公式自动补偿。

## 9. 代码边界

配套示例提供 SPI 读写、20 mA 初始化、FSC 计算、电压转无符号码以及主机自测。它没有实现板级 SPI/GPIO、FPGA 驱动、DMA、XDC 约束或高速波形调度；接入这些接口后才能控制真实硬件。改变 FSC 时两个寄存器写入并非原子操作，应在静音/暂停输出期间配置。

官方来源：https://www.analog.com/media/en/technical-documentation/data-sheets/AD9743_9745_9746_9747.pdf
