hscsja03-afk/-BJT-/build/software/readme.md

# 上位机打包与 Notebook 生成

上位机打包与 Notebook 生成。

## 文件

- [build_desktop.py](build_desktop.py)
- [make_notebook.py](make_notebook.py)
