hscsja03-afk/-BJT-/build/fpga/readme.md

# FPGA 工程创建与时序检查

FPGA 工程创建与时序检查。

## 文件

- [check_adc_fallback.tcl](check_adc_fallback.tcl)
- [create_overlay.tcl](create_overlay.tcl)
- [run.ps1](run.ps1)
