hscsja03-afk/-BJT-/build/environment/readme.md

# Python 环境与仪器依赖

Python 环境与仪器依赖。

## 文件

- [desktop_requirements.lock.txt](desktop_requirements.lock.txt)
- [instrument_requirements.txt](instrument_requirements.txt)
