hscsja03-afk/-BJT-/board/overlay/build_20261104/readme.md

# LCD DDR 位流与硬件描述

2026-11-04 源码构建，包含 LCD DDR 显示逻辑；对应实现报告见 [构建报告](../../../build/reports/lcd_ddr_20261104/readme.md)。

## 文件

- [bjt.bit](bjt.bit)
- [bjt.hwh](bjt.hwh)
- [manifest.json](manifest.json)
