hscsja03-afk/-BJT-/build/reports/baseline50/build_status.txt

vivado=2026.1
profile=baseline50
sta=passed
ps_preset_supplied=0
hardware_tested=0
