hscsja03-afk/-BJT-/build/reports/lcd_ddr_final_20261103/build_status.txt

vivado=2026.1
profile=pynq_adc50_dac125
sta=passed
ps_preset_supplied=1
hardware_tested=0
