hscsja03-afk/-BJT-/report/validation/readme.md

# 软件、程序包与工程校验记录

软件、程序包与工程校验记录。

## 文件

- [analysis_tests.log](analysis_tests.log)
- [baremetal_hardware_snapshot_validation.json](baremetal_hardware_snapshot_validation.json)
- [baremetal_snapshot_validation.json](baremetal_snapshot_validation.json)
- [baremetal_validation.json](baremetal_validation.json)
- [baremetal_wheel_validation.json](baremetal_wheel_validation.json)
- [current_state.json](current_state.json)
- [desktop_build.log](desktop_build.log)
- [desktop_runtime.json](desktop_runtime.json)
- [package_validation.json](package_validation.json)
- [python_tests.log](python_tests.log)
- [python_wheel_validation.json](python_wheel_validation.json)
- [repository_validation.json](repository_validation.json)
- [result_path_recheck.log](result_path_recheck.log)
- [rtl_adc_depth.console.txt](rtl_adc_depth.console.txt)
- [rtl_adc_depth.log](rtl_adc_depth.log)
- [rtl_axi.console.txt](rtl_axi.console.txt)
- [rtl_axi.log](rtl_axi.log)
- [rtl_lcd_ddr.console.txt](rtl_lcd_ddr.console.txt)
- [rtl_lcd_ddr.log](rtl_lcd_ddr.log)
- [skill_locator_tests.log](skill_locator_tests.log)
- [skill_overlay_tests.log](skill_overlay_tests.log)
- [skill_review_tests_20261101.log](skill_review_tests_20261101.log)
- [snapshot_validation.json](snapshot_validation.json)
- [source_consistency.json](source_consistency.json)
- [tx1_bus_recheck.log](tx1_bus_recheck.log)
- [wheel_build.log](wheel_build.log)
