hscsja03-afk/-BJT-/board/calibration/readme.md

# ADC 与 DAC 校准工具

ADC 与 DAC 校准工具。

| 目录 | 内容 |
| --- | --- |
| [rx/](rx/) | RX1/RX2 采集与输入校准 |
| [tx/](tx/) | TX2/TX3 波形与输出校准 |
