hscsja03-afk/-BJT-/data/measurements/comparison/readme.md

# ADC、DAC 与三极管扫描比对表

ADC、DAC 与三极管扫描比对表。

## 文件

- [adc_dc.csv](adc_dc.csv)
- [bjt_runs.csv](bjt_runs.csv)
- [dac_scope.csv](dac_scope.csv)
