hscsja03-afk/-BJT-/board/calibration/tx/readme.md

# TX2/TX3 波形与输出校准

使用示波器测量 TX2/TX3 的幅值与偏置，拟合校准参数并汇总验证点。

## 文件

- [calibrate_tx23_scope.py](calibrate_tx23_scope.py)
- [calibrate_tx3_multi.py](calibrate_tx3_multi.py)
- [calibrate_tx3_sine5m.py](calibrate_tx3_sine5m.py)
- [calibrate_tx_waves_lan.py](calibrate_tx_waves_lan.py)
- [finalize_tx23_calibration.py](finalize_tx23_calibration.py)
- [finalize_tx3_multi.py](finalize_tx3_multi.py)
- [finalize_tx3_sine5m.py](finalize_tx3_sine5m.py)
- [finalize_tx_waves_lan.py](finalize_tx_waves_lan.py)
- [publish_tx23_measured_subset.py](publish_tx23_measured_subset.py)
- [publish_tx2_verified_subset.py](publish_tx2_verified_subset.py)
- [refine_tx3_multi.py](refine_tx3_multi.py)
- [refine_tx3_scope_zero.py](refine_tx3_scope_zero.py)
- [summarize_tx23_calibration.py](summarize_tx23_calibration.py)
- [summarize_tx3_sine5m.py](summarize_tx3_sine5m.py)
