hscsja03-afk/-BJT-/board/calibration/rx/readme.md

# RX1/RX2 采集与输入校准

使用信号发生器采集 RX1/RX2 输入，拟合换算参数并检查直流与交流响应。

## 文件

- [analyze_rx2_ac_generator.py](analyze_rx2_ac_generator.py)
- [calibrate_rx1_generator.py](calibrate_rx1_generator.py)
- [calibrate_rx2_generator.py](calibrate_rx2_generator.py)
- [fit_rx1_generator.py](fit_rx1_generator.py)
- [fit_rx2_generator.py](fit_rx2_generator.py)
- [measure_rx2_ac_generator.py](measure_rx2_ac_generator.py)
- [verify_rx1_release.py](verify_rx1_release.py)
- [verify_rx2_release.py](verify_rx2_release.py)
