hscsja03-afk/-BJT-/skill/mixed-signal-calibration/skill.md

---
name: mixed-signal-calibration
description: 组织 ADC/DAC 校准、独立验证、单位换算与漂移检查，记录量程、时钟和负载条件。
---

# 混合信号校准与单位管理

形式：提示词工作流、实验模板

## 适用场景

ADC/DAC 校准、预热漂移、量程或时钟切换。

## 本队题目之外的应用场景

可用于温度/压力传感器采集、信号发生器、可编程电源和 ADC/DAC 测试。

迁移方法：替换物理量、单位、参考仪器、量程、负载和温态；重新确定码值到物理量的换算关系，沿用标定点与独立检查点分离的方法。

可复用的输出：带测量条件的校准表、检查点误差和稳定性记录。

## 使用方法

固定硬件、通道、采样时钟、仪表负载、频率和温态。区分 ADC码到端口、端口到测试节点、DAC到激励三条变换。保存原始帧和削顶标志；拟合点与独立检查点分开。稳定性使用固定码、预定时间窗和幅值/中心判据。

输出按[实验记录模板](../templates/experiment_record.md)填写输入、步骤、结果与复用条件。

## 协作提示词

> 请按[原始码、波形、仪表条件、旧表]分离三层换算，保留失败帧，以独立点检查拟合误差，并分别报告幅值、中心和固定码漂移。

方括号由使用者替换为目标项目资料。

## 已验证效果

历史 ADC50 独立检查点最大偏差为 RX1 0.338 mV、RX2 0.394 mV（相对发生器标称值）；TX3 固定码正弦稳定窗口与直流中心分别判定。

## 经验来源

曾混用峰值、Vpp、RMS和基波幅度；跟随预热漂移反复调码会掩盖稳定性问题。

## 失效条件与处理

改变板卡、改板、时钟、负载、频率或温态时重新评估校准适用范围。正弦换算关系仅用于相应波形定义。
