hscsja03-afk/-BJT-/data/measurements/comparison/bjt_runs.csv

profile | measurement | method | run_id | recorded_points | csv_rows | started_at | data_file | sha256
npn_big | ac | step | 20261102_140302_bc2e6c94 | 37 | 37 | 1793628182.24396 | board/results/npn_big/ac/step/20261102_140302_bc2e6c94/points.csv | 0832d5f1e2e1666289c7fe20df6579b7d55cda6008a1c47574aa9c577b15bfd1
npn_big | beta | pulse | 20261102_140150_f318b924 | 31 | 16 | 1793628110.2043014 | board/results/npn_big/beta/pulse/20261102_140150_f318b924/beta_points.csv | 43e67f6769f9519d16feaf1129367e4ea18082baf9488b2b0e45360526faea8e
npn_big | beta | step | 20261101_155716_ec36b4cd | 38 | 15 | 1793548636.7984238 | board/results/npn_big/beta/step/20261101_155716_ec36b4cd/beta_points.csv | be97369f969b1534bdfa0f8dc4261b557f9e011eef827e51af56cb5661ca8b47
npn_big | input | step | 20261101_155118_74bc493c | 72 | 72 | 1793548278.7462692 | board/results/npn_big/input/step/20261101_155118_74bc493c/points.csv | 39c093d5d9053d2ee9667809276b30556f5c90f0f6f60ebdad927002b6dfb962
npn_big | output | pulse | 20261102_135955_16fd3e94 | 75 | 75 | 1793627995.5256858 | board/results/npn_big/output/pulse/20261102_135955_16fd3e94/output_points.csv | c55b5f913822f13514815e3480677cf483c97a7bbb2e508868cddc4b16a2d00b
npn_big | output | step | 20261102_113235_c1fd076c | 90 | 90 | 1793619155.34344 | board/results/npn_big/output/step/20261102_113235_c1fd076c/output_points.csv | bb0eb53154e2fec4ad1bb045b6b47f6647daa810a984aa2915c7338e75978565
npn_big | polarity | step | 20261102_104329_173323a9 | 8 | 8 | 1793616209.376165 | board/results/npn_big/polarity/step/20261102_104329_173323a9/points.csv | 0881ccb121905381eb7f8ba20e2edc1e1a2cb2866bc354b4cf9aa7d60eacd18f
npn_small | ac | step | 20261102_135555_73bbf30a | 41 | 41 | 1793627755.7860885 | board/results/npn_small/ac/step/20261102_135555_73bbf30a/points.csv | 5da93a6f237f1a217f617ba14d27015fec6fcac20081031594055a5df0e47202
npn_small | beta | step | 20261102_135337_6a6ad844 | 42 | 21 | 1793627617.6862223 | board/results/npn_small/beta/step/20261102_135337_6a6ad844/beta_points.csv | 8132155cfdd62097cda642ed3593e07103ee7beb0fca969ae75f21b2a34ef760
npn_small | input | step | 20261102_133446_230ba107 | 81 | 81 | 1793626487.0759604 | board/results/npn_small/input/step/20261102_133446_230ba107/points.csv | 4aaf9601cb5f27e1ddb4d2486c96775ef77d8ea6c2f151d751f21dd382ce48c7
npn_small | output | step | 20261102_133530_a4ba00da | 104 | 104 | 1793626530.1706436 | board/results/npn_small/output/step/20261102_133530_a4ba00da/output_points.csv | 5b9af5821a2095f60f8f8ee5063da90b3d7f5e9a31000f5d1bf7d2a4d3b9eeb0
npn_small | polarity | step | 20261102_133429_a3b41531 | 8 | 8 | 1793626469.3214247 | board/results/npn_small/polarity/step/20261102_133429_a3b41531/points.csv | f352a8f153d1cdff9917407f17c83922587e8e7f5190de02f04dcb5efedeff25
pnp_big | ac | step | 20261102_140512_309591fd | 68 | 68 | 1793628312.2086742 | board/results/pnp_big/ac/step/20261102_140512_309591fd/points.csv | 6a862267cffae5138f5190250d27cb603d1d0259d46afea5f6e79dca6a0de686
pnp_big | beta | pulse | 20261102_103841_c628a180 | 32 | 16 | 1793615921.642687 | board/results/pnp_big/beta/pulse/20261102_103841_c628a180/beta_points.csv | e70e5358fb39484112572ca66abcb5a8a052e1ddb175cfcba71ef5ae6f93110d
pnp_big | beta | step | 20261102_140448_37bfa7a2 | 28 | 16 | 1793628288.9492748 | board/results/pnp_big/beta/step/20261102_140448_37bfa7a2/beta_points.csv | ec62f7dab39d6dd6c77837c9a7951d9fdb5b0e03a57a9b6a5ffc2d479378330e
pnp_big | input | step | 20261102_140343_ef5cd4c1 | 40 | 40 | 1793628223.8568351 | board/results/pnp_big/input/step/20261102_140343_ef5cd4c1/points.csv | 730e809b6fa39195752f705226f6fb2df5965282f6af41f480b17b429ad76b0b
pnp_big | output | pulse | 20261102_113420_44504f4d | 84 | 84 | 1793619260.290275 | board/results/pnp_big/output/pulse/20261102_113420_44504f4d/output_points.csv | 3b2683b0323f30987a8a6edef2664f625d81106ce1f1f81cf771ee37bb9f13fc
pnp_big | output | step | 20261102_140417_5783325d | 84 | 84 | 1793628257.4867558 | board/results/pnp_big/output/step/20261102_140417_5783325d/output_points.csv | f13d647a53b6890790d6b8204a3a8abd812869ecfd90cad7c86cfd7a0ea26dd8
pnp_big | polarity | step | 20261102_104152_c376c1fa | 8 | 8 | 1793616112.5594099 | board/results/pnp_big/polarity/step/20261102_104152_c376c1fa/points.csv | 28f6e9fb1fd2d953b1113a2d49ccd1ad850e8e282d8c536179e86882845cdafb
pnp_small | ac | step | 20261102_135852_6d50ddf0 | 68 | 68 | 1793627932.195531 | board/results/pnp_small/ac/step/20261102_135852_6d50ddf0/points.csv | cdb01a3b2acfa2492e22ceb2e018459f0a39c829214da883cb3dfdf51336d56b
pnp_small | beta | step | 20261102_135826_3025fc16 | 40 | 20 | 1793627906.6051037 | board/results/pnp_small/beta/step/20261102_135826_3025fc16/beta_points.csv | 2bacbb05848b75e52a0f9605a22cb7f517299c016e2da4586dfb1cc786f34175
pnp_small | input | step | 20261102_135706_482c8774 | 40 | 40 | 1793627826.999028 | board/results/pnp_small/input/step/20261102_135706_482c8774/points.csv | db8eab7235795f5c78b84e37804d00241986388dafbf091c113179a394182bef
pnp_small | output | step | 20261102_135737_8bf66e0b | 152 | 152 | 1793627857.5880904 | board/results/pnp_small/output/step/20261102_135737_8bf66e0b/output_points.csv | c0b3039bca7bc8078c1ec9846e07d89506c64659eac09c265b3d603b68c48c98
pnp_small | polarity | step | 20261102_135650_29afc9c1 | 8 | 8 | 1793627810.356216 | board/results/pnp_small/polarity/step/20261102_135650_29afc9c1/points.csv | 724b6c11d73e9ddc21dc369817d0f7242ea1be8bbe53bd4de89962c0d9586095
