hscsja03-afk/-BJT-/sim/results/readme.md

# RTL、软件与程序运行结果

RTL、软件与程序运行结果。

## 文件

- [c_driver_tests.log](c_driver_tests.log)
- [program_runtime.json](program_runtime.json)
- [rtl_adc_depth.log](rtl_adc_depth.log)
- [rtl_axi.log](rtl_axi.log)
- [rtl_lcd_ddr.log](rtl_lcd_ddr.log)
- [software_build.log](software_build.log)
- [software_tests.log](software_tests.log)
