hscsja03-afk/-BJT-/report/measurements/readme.md

# 实测指标统计

实测指标统计。

## 文件

- [summary.json](summary.json)
