hscsja03-afk/-BJT-/board/results/readme.md

# 三极管实测记录与曲线数据

测量结果按器件档位、测量类型、方法和运行编号保存。归档索引见 report/indexes/measurement_index.json。

## 文件

- [measurement_results.zip.001](measurement_results.zip.001)
- [measurement_results.zip.002](measurement_results.zip.002)
- [measurement_results.zip.003](measurement_results.zip.003)
