hscsja03-afk/-BJT-/src/python/tests/readme.md

# 特性分析与测量流程测试

特性分析与测量流程测试。

## 文件

- [test_analysis.py](test_analysis.py)
- [test_characteristics.py](test_characteristics.py)
