hscsja03-afk/-BJT-/data/measurements/instruments/readme.md

# 仪器读数与波形来源

仪器读数与波形来源。

| 目录 | 内容 |
| --- | --- |
| [tx/](tx/) | TX2/TX3 示波器比对记录 |
