hscsja03-afk/-BJT-/data/measurements/instruments/tx/readme.md

# TX2/TX3 示波器比对记录

TX2/TX3 示波器比对记录。

## 文件

- [verification.json](verification.json)
