hscsja03-afk/-BJT-/skill/measurement-sweep-integrity/skill.md

---
name: measurement-sweep-integrity
description: 检查扫描状态、采样点、数据保存及输出关闭，并用固定条件比较扫描性能。
---

# 测量扫描与性能对照

形式：提示词工作流、实验模板

## 适用场景

输入/输出/电流增益/交流扫描、分段步进、反馈搜索及提速。

## 本队题目之外的应用场景

可用于MOSFET 或二极管伏安测试、滤波器扫频、传感器自动标定。

迁移方法：替换扫描变量、偏置控制、量程、等待条件及拟合模型；复用扫描计划、逐点保存、取消处理和同点数性能对照。器件公式按目标对象设置。

可复用的输出：完整测点表、异常/取消记录及同条件耗时比较。

## 使用方法

先生成完整扫描计划和点数，固定偏置容差、等待及搜索上限。逐点保存设定、回读、原始帧、状态和耗时。定位搜索、等待、传输、绘图与拟合开销；用同一计划进行前后对照，保留无效点和取消记录。

输出按[实验记录模板](../templates/experiment_record.md)填写输入、步骤、结果与复用条件。

## 协作提示词

> 请根据[扫描计划、实测记录、耗时分解]找到瓶颈，保持点数、容差与测量条件一致，报告耗时减少比例、误差变化及取消后的输出状态。

方括号由使用者替换为目标项目资料。

## 已验证效果

历史同条件输出扫描 111 点耗时由 63.397 s 降至 43.360 s；49 个偏置点的增益扫描由 169.181 s 降至 59.514 s。

## 经验来源

深拷贝和重复传输影响扫描耗时；不同范围或点数的扫描直接比较会夸大优化效果。

## 失效条件与处理

负载、器件档位、等待窗口或偏置误差改变时重新建立对照。模型拟合只在有效测量范围内解释，外推结果单独标注。
