hscsja03-afk/-BJT-/skill/templates/experiment_record.md

# 实验与复用记录

- 任务和适用场景：
- 工程/板卡/器件版本：
- 输入文件、来源与SHA256：
- 接口、时钟、地址、量程、负载与仪表条件：
- 基线与通过条件：

| 步骤 | 命令或提示词 | 观察/输出 | 判断与修改 | 证据文件 |
| --- | --- | --- | --- | --- |

## 验证结果

填写实际执行的命令、数据、误差、耗时和适用范围。原始协作记录另存，用文件与段落定位关联提示、回答、纠正和验证。

## 复用方法

- 可直接复用的步骤：
- 换项目需要替换的参数：
- 触发失效的条件与处理方法：
