hscsja03-afk/-BJT-/data/measurements/comparison/adc_dc.csv

channel | role | label | generator_nominal_v | mean_adc_code | converted_v | error_v | reference_instrument | sample_rate_hz | bit_sha256
RX1 | fit | zero_initial | 0 | 32570.354166666668 | 4.046076822909336e-05 | 4.046076822909336e-05 | Rigol Technologies,DG1032Z,DG1ZA173802542,00.01.08 | 50000000 | 7c38abf4caec30d28f239a0eac8ed336e917c78d89245af82ff43e214ba2e8af
RX1 | fit | p0p05 | 0.05 | 31743.636067708332 | 0.050019703440755285 | 1.9703440755282353e-05 | Rigol Technologies,DG1032Z,DG1ZA173802542,00.01.08 | 50000000 | 7c38abf4caec30d28f239a0eac8ed336e917c78d89245af82ff43e214ba2e8af
RX1 | fit | m0p05 | -0.05 | 33399.975260416664 | -0.05011428245442694 | -0.00011428245442693385 | Rigol Technologies,DG1032Z,DG1ZA173802542,00.01.08 | 50000000 | 7c38abf4caec30d28f239a0eac8ed336e917c78d89245af82ff43e214ba2e8af
RX1 | fit | p0p1 | 0.1 | 30914.977213541668 | 0.10011627446940097 | 0.00011627446940096209 | Rigol Technologies,DG1032Z,DG1ZA173802542,00.01.08 | 50000000 | 7c38abf4caec30d28f239a0eac8ed336e917c78d89245af82ff43e214ba2e8af
RX1 | fit | m0p1 | -0.1 | 34226.611653645836 | -0.1000885856070965 | -8.858560709650021e-05 | Rigol Technologies,DG1032Z,DG1ZA173802542,00.01.08 | 50000000 | 7c38abf4caec30d28f239a0eac8ed336e917c78d89245af82ff43e214ba2e8af
RX1 | fit | p0p25 | 0.25 | 28432.469075520832 | 0.2501963039534506 | 0.00019630395345060503 | Rigol Technologies,DG1032Z,DG1ZA173802542,00.01.08 | 50000000 | 7c38abf4caec30d28f239a0eac8ed336e917c78d89245af82ff43e214ba2e8af
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
RX2 | validation | vm0p025 | -0.025 | 32472.924153645832 | -0.024954938005238923 | 4.5061994761078084e-05 | Rigol Technologies,DG1032Z,DG1ZA173802542,00.01.08 | 50000000 | 7c38abf4caec30d28f239a0eac8ed336e917c78d89245af82ff43e214ba2e8af
RX2 | validation | zero_final | 0 | 32885.08203125 | 3.872785055541992e-05 | 3.872785055541992e-05 | Rigol Technologies,DG1032Z,DG1ZA173802542,00.01.08 | 50000000 | 7c38abf4caec30d28f239a0eac8ed336e917c78d89245af82ff43e214ba2e8af
