hscsja03-afk/-BJT-/data/measurements/comparison/dac_scope.csv

channel | waveform | target_frequency_hz | measured_frequency_hz | target_vpp_v | measured_vpp_v | error_v | error_percent | target_offset_v | measured_offset_v | offset_error_v | amplitude_passed | offset_passed | recorded_passed | metric | raw_file | raw_sha256 | bit_sha256
TX2 | sine | 5000000 | 4999994.566869674 | 0.5 | 0.49909304159419837 | -0.0009069584058016278 | -0.18139168116032556 | 0.9 | 0.9050001697492102 | 0.005000169749210137 | True | False | False | sine_fundamental_vpp | report/tx23_recalibration_20261103/mapped_grid/0034_tx2_sine_verify.npz | 23cc25aee4e6b630f5e925c54537024d21f9ba33bd3c4f794a0b17bc9bd870f4 | d844e70d6bb3a813ab08eedd0cf181cbffe8774fe22cac0b4dadf0089bd54001
TX2 | sine | 5000000 | 5000004.736008296 | 0.2 | 0.20170959207207795 | 0.0017095920720779367 | 0.8547960360389684 | 0.9 | 0.9018544427224398 | 0.0018544427224397309 | True | True | True | sine_fundamental_vpp | report/tx23_recalibration_20261103/mapped_grid/0035_tx2_sine_verify.npz | 86eeaa7e17b49874dafe4735989d9a66f90db4d02c6a793b28c469c4688da9fc | d844e70d6bb3a813ab08eedd0cf181cbffe8774fe22cac0b4dadf0089bd54001
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
