hscsja03-afk/-BJT-/board/hardware/bjt/schematic_measurement_switch.png

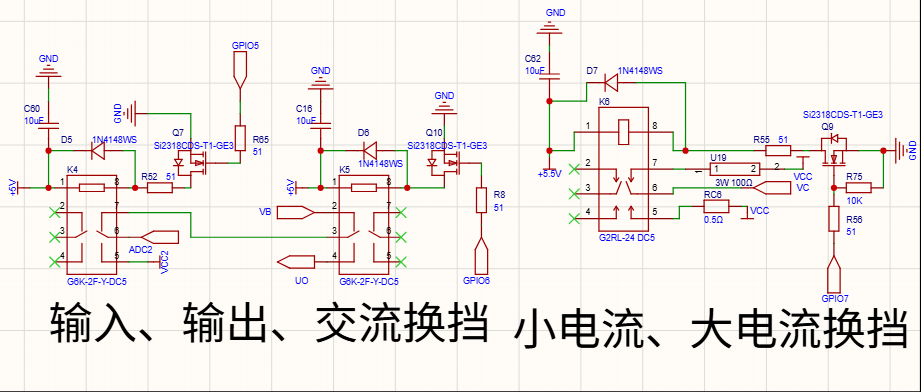
board/hardware/bjt/schematic_measurement_switch.png
