hscsja03-afk/-BJT-/skill/register-to-analog-debug/scripts/readme.md

# PCB 芯片与测点定位脚本

PCB 芯片与测点定位脚本。

## 文件

- [locate_epcb.py](locate_epcb.py)
- [test_locate_epcb.py](test_locate_epcb.py)
