hscsja03-afk/-BJT-/board/hardware/adda/schematic.pdf

# AFE AFE AFE

# AFE

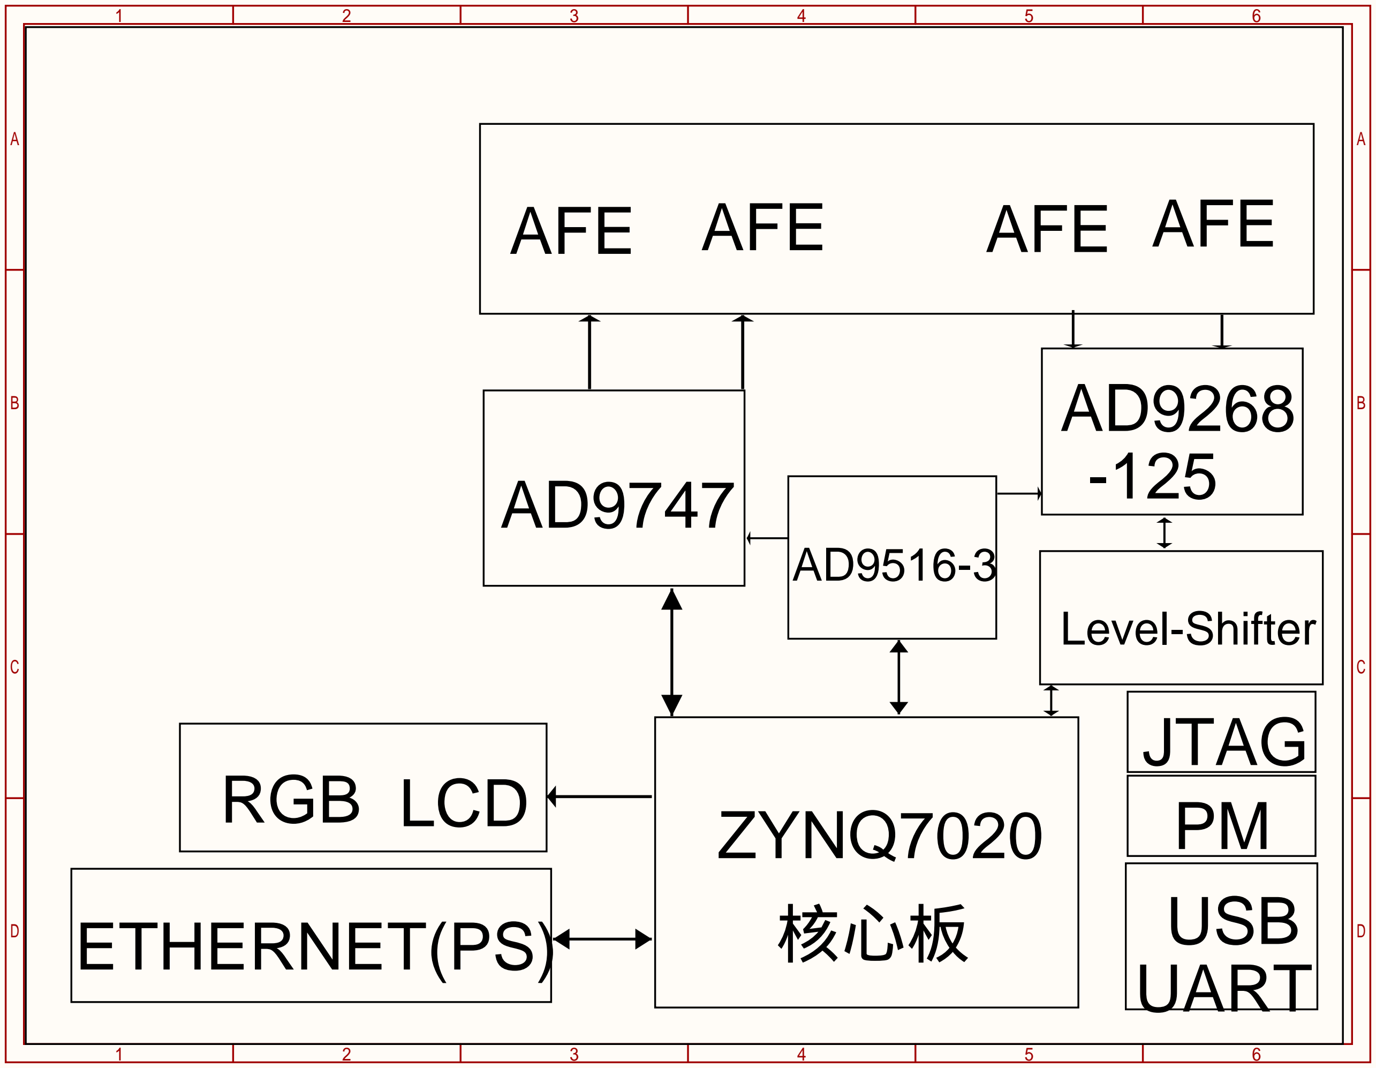
[picture p67: page 1]

# ZYNQ7020

# 核心板

# UART

# USB

PM

-125

# JTAG RGB

AD9268
AD9747

# ETHERNET(PS)

AD9516-3

# LCD

# Level-Shifter

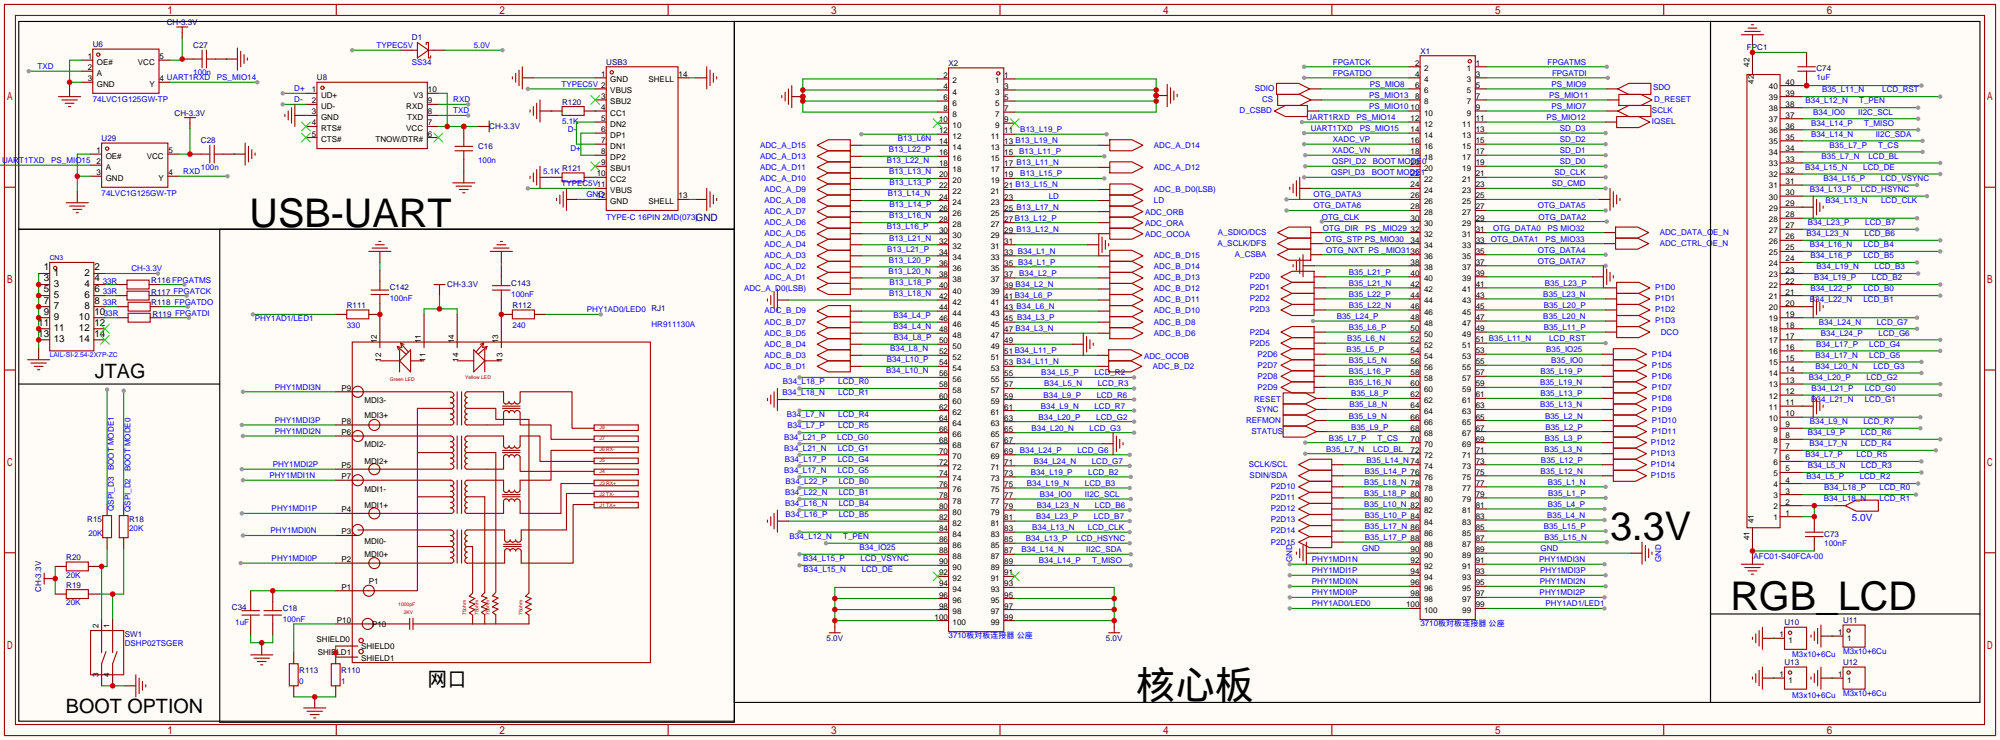
[picture p68: page 2]

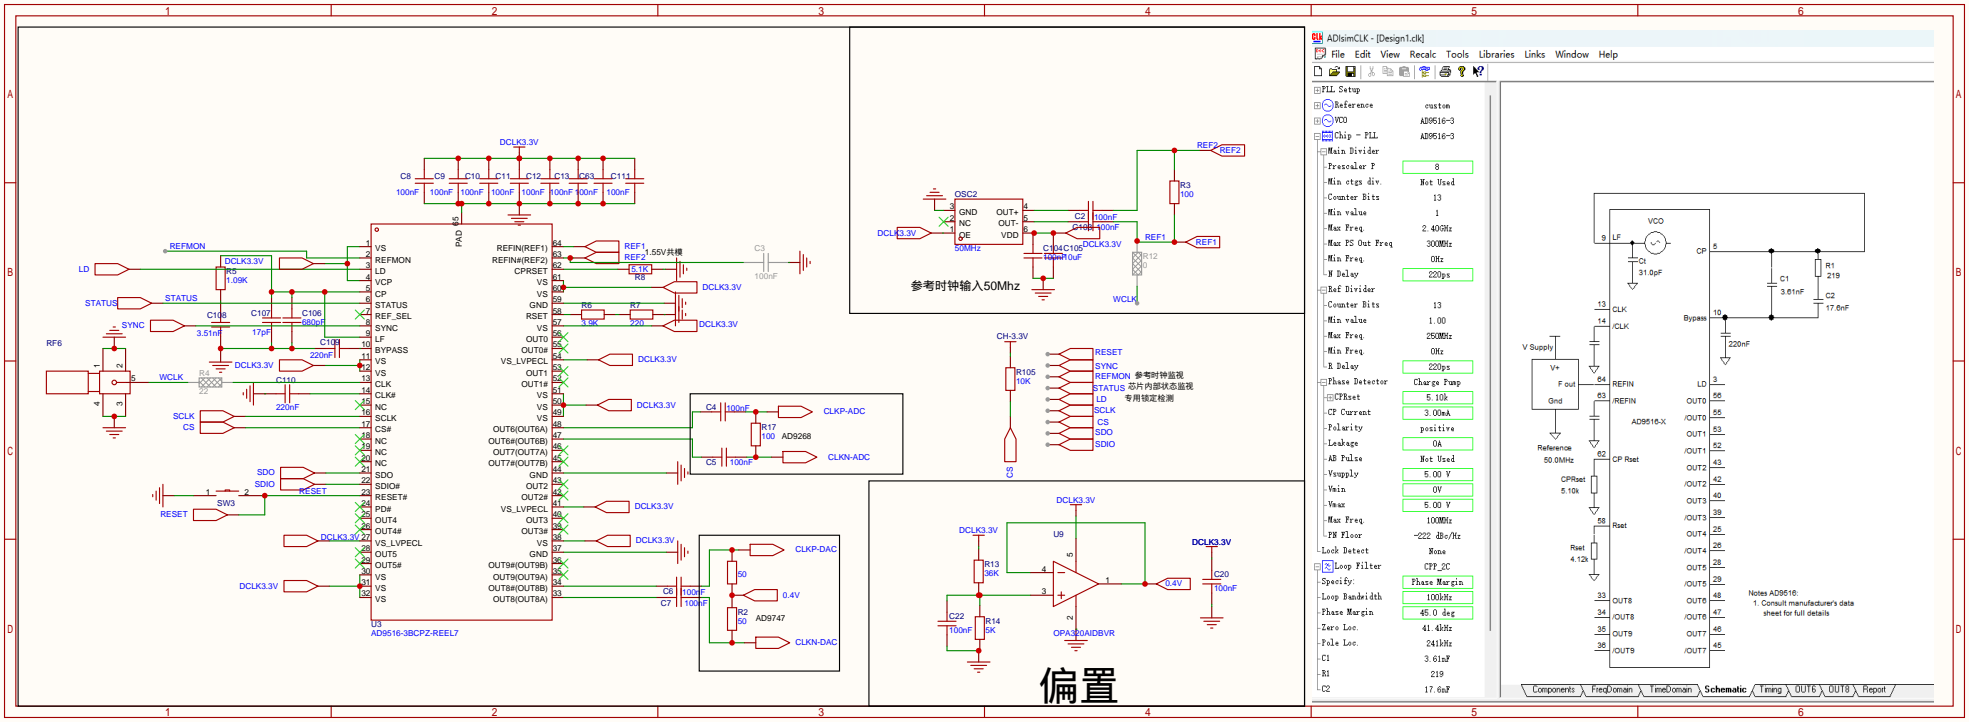
[picture p69: page 3]

ADC | DAC

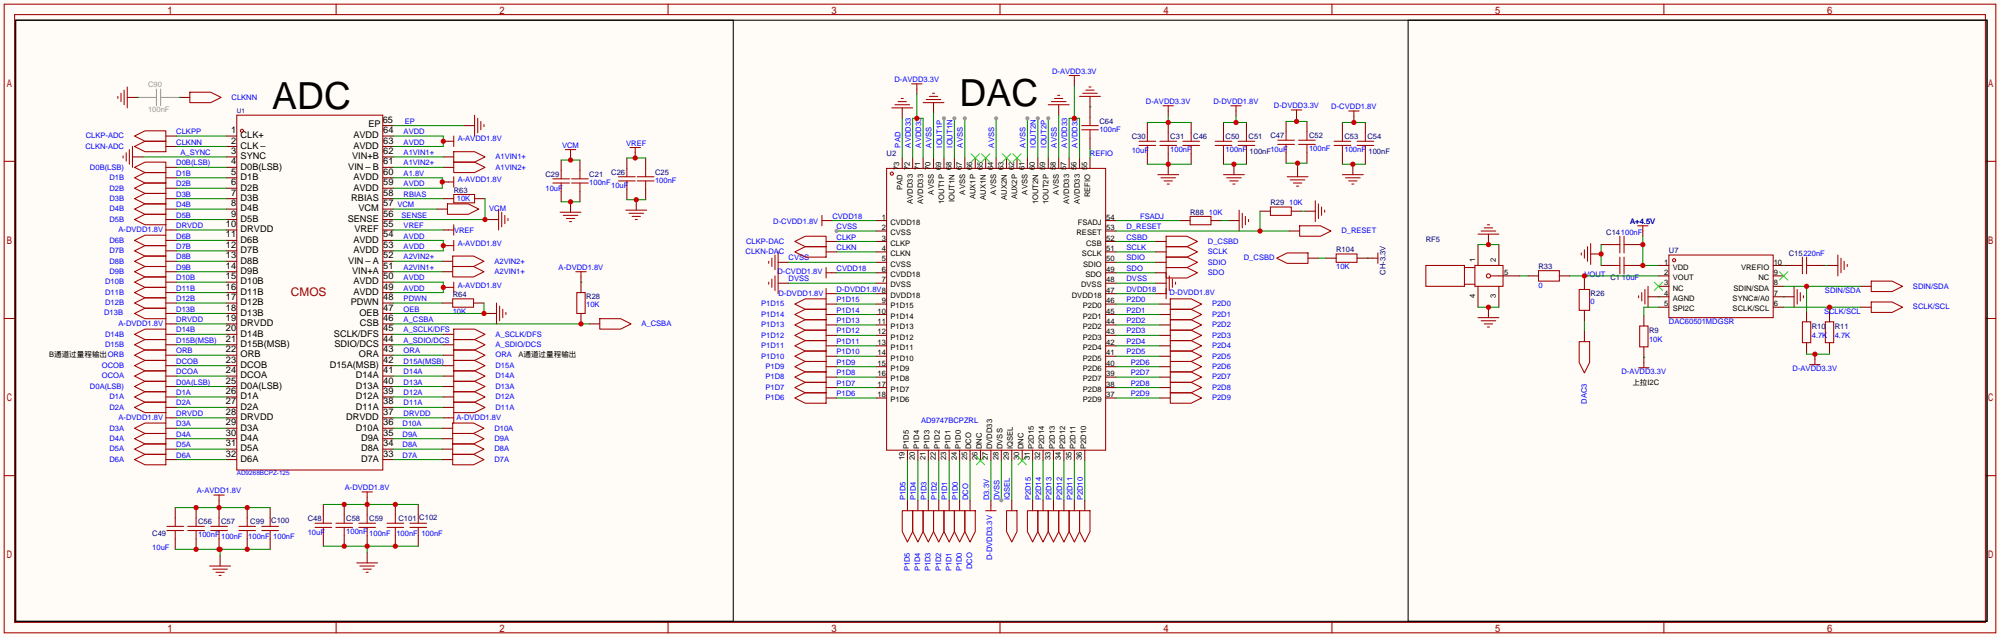
[picture p70: page 4]

P2D10 36 P2D9 37 P2D8 38 P2D7 39 P2D6 40 P2D5 41 P2D4 42 P2D3 43 P2D2 44 P2D1 45 P2D0 46 DVDD18 47 DVSS 48 SDO 49 SDIO 50 SCLK 51 CSB 52 RESET 53 FSADJ 54 REFIO 55 AVDD33 56

D7A 33 D6A 32 D5A 31 D4A 30 D3A 29 DRVDD 28 D2A 27 D1A 26 D0A(LSB) 25 DCOA 24 DCOB 23 ORB 22 D15B(MSB) 21 D14B 20 DRVDD 19 D13B 18 D12B 17 D11B 16 D10B 15 D9B 14 D8B 13 D7B 12 D6B 11 DRVDD 10 D5B 9

2DIR 24 | 2OE# 25 2A8 26 2A7 27 GND 28 2A6 29 2A5 30 VCCA 31 2A4 32 2A3 33 GND 34 2A2 35 2A1 36 1A8 37 1A7 38 GND 39 1A6 40 1A5 41 VCCA 42 1A4 43 1A3 44 GND 45 1A2 46 1A1 47 1OE# 48
2DIR 24 | 2OE# 25 2A8 26 2A7 27 GND 28 2A6 29 2A5 30 VCCA 31 2A4 32 2A3 33 GND 34 2A2 35 2A1 36 1A8 37 1A7 38 GND 39 1A6 40 1A5 41 VCCA 42 1A4 43 1A3 44 GND 45 1A2 46 1A1 47 1OE# 48

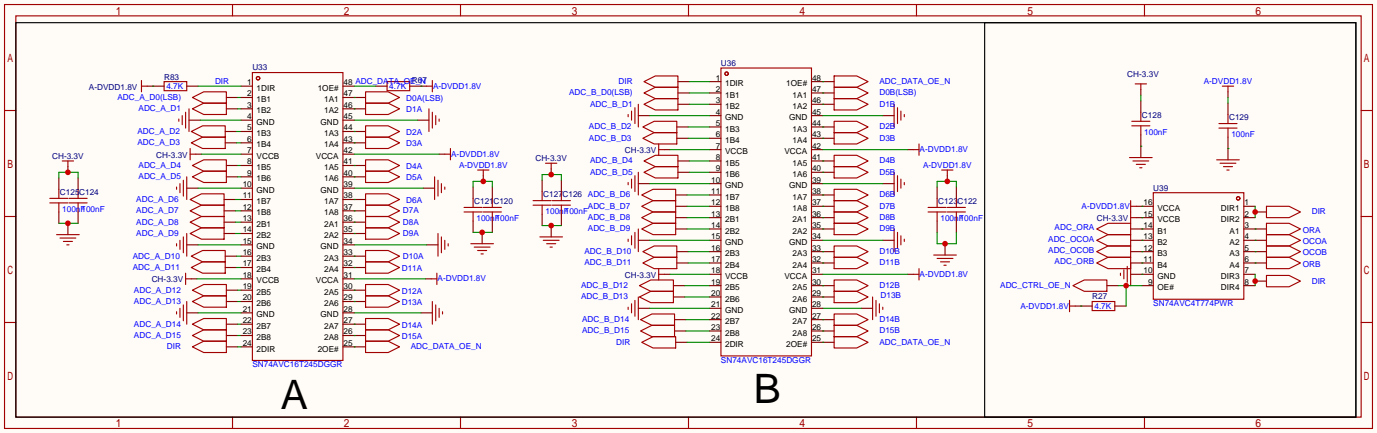
[picture p71: page 5]

±3.22V

# 输入范围±20V

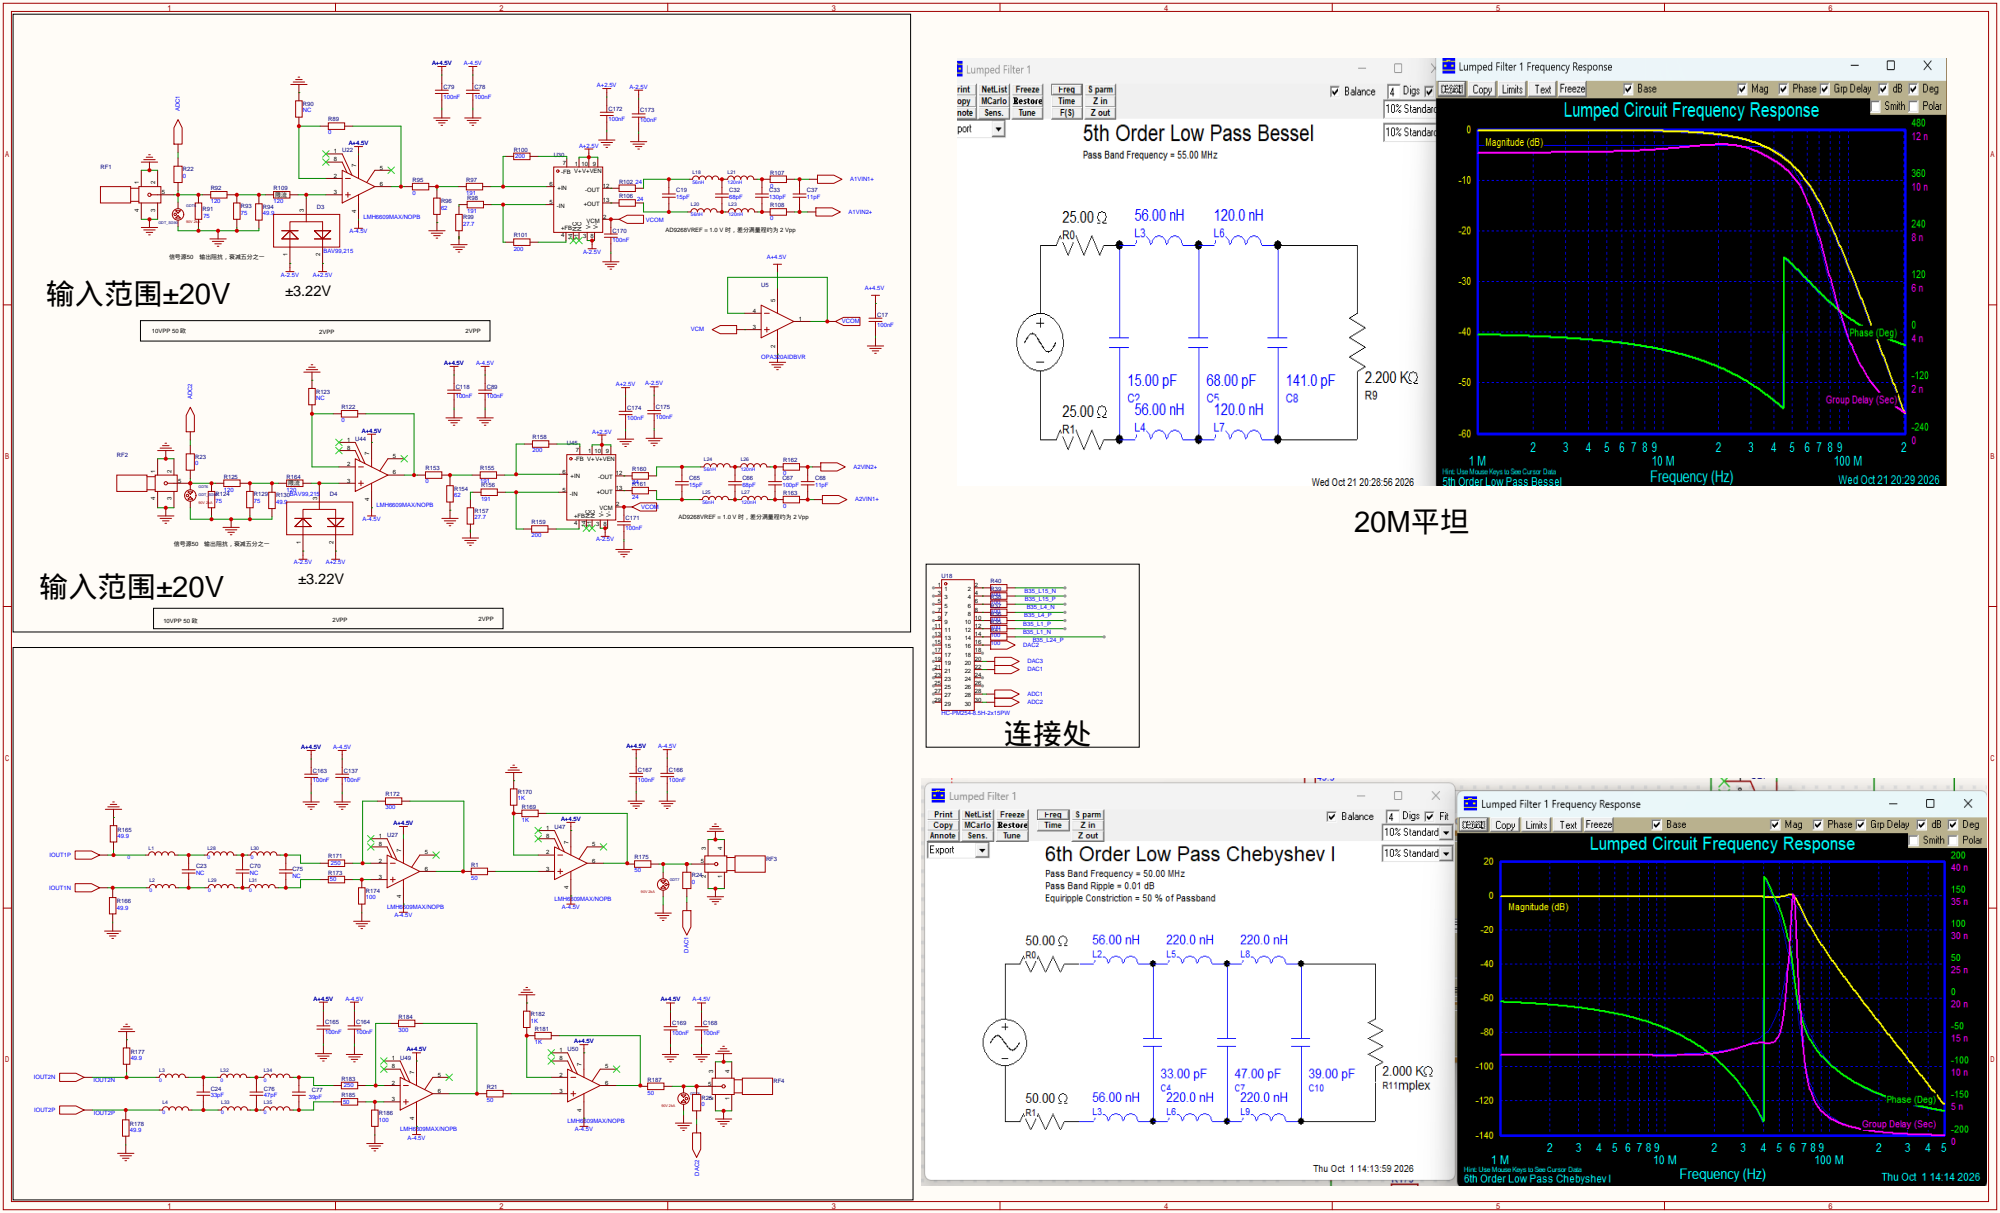
[picture p72: page 6]

# TYPE-C接口

# 20V转5.0V 4A

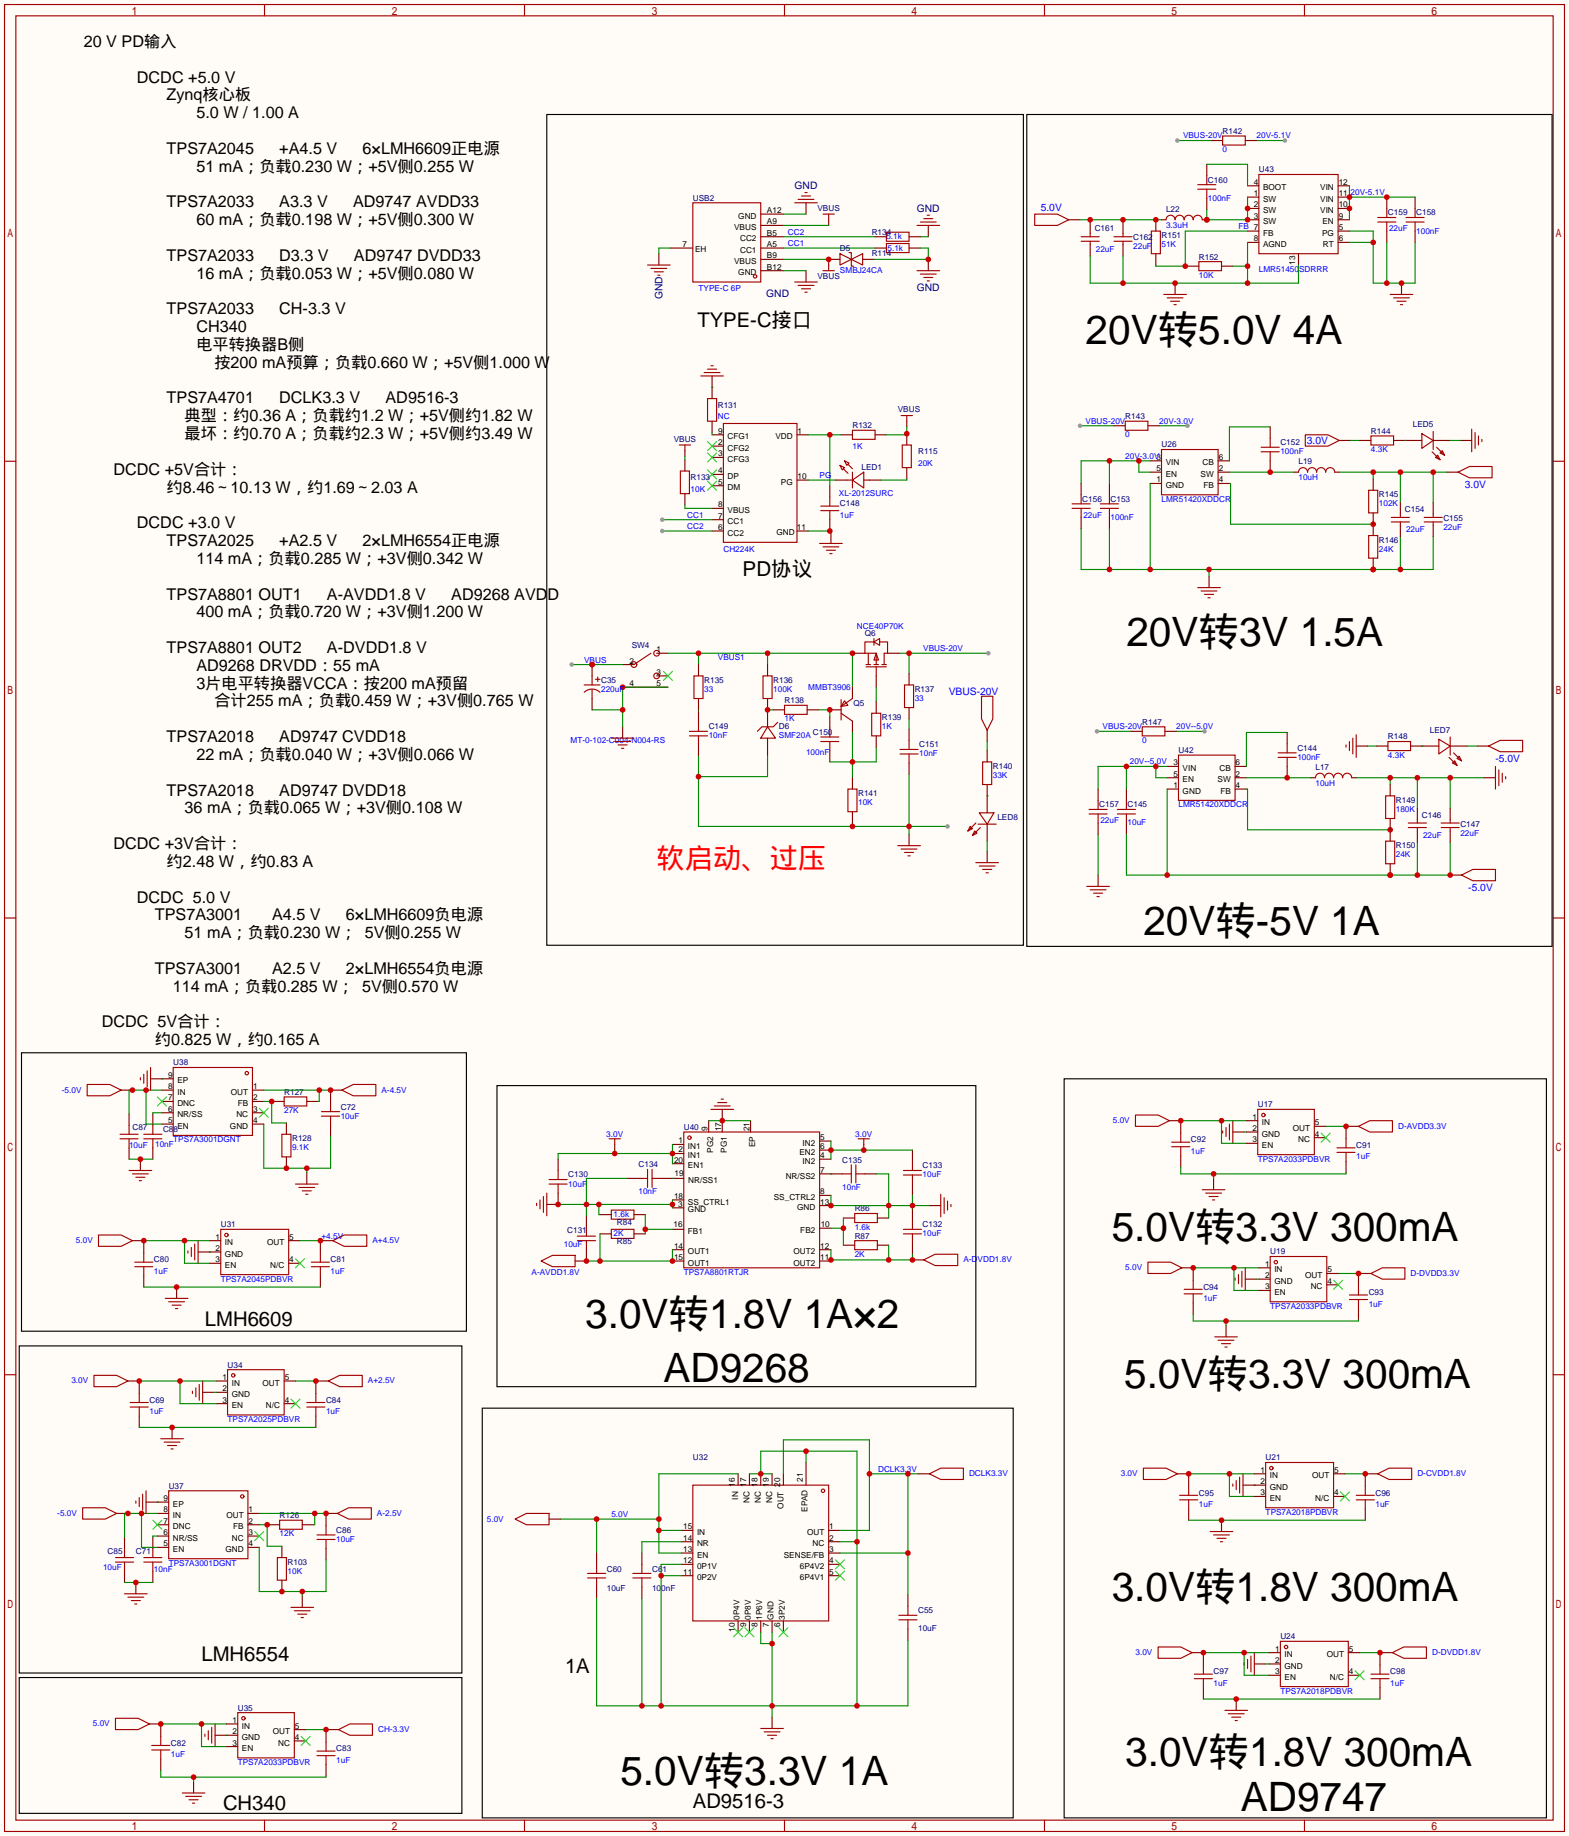
[picture p73: page 7]
