hscsja03-afk/-BJT-/(list of files, drawings)

Other design files:
board/hardware/adda/hardware_project.epro
