hscsja03-afk/-BJT-/(commit log)

2026-11-03 Add reusable competition skills with PYNQ and PCB validation tools
2026-11-04 FPGA 与上位机源码
2026-11-04 RTL 仿真与软件测试
2026-11-04 构建脚本与实现报告
2026-11-04 位流、上板脚本与实测输出
2026-11-04 校准表、参考曲线与器件手册
    [curves.csv]
2026-11-04 可复用校验与排错方法
2026-11-04 设计报告与验证记录
2026-11-04 缓存与构建产物忽略规则
2026-11-04 MIT 开源许可
2026-11-04 Python 依赖与打包配置
2026-11-04 工程文件 SHA256 清单
2026-11-04 工程介绍与运行步骤
2026-11-04 PNP 交流实测曲线与数据导出
2026-11-04 PNP 交流实测绘图测试
2026-11-04 校准数据与器件手册
    [curves.csv]
2026-11-04 构建脚本与运行库清单
2026-11-04 上位机程序与实测数据
2026-11-04 工程说明与验证记录
2026-11-04 工程目录与运行步骤
2026-11-04 工程文件校验清单
2026-11-04 大模型协作分析与方案取舍
2026-11-04 工程目录与材料入口
2026-11-04 ADDA 与 BJT 原理图、PCB 及硬件工程
    [design_notes.xlsx, hardware_project.epro]
2026-11-04 构建脚本与工程校验
2026-11-04 技能文档与使用方法
2026-11-04 多功能系统说明与硬件资料索引
2026-11-04 多功能三极管参数测量系统
2026-11-04 技能适用场景与迁移方法
2026-11-04 技能包独立使用说明与通用校验
2026-11-04 工程目录清单
2026-11-04 技能包 MIT 许可说明
2026-11-04 设计报告 PDF 与材料索引
2026-11-04 设计报告阅读入口
2026-11-04 设计报告 PDF
2026-11-04 设计报告 PDF 阅读入口
2026-11-04 FPGA 综合与实现脚本
2026-11-04 TX2/TX3 示波器比对记录
2026-11-04 RX1/RX2 采集与输入校准
2026-11-04 TX2/TX3 波形与输出校准
2026-11-04 ADC 采样时钟与频谱检查
2026-11-04 三极管接线、反馈与扫描检查
2026-11-04 DDR 初始化、训练与字节通道诊断
2026-11-04 TX1 总线、寄存器与输出检查
2026-11-04 TX2/TX3 波形、零点与稳定性检查
2026-11-04 ADDA 原理图、PCB 与器件配置
2026-11-04 三极管测试板原理图与 PCB
2026-11-04 LCD DDR 位流与硬件描述
2026-11-04 ADC 62.5 MHz 与 DAC 125 MHz 实现报告
2026-11-04 ADC/DAC 50 MHz 基线实现报告
2026-11-04 LCD DDR 2026-11-04 构建与实现报告
2026-11-04 LCD DDR 2026-11-03 实现报告
2026-11-04 ADC 125 MHz 与 DAC 250 MHz 时序报告
2026-11-04 器件参数与测量条件
2026-11-04 ADC、DAC 与三极管扫描比对表
    [adc_dc.csv, bjt_runs.csv, dac_scope.csv]
2026-11-04 仪器读数与波形来源
2026-11-04 PYNQ 位流与地址校验脚本
2026-11-04 PCB 芯片与测点定位脚本
2026-11-04 特性分析与测量流程测试
2026-11-04 设备驱动、测量分析与图形界面
2026-11-04 触摸屏控制逻辑
2026-11-04 测量记录分析与图表导出
2026-11-04 裸机程序与启动映像
2026-11-04 Zynq 启动、JTAG 与系统检查
2026-11-04 ADC 与 DAC 校准工具
2026-11-04 PS 配置与 OCM 链接脚本
2026-11-04 SSH、串口与设备连接
2026-11-04 上位机运行库与操作说明
2026-11-04 采样、输出、DDR 与器件诊断
2026-11-04 ADDA 与 BJT 硬件设计资料
2026-11-04 示波器通信与波形测量
2026-11-04 LCD 显示、帧缓冲与设备控制
2026-11-04 PYNQ 交互测量示例
2026-11-04 FPGA 位流、硬件描述与地址配置
2026-11-04 三极管实测记录与曲线数据
2026-11-04 板端 Python 安装包
2026-11-04 板端代理与开机启动
2026-11-04 QSPI 与 eMMC 映像工具
2026-11-04 TX1 总线隔离实验文件
2026-11-04 工程校验、归档读取与测量汇总
2026-11-04 Python 环境与仪器依赖
2026-11-04 FPGA 工程创建与时序检查
2026-11-04 FPGA 各版本资源与时序报告
2026-11-04 上位机打包与 Notebook 生成
2026-11-04 器件手册与参数资料
2026-11-04 采集、校准与板级实验数据归档
2026-11-04 ADC、DAC 与三极管实测比对
2026-11-04 上位机界面资源
2026-11-04 启动、接口与板级实测记录
2026-11-04 工程、报告与数据索引
2026-11-04 实测指标统计
2026-11-04 软件、程序包与工程校验记录
2026-11-04 裸机 C 驱动与时间基准测试
2026-11-04 仿真测试输入
2026-11-04 驱动、扫描、分析与界面测试
2026-11-04 RTL、软件与程序运行结果
2026-11-04 AXI、ADC、DAC 与 LCD 仿真
2026-11-04 器件参数提取与页码追溯
2026-11-04 上位机、板端代理与运行资源
2026-11-04 FPGA 工程构建与时序分析
2026-11-04 测量扫描、数据完整性与性能
2026-11-04 ADC/DAC 校准与误差分析
2026-11-04 PYNQ 位流、HWH 与地址校验
2026-11-04 寄存器、PCB 与模拟链路定位
2026-11-04 技术材料与证据图编排
2026-11-04 实验记录与参数表模板
2026-11-04 Zynq 启动与 DDR 诊断
2026-11-04 LCD 字体与显示资源
2026-11-04 裸机驱动、启动与时间基准
2026-11-04 FPGA 引脚、电平与时序约束
2026-11-04 测量驱动、板端代理与上位机程序
2026-11-04 ADDA、AXI、时钟与显示逻辑
2026-11-04 硬件设计、位流与上板工具
2026-11-04 构建脚本、依赖与实现报告
2026-11-04 校准参数、器件手册与实测数据
2026-11-04 设计报告、实测结果与协作记录
2026-11-04 可复用技能、模板与校验工具
2026-11-04 FPGA、板端与上位机源码
2026-11-04 缓存与运行产物忽略规则
2026-11-04 项目功能、工程目录与运行说明
